NicholasTran/G8_SwishSwooshSwordSimulator/src/mid_demo/mid_demo.runs/impl_1/.init_design.begin.rst

<?xml version="1.0"?>
<ProcessHandle Version="1" Minor="0">
    <Process Command=".planAhead." Owner="Sam" Host="THEDESKTOP" Pid="17220">
    </Process>
</ProcessHandle>
