NicholasTran/G8_SwishSwooshSwordSimulator/src/mid_demo/mid_demo.runs/impl_1/.vivado.begin.rst

<?xml version="1.0"?>
<ProcessHandle Version="1" Minor="0">
    <Process Command="vivado.bat" Owner="Sam" Host="THEDESKTOP" Pid="20408">
    </Process>
</ProcessHandle>
