NicholasTran/G8_SwishSwooshSwordSimulator/src/mid_demo/mid_demo.runs/mid_project_axi_uartlite_0_0_synth_1/.vivado.begin.rst

<?xml version="1.0"?>
<ProcessHandle Version="1" Minor="0">
    <Process Command="vivado.bat" Owner="hopmanha" Host="BA3135WS29" Pid="11088">
    </Process>
</ProcessHandle>
