NicholasTran/G8_SwishSwooshSwordSimulator/docs/Presentation.pdf

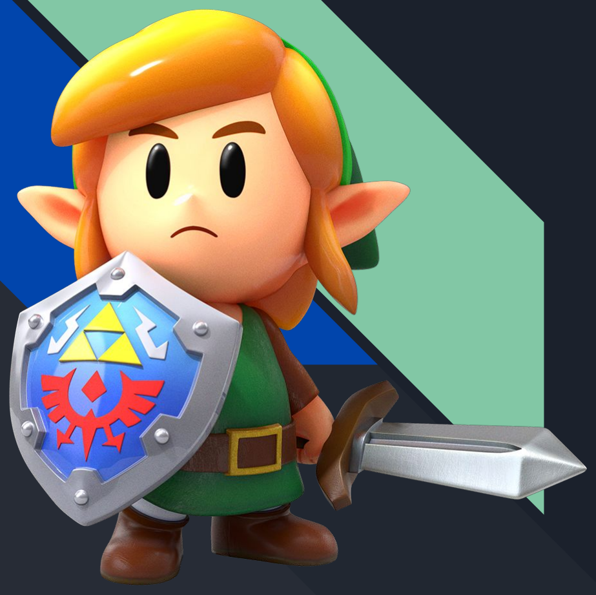
[picture p13: figure]

ECE532 - Final Demo

Gavin Gu
Nick Tran
Harry Hopman
Samuel Zheng

# Swish Slash Swoosh Super Savage Sword-Swinging Simulator 2023

## ver 2.23α (https://en.wiktionary.org/wiki/%CE%B1) (Final Release)

# Overview

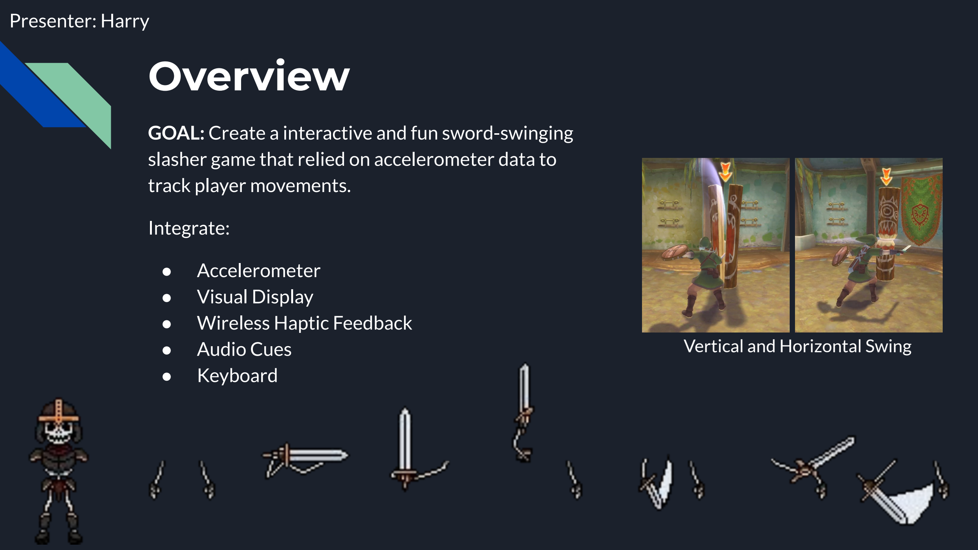
[picture p14: page 2]

Vertical and Horizontal Swing

GOAL: Create a interactive and fun sword-swinging slasher game that relied on accelerometer data to track player movements.

Integrate:

- Accelerometer
- Visual Display
- Wireless Haptic Feedback
- Audio Cues
- Keyboard

Presenter: Harry

# Initial Block Diagram

Presenter: Sam

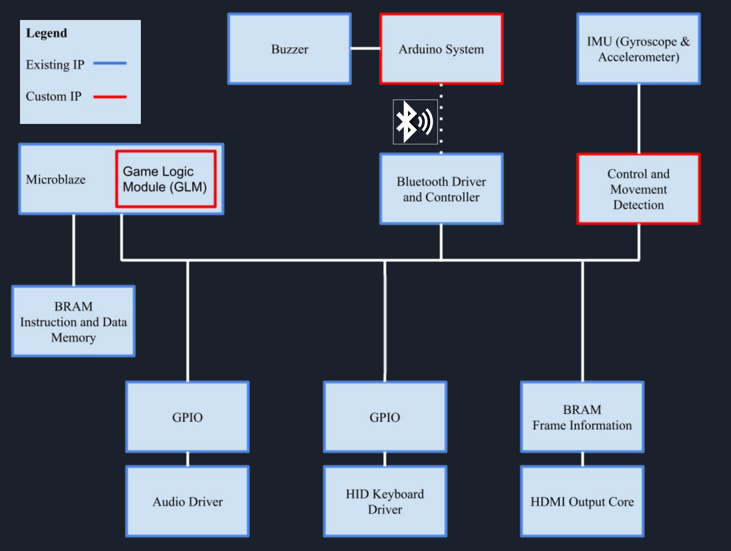
[picture p15: figure]

Microblaze

Audio Core

Game Logic &
Movement
Detection

AXI TFT
Controller

AXI Bus

BT2 Bluetooth
Controller

Instruction &
Data BRAM

VGA Monitor

DDR2 Double
Frame Buffer

Arduino
System

Vibration
Motor

NAV
Accelerometer

USB
Keyboard

New/Modified Blocks
(From Initial Proposal)

Presenter: Sam

# Final Block Diagram

7 Seg
Display

# Switch from Nexys Video to Nexys 4 DDR

Presenter: Nick

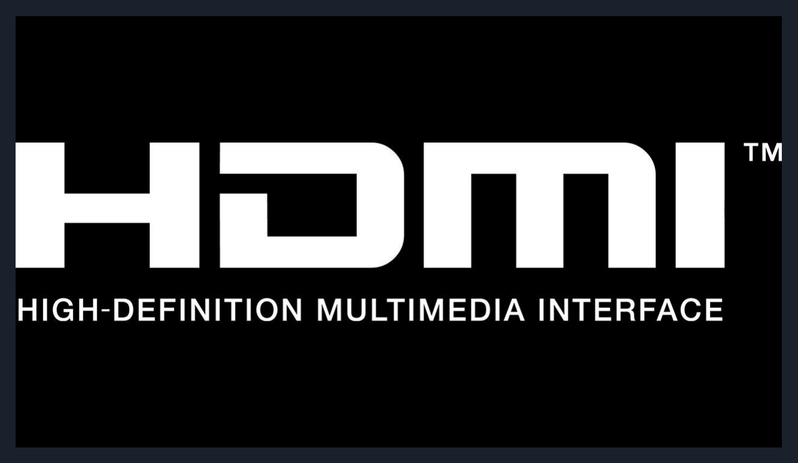
[picture p16: figure]
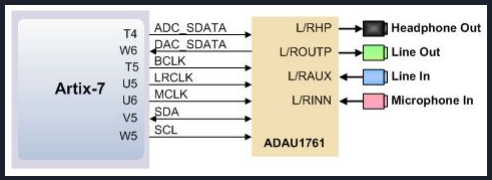
[picture p17: figure]

- Broken, outdated demos
- Lack of documentation
- Huge Complexity Jump

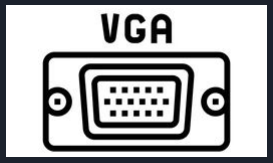
[picture p18: figure]
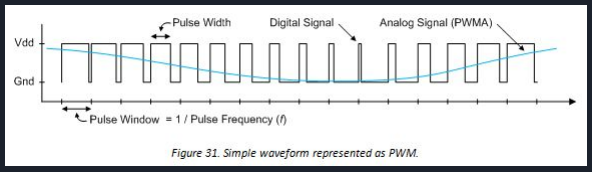
[picture p19: figure]

- Simpler Interfaces
- More Documentation
- Previous Experience

# Code/Block Originality

Original | Borrowed / Modified

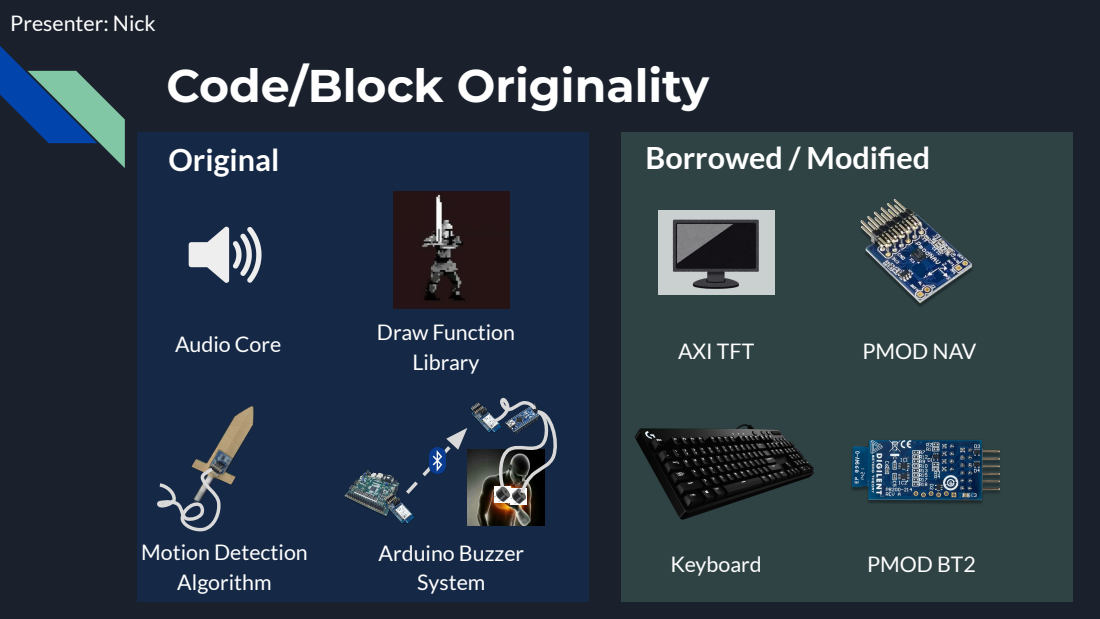
[picture p20: page 6]
Presenter: Nick; Audio Core; AXI TFT; Motion Detection Algorithm; Draw Function; Library; PMOD NAV; PMOD BT2

Keyboard Arduino Buzzer
System

# Custom Audio Core

- Each note encoded as 16-bit value, stored in ROM block
- Decode this value to get variables needed to play note as PWM wave
- Frequency, duty cycle, etc.
- Songs and SFX are sequences of these notes w/ duration

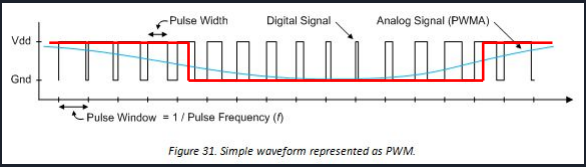
[picture p21: figure]

# Draw Function Library

SwapDrawBuffers()

Buffer 1

Buffer 2

BRAM | DrawEnemy
AXI TFT | Convert16bpp24 | DrawPixel

# Motion Detection Algorithm

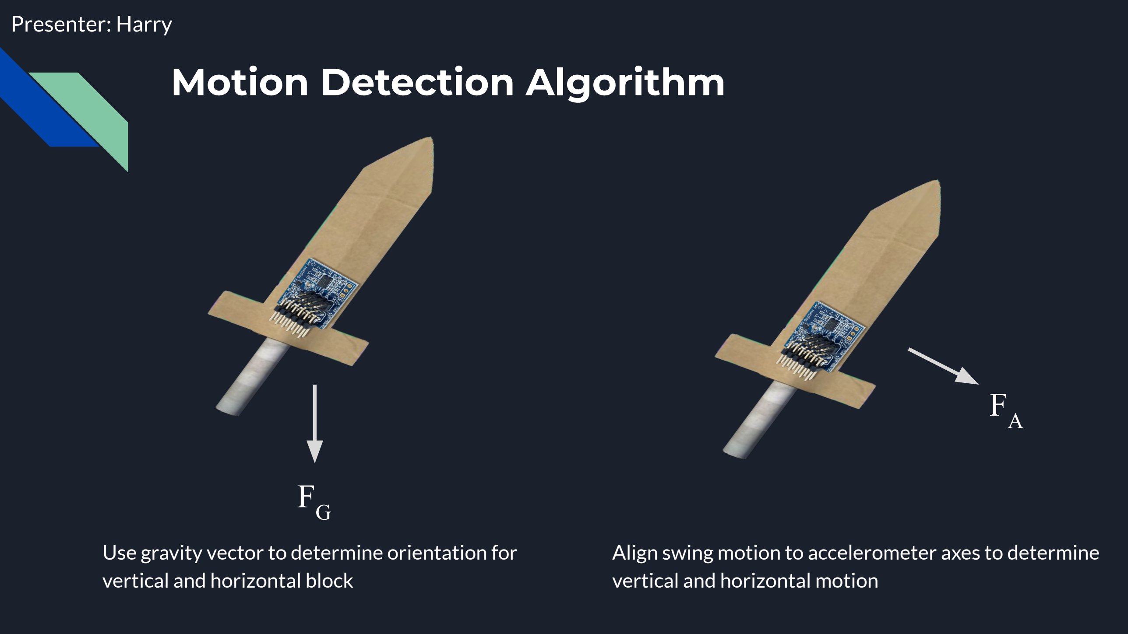
[picture p22: page 9]

Use gravity vector to determine orientation for vertical and horizontal block

Align swing motion to accelerometer axes to determine vertical and horizontal motion

FG

FA

Presenter: Harry

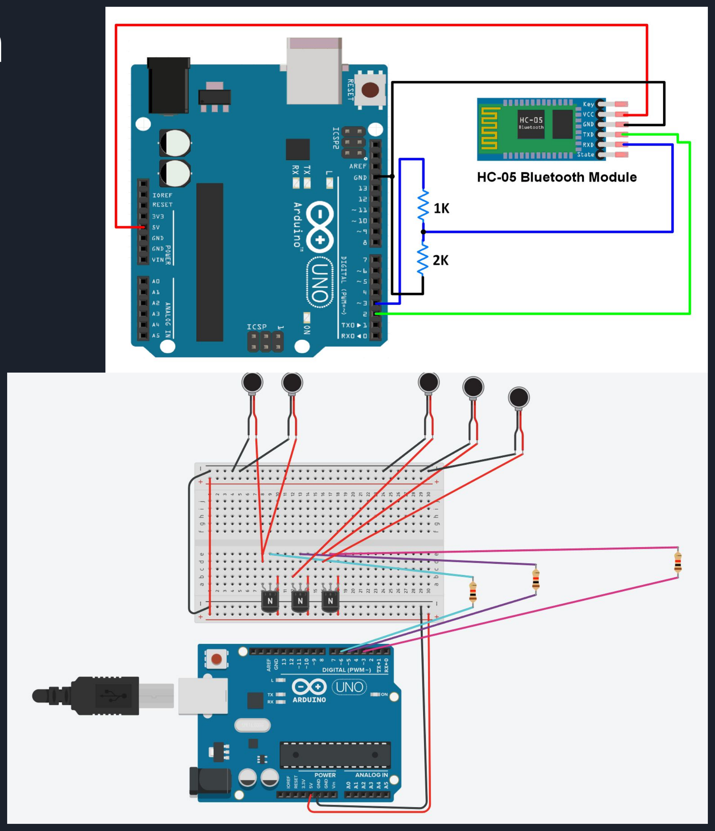
[picture p23: figure]

# Arduino Buzzer System

Sequence of events:

- PMOD BT-2 initializes as master
- When powered, auto connects to HC-05 slave address at specified 115200 baud rate
- Serial connection established, status LED on HC-05 slowly blinks
- HC-05 waits for BT-2 to send commands to activate vibration motors through Arduino based on vertical or horizontal slash

Presenter: Gavin

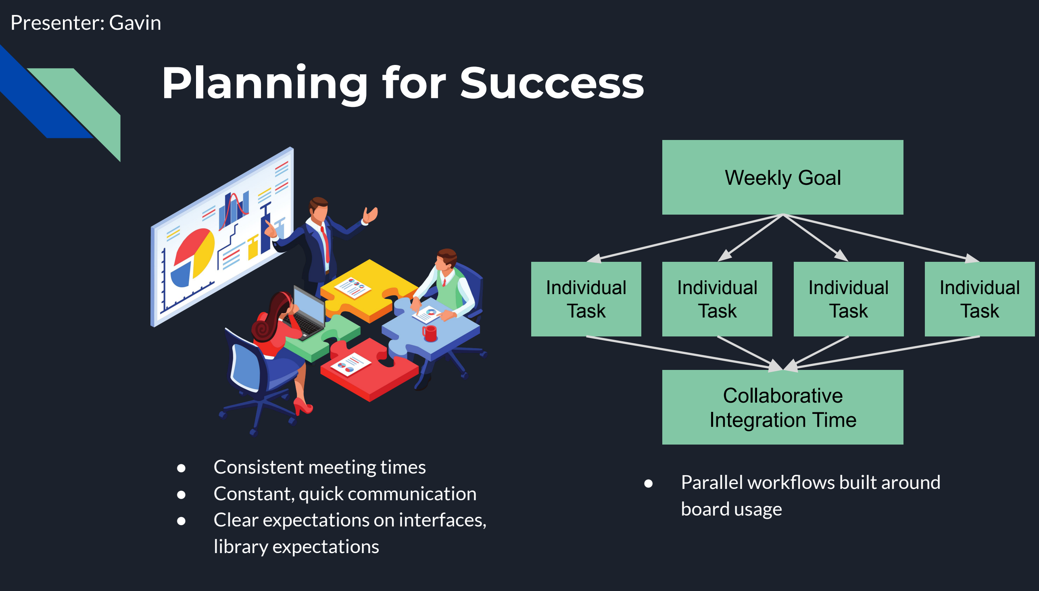
[picture p24: figure]
Planning for Success; Presenter: Gavin; ● Consistent meeting times ● Constant, quick communication ● Clear expectations on interfaces, library expectations; Weekly Goal; ● Parallel workflows built around board usage; Individual Task; Collaborative Integration Time

# Learnings

- Hands on experience designing around an AXI system
- Designing with large systems / multiple individual code blocks / multiple designers
- What Pulse Wave Modulation (PWM) is and how to implement in via square waves
- Learned how to pair a different bluetooth module to the PMOD BT2
- General hardware design debugging tips
- Good idea to start over when encountering odd bugs
- Debugging unpredictable issues
- Working as a team

Presenter: Harry

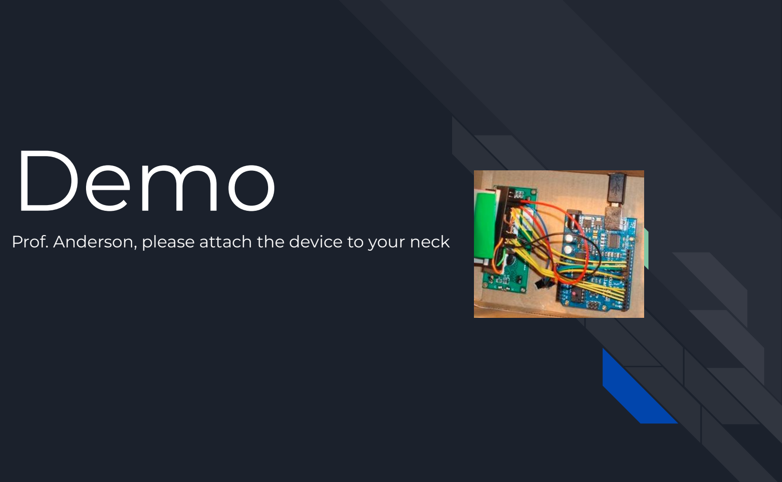
[picture p25: figure]
Demo

### Prof. Anderson, please attach the device to your neck

# Custom Audio Core

- Each note has individual frequency
- Duty cycle needs to slowly increase or decrease
- Unique to each frequency (note)
- Calculated beforehand and stored in ROM to avoid messy division

during runtime

- Each song is a sequence of notes with a duration

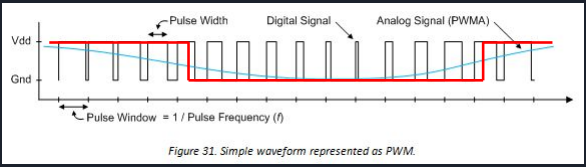
[picture p26: figure]
