NicholasTran/G8_SwishSwooshSwordSimulator/src/mid_demo/mid_demo.runs/mid_project_PmodNAV_0_0_synth_1/.Xil/mid_project_PmodNAV_0_0_propImpl.xdc

set_property SRC_FILE_INFO {cfile:d:/ece532/mid_demo/mid_demo/mid_demo.srcs/sources_1/bd/mid_project/ip/mid_project_PmodNAV_0_0/mid_project_PmodNAV_0_0_board.xdc rfile:../../../mid_demo.srcs/sources_1/bd/mid_project/ip/mid_project_PmodNAV_0_0/mid_project_PmodNAV_0_0_board.xdc id:1 order:EARLY used_in_board:yes scoped_inst:inst prop_thru_buffer:yes} [current_design]
set_property SRC_FILE_INFO {cfile:C:/DESL/Xilinx/Vivado/2018.3/data/ip/xpm/xpm_cdc/tcl/xpm_cdc_gray.tcl rfile:C:/DESL/Xilinx/Vivado/2018.3/data/ip/xpm/xpm_cdc/tcl/xpm_cdc_gray.tcl id:2 order:LATE scoped_inst:inst/axi_quad_spi_0/U0/NO_DUAL_QUAD_MODE.QSPI_NORMAL/QSPI_LEGACY_MD_GEN.QSPI_CORE_INTERFACE_I/FIFO_EXISTS.RX_FIFO_II/xpm_fifo_instance.xpm_fifo_async_inst/gnuram_async_fifo.xpm_fifo_base_inst/gen_cdc_pntr.rd_pntr_cdc_inst unmanaged:yes} [current_design]
set_property SRC_FILE_INFO {cfile:C:/DESL/Xilinx/Vivado/2018.3/data/ip/xpm/xpm_cdc/tcl/xpm_cdc_gray.tcl rfile:C:/DESL/Xilinx/Vivado/2018.3/data/ip/xpm/xpm_cdc/tcl/xpm_cdc_gray.tcl id:3 order:LATE scoped_inst:inst/axi_quad_spi_0/U0/NO_DUAL_QUAD_MODE.QSPI_NORMAL/QSPI_LEGACY_MD_GEN.QSPI_CORE_INTERFACE_I/FIFO_EXISTS.RX_FIFO_II/xpm_fifo_instance.xpm_fifo_async_inst/gnuram_async_fifo.xpm_fifo_base_inst/gen_cdc_pntr.wr_pntr_cdc_inst unmanaged:yes} [current_design]
set_property SRC_FILE_INFO {cfile:C:/DESL/Xilinx/Vivado/2018.3/data/ip/xpm/xpm_cdc/tcl/xpm_cdc_gray.tcl rfile:C:/DESL/Xilinx/Vivado/2018.3/data/ip/xpm/xpm_cdc/tcl/xpm_cdc_gray.tcl id:4 order:LATE scoped_inst:inst/axi_quad_spi_0/U0/NO_DUAL_QUAD_MODE.QSPI_NORMAL/QSPI_LEGACY_MD_GEN.QSPI_CORE_INTERFACE_I/FIFO_EXISTS.TX_FIFO_II/xpm_fifo_instance.xpm_fifo_async_inst/gnuram_async_fifo.xpm_fifo_base_inst/gen_cdc_pntr.rd_pntr_cdc_inst unmanaged:yes} [current_design]
set_property SRC_FILE_INFO {cfile:C:/DESL/Xilinx/Vivado/2018.3/data/ip/xpm/xpm_cdc/tcl/xpm_cdc_gray.tcl rfile:C:/DESL/Xilinx/Vivado/2018.3/data/ip/xpm/xpm_cdc/tcl/xpm_cdc_gray.tcl id:5 order:LATE scoped_inst:inst/axi_quad_spi_0/U0/NO_DUAL_QUAD_MODE.QSPI_NORMAL/QSPI_LEGACY_MD_GEN.QSPI_CORE_INTERFACE_I/FIFO_EXISTS.TX_FIFO_II/xpm_fifo_instance.xpm_fifo_async_inst/gnuram_async_fifo.xpm_fifo_base_inst/gen_cdc_pntr.wr_pntr_cdc_inst unmanaged:yes} [current_design]
set_property SRC_FILE_INFO {cfile:C:/DESL/Xilinx/Vivado/2018.3/data/ip/xpm/xpm_cdc/tcl/xpm_cdc_gray.tcl rfile:C:/DESL/Xilinx/Vivado/2018.3/data/ip/xpm/xpm_cdc/tcl/xpm_cdc_gray.tcl id:6 order:LATE scoped_inst:inst/axi_quad_spi_0/U0/NO_DUAL_QUAD_MODE.QSPI_NORMAL/QSPI_LEGACY_MD_GEN.QSPI_CORE_INTERFACE_I/FIFO_EXISTS.RX_FIFO_II/xpm_fifo_instance.xpm_fifo_async_inst/gnuram_async_fifo.xpm_fifo_base_inst/gen_cdc_pntr.wr_pntr_cdc_dc_inst unmanaged:yes} [current_design]
set_property SRC_FILE_INFO {cfile:C:/DESL/Xilinx/Vivado/2018.3/data/ip/xpm/xpm_cdc/tcl/xpm_cdc_gray.tcl rfile:C:/DESL/Xilinx/Vivado/2018.3/data/ip/xpm/xpm_cdc/tcl/xpm_cdc_gray.tcl id:7 order:LATE scoped_inst:inst/axi_quad_spi_0/U0/NO_DUAL_QUAD_MODE.QSPI_NORMAL/QSPI_LEGACY_MD_GEN.QSPI_CORE_INTERFACE_I/FIFO_EXISTS.TX_FIFO_II/xpm_fifo_instance.xpm_fifo_async_inst/gnuram_async_fifo.xpm_fifo_base_inst/gen_cdc_pntr.wr_pntr_cdc_dc_inst unmanaged:yes} [current_design]
set_property SRC_FILE_INFO {cfile:C:/DESL/Xilinx/Vivado/2018.3/data/ip/xpm/xpm_cdc/tcl/xpm_cdc_gray.tcl rfile:C:/DESL/Xilinx/Vivado/2018.3/data/ip/xpm/xpm_cdc/tcl/xpm_cdc_gray.tcl id:8 order:LATE scoped_inst:inst/axi_quad_spi_0/U0/NO_DUAL_QUAD_MODE.QSPI_NORMAL/QSPI_LEGACY_MD_GEN.QSPI_CORE_INTERFACE_I/FIFO_EXISTS.RX_FIFO_II/xpm_fifo_instance.xpm_fifo_async_inst/gnuram_async_fifo.xpm_fifo_base_inst/gen_cdc_pntr.rd_pntr_cdc_dc_inst unmanaged:yes} [current_design]
set_property SRC_FILE_INFO {cfile:C:/DESL/Xilinx/Vivado/2018.3/data/ip/xpm/xpm_cdc/tcl/xpm_cdc_gray.tcl rfile:C:/DESL/Xilinx/Vivado/2018.3/data/ip/xpm/xpm_cdc/tcl/xpm_cdc_gray.tcl id:9 order:LATE scoped_inst:inst/axi_quad_spi_0/U0/NO_DUAL_QUAD_MODE.QSPI_NORMAL/QSPI_LEGACY_MD_GEN.QSPI_CORE_INTERFACE_I/FIFO_EXISTS.TX_FIFO_II/xpm_fifo_instance.xpm_fifo_async_inst/gnuram_async_fifo.xpm_fifo_base_inst/gen_cdc_pntr.rd_pntr_cdc_dc_inst unmanaged:yes} [current_design]
current_instance inst
set_property src_info {type:SCOPED_XDC file:1 line:3 export:INPUT save:INPUT read:READ} [current_design]
set_property BOARD_PIN {JA1} [get_ports Pmod_out_pin1_t]
set_property src_info {type:SCOPED_XDC file:1 line:9 export:INPUT save:INPUT read:READ} [current_design]
set_property BOARD_PIN {JA9} [get_ports Pmod_out_pin9_t]
set_property src_info {type:SCOPED_XDC file:1 line:10 export:INPUT save:INPUT read:READ} [current_design]
set_property BOARD_PIN {JA10} [get_ports Pmod_out_pin10_t]
current_instance
current_instance inst/axi_quad_spi_0/U0/NO_DUAL_QUAD_MODE.QSPI_NORMAL/QSPI_LEGACY_MD_GEN.QSPI_CORE_INTERFACE_I/FIFO_EXISTS.RX_FIFO_II/xpm_fifo_instance.xpm_fifo_async_inst/gnuram_async_fifo.xpm_fifo_base_inst/gen_cdc_pntr.rd_pntr_cdc_inst
set_property src_info {type:SCOPED_XDC file:2 line:23 export:INPUT save:NONE read:READ} [current_design]
create_waiver -internal -type CDC -id {CDC-6} -user "xpm_cdc" -desc "The CDC-6 warning is waived as it is safe in the context of XPM_CDC_GRAY." -from [get_pins -quiet {src_gray_ff_reg*/C}] -to [get_pins -quiet {dest_graysync_ff_reg*/D}]
current_instance
current_instance inst/axi_quad_spi_0/U0/NO_DUAL_QUAD_MODE.QSPI_NORMAL/QSPI_LEGACY_MD_GEN.QSPI_CORE_INTERFACE_I/FIFO_EXISTS.RX_FIFO_II/xpm_fifo_instance.xpm_fifo_async_inst/gnuram_async_fifo.xpm_fifo_base_inst/gen_cdc_pntr.wr_pntr_cdc_inst
set_property src_info {type:SCOPED_XDC file:3 line:23 export:INPUT save:NONE read:READ} [current_design]
create_waiver -internal -type CDC -id {CDC-6} -user "xpm_cdc" -desc "The CDC-6 warning is waived as it is safe in the context of XPM_CDC_GRAY." -from [get_pins -quiet {src_gray_ff_reg*/C}] -to [get_pins -quiet {dest_graysync_ff_reg*/D}]
current_instance
current_instance inst/axi_quad_spi_0/U0/NO_DUAL_QUAD_MODE.QSPI_NORMAL/QSPI_LEGACY_MD_GEN.QSPI_CORE_INTERFACE_I/FIFO_EXISTS.TX_FIFO_II/xpm_fifo_instance.xpm_fifo_async_inst/gnuram_async_fifo.xpm_fifo_base_inst/gen_cdc_pntr.rd_pntr_cdc_inst
set_property src_info {type:SCOPED_XDC file:4 line:23 export:INPUT save:NONE read:READ} [current_design]
create_waiver -internal -type CDC -id {CDC-6} -user "xpm_cdc" -desc "The CDC-6 warning is waived as it is safe in the context of XPM_CDC_GRAY." -from [get_pins -quiet {src_gray_ff_reg*/C}] -to [get_pins -quiet {dest_graysync_ff_reg*/D}]
current_instance
current_instance inst/axi_quad_spi_0/U0/NO_DUAL_QUAD_MODE.QSPI_NORMAL/QSPI_LEGACY_MD_GEN.QSPI_CORE_INTERFACE_I/FIFO_EXISTS.TX_FIFO_II/xpm_fifo_instance.xpm_fifo_async_inst/gnuram_async_fifo.xpm_fifo_base_inst/gen_cdc_pntr.wr_pntr_cdc_inst
set_property src_info {type:SCOPED_XDC file:5 line:23 export:INPUT save:NONE read:READ} [current_design]
create_waiver -internal -type CDC -id {CDC-6} -user "xpm_cdc" -desc "The CDC-6 warning is waived as it is safe in the context of XPM_CDC_GRAY." -from [get_pins -quiet {src_gray_ff_reg*/C}] -to [get_pins -quiet {dest_graysync_ff_reg*/D}]
current_instance
current_instance inst/axi_quad_spi_0/U0/NO_DUAL_QUAD_MODE.QSPI_NORMAL/QSPI_LEGACY_MD_GEN.QSPI_CORE_INTERFACE_I/FIFO_EXISTS.RX_FIFO_II/xpm_fifo_instance.xpm_fifo_async_inst/gnuram_async_fifo.xpm_fifo_base_inst/gen_cdc_pntr.wr_pntr_cdc_dc_inst
set_property src_info {type:SCOPED_XDC file:6 line:23 export:INPUT save:NONE read:READ} [current_design]
create_waiver -internal -type CDC -id {CDC-6} -user "xpm_cdc" -desc "The CDC-6 warning is waived as it is safe in the context of XPM_CDC_GRAY." -from [get_pins -quiet {src_gray_ff_reg*/C}] -to [get_pins -quiet {dest_graysync_ff_reg*/D}]
current_instance
current_instance inst/axi_quad_spi_0/U0/NO_DUAL_QUAD_MODE.QSPI_NORMAL/QSPI_LEGACY_MD_GEN.QSPI_CORE_INTERFACE_I/FIFO_EXISTS.TX_FIFO_II/xpm_fifo_instance.xpm_fifo_async_inst/gnuram_async_fifo.xpm_fifo_base_inst/gen_cdc_pntr.wr_pntr_cdc_dc_inst
set_property src_info {type:SCOPED_XDC file:7 line:23 export:INPUT save:NONE read:READ} [current_design]
create_waiver -internal -type CDC -id {CDC-6} -user "xpm_cdc" -desc "The CDC-6 warning is waived as it is safe in the context of XPM_CDC_GRAY." -from [get_pins -quiet {src_gray_ff_reg*/C}] -to [get_pins -quiet {dest_graysync_ff_reg*/D}]
current_instance
current_instance inst/axi_quad_spi_0/U0/NO_DUAL_QUAD_MODE.QSPI_NORMAL/QSPI_LEGACY_MD_GEN.QSPI_CORE_INTERFACE_I/FIFO_EXISTS.RX_FIFO_II/xpm_fifo_instance.xpm_fifo_async_inst/gnuram_async_fifo.xpm_fifo_base_inst/gen_cdc_pntr.rd_pntr_cdc_dc_inst
set_property src_info {type:SCOPED_XDC file:8 line:23 export:INPUT save:NONE read:READ} [current_design]
create_waiver -internal -type CDC -id {CDC-6} -user "xpm_cdc" -desc "The CDC-6 warning is waived as it is safe in the context of XPM_CDC_GRAY." -from [get_pins -quiet {src_gray_ff_reg*/C}] -to [get_pins -quiet {dest_graysync_ff_reg*/D}]
current_instance
current_instance inst/axi_quad_spi_0/U0/NO_DUAL_QUAD_MODE.QSPI_NORMAL/QSPI_LEGACY_MD_GEN.QSPI_CORE_INTERFACE_I/FIFO_EXISTS.TX_FIFO_II/xpm_fifo_instance.xpm_fifo_async_inst/gnuram_async_fifo.xpm_fifo_base_inst/gen_cdc_pntr.rd_pntr_cdc_dc_inst
set_property src_info {type:SCOPED_XDC file:9 line:23 export:INPUT save:NONE read:READ} [current_design]
create_waiver -internal -type CDC -id {CDC-6} -user "xpm_cdc" -desc "The CDC-6 warning is waived as it is safe in the context of XPM_CDC_GRAY." -from [get_pins -quiet {src_gray_ff_reg*/C}] -to [get_pins -quiet {dest_graysync_ff_reg*/D}]
