NicholasTran/G8_SwishSwooshSwordSimulator/src/mid_demo/mid_demo.runs/synth_1/.Xil/mid_project_wrapper_propImpl.xdc

set_property SRC_FILE_INFO {cfile:C:/Users/Sam/Desktop/ECE532/mid_demo_v6_timer_gtracker/mid_demo/mid_demo.srcs/constrs_1/imports/mid_demo/microblaze.xdc rfile:../../../mid_demo.srcs/constrs_1/imports/mid_demo/microblaze.xdc id:1} [current_design]
set_property src_info {type:XDC file:1 line:7 export:INPUT save:INPUT read:READ} [current_design]
set_property -dict {PACKAGE_PIN E3 IOSTANDARD LVCMOS33} [get_ports clk_100MHz]
set_property src_info {type:XDC file:1 line:56 export:INPUT save:INPUT read:READ} [current_design]
set_property -dict {PACKAGE_PIN T10 IOSTANDARD LVCMOS33} [get_ports {SEG[0]}]
set_property src_info {type:XDC file:1 line:57 export:INPUT save:INPUT read:READ} [current_design]
set_property -dict {PACKAGE_PIN R10 IOSTANDARD LVCMOS33} [get_ports {SEG[1]}]
set_property src_info {type:XDC file:1 line:58 export:INPUT save:INPUT read:READ} [current_design]
set_property -dict {PACKAGE_PIN K16 IOSTANDARD LVCMOS33} [get_ports {SEG[2]}]
set_property src_info {type:XDC file:1 line:59 export:INPUT save:INPUT read:READ} [current_design]
set_property -dict {PACKAGE_PIN K13 IOSTANDARD LVCMOS33} [get_ports {SEG[3]}]
set_property src_info {type:XDC file:1 line:60 export:INPUT save:INPUT read:READ} [current_design]
set_property -dict {PACKAGE_PIN P15 IOSTANDARD LVCMOS33} [get_ports {SEG[4]}]
set_property src_info {type:XDC file:1 line:61 export:INPUT save:INPUT read:READ} [current_design]
set_property -dict {PACKAGE_PIN T11 IOSTANDARD LVCMOS33} [get_ports {SEG[5]}]
set_property src_info {type:XDC file:1 line:62 export:INPUT save:INPUT read:READ} [current_design]
set_property -dict {PACKAGE_PIN L18 IOSTANDARD LVCMOS33} [get_ports {SEG[6]}]
set_property src_info {type:XDC file:1 line:64 export:INPUT save:INPUT read:READ} [current_design]
set_property -dict {PACKAGE_PIN H15 IOSTANDARD LVCMOS33} [get_ports DP]
set_property src_info {type:XDC file:1 line:66 export:INPUT save:INPUT read:READ} [current_design]
set_property -dict {PACKAGE_PIN J17 IOSTANDARD LVCMOS33} [get_ports {AN[0]}]
set_property src_info {type:XDC file:1 line:67 export:INPUT save:INPUT read:READ} [current_design]
set_property -dict {PACKAGE_PIN J18 IOSTANDARD LVCMOS33} [get_ports {AN[1]}]
set_property src_info {type:XDC file:1 line:68 export:INPUT save:INPUT read:READ} [current_design]
set_property -dict {PACKAGE_PIN T9 IOSTANDARD LVCMOS33} [get_ports {AN[2]}]
set_property src_info {type:XDC file:1 line:69 export:INPUT save:INPUT read:READ} [current_design]
set_property -dict {PACKAGE_PIN J14 IOSTANDARD LVCMOS33} [get_ports {AN[3]}]
set_property src_info {type:XDC file:1 line:70 export:INPUT save:INPUT read:READ} [current_design]
set_property -dict {PACKAGE_PIN P14 IOSTANDARD LVCMOS33} [get_ports {AN[4]}]
set_property src_info {type:XDC file:1 line:71 export:INPUT save:INPUT read:READ} [current_design]
set_property -dict {PACKAGE_PIN T14 IOSTANDARD LVCMOS33} [get_ports {AN[5]}]
set_property src_info {type:XDC file:1 line:72 export:INPUT save:INPUT read:READ} [current_design]
set_property -dict {PACKAGE_PIN K2 IOSTANDARD LVCMOS33} [get_ports {AN[6]}]
set_property src_info {type:XDC file:1 line:73 export:INPUT save:INPUT read:READ} [current_design]
set_property -dict {PACKAGE_PIN U13 IOSTANDARD LVCMOS33} [get_ports {AN[7]}]
set_property src_info {type:XDC file:1 line:78 export:INPUT save:INPUT read:READ} [current_design]
set_property -dict {PACKAGE_PIN C12 IOSTANDARD LVCMOS33} [get_ports reset_rtl_0]
set_property src_info {type:XDC file:1 line:92 export:INPUT save:INPUT read:READ} [current_design]
set_property -dict {PACKAGE_PIN F16 IOSTANDARD LVCMOS33} [get_ports uart_bt2_txd]
set_property src_info {type:XDC file:1 line:93 export:INPUT save:INPUT read:READ} [current_design]
set_property -dict {PACKAGE_PIN G16 IOSTANDARD LVCMOS33} [get_ports uart_bt2_rxd]
set_property src_info {type:XDC file:1 line:139 export:INPUT save:INPUT read:READ} [current_design]
set_property -dict {PACKAGE_PIN A3 IOSTANDARD LVCMOS33} [get_ports {tft_vga_r[0]}]
set_property src_info {type:XDC file:1 line:140 export:INPUT save:INPUT read:READ} [current_design]
set_property -dict {PACKAGE_PIN B4 IOSTANDARD LVCMOS33} [get_ports {tft_vga_r[1]}]
set_property src_info {type:XDC file:1 line:141 export:INPUT save:INPUT read:READ} [current_design]
set_property -dict {PACKAGE_PIN C5 IOSTANDARD LVCMOS33} [get_ports {tft_vga_r[2]}]
set_property src_info {type:XDC file:1 line:142 export:INPUT save:INPUT read:READ} [current_design]
set_property -dict {PACKAGE_PIN A4 IOSTANDARD LVCMOS33} [get_ports {tft_vga_r[3]}]
set_property src_info {type:XDC file:1 line:144 export:INPUT save:INPUT read:READ} [current_design]
set_property -dict {PACKAGE_PIN C6 IOSTANDARD LVCMOS33} [get_ports {tft_vga_g[0]}]
set_property src_info {type:XDC file:1 line:145 export:INPUT save:INPUT read:READ} [current_design]
set_property -dict {PACKAGE_PIN A5 IOSTANDARD LVCMOS33} [get_ports {tft_vga_g[1]}]
set_property src_info {type:XDC file:1 line:146 export:INPUT save:INPUT read:READ} [current_design]
set_property -dict {PACKAGE_PIN B6 IOSTANDARD LVCMOS33} [get_ports {tft_vga_g[2]}]
set_property src_info {type:XDC file:1 line:147 export:INPUT save:INPUT read:READ} [current_design]
set_property -dict {PACKAGE_PIN A6 IOSTANDARD LVCMOS33} [get_ports {tft_vga_g[3]}]
set_property src_info {type:XDC file:1 line:149 export:INPUT save:INPUT read:READ} [current_design]
set_property -dict {PACKAGE_PIN B7 IOSTANDARD LVCMOS33} [get_ports {tft_vga_b[0]}]
set_property src_info {type:XDC file:1 line:150 export:INPUT save:INPUT read:READ} [current_design]
set_property -dict {PACKAGE_PIN C7 IOSTANDARD LVCMOS33} [get_ports {tft_vga_b[1]}]
set_property src_info {type:XDC file:1 line:151 export:INPUT save:INPUT read:READ} [current_design]
set_property -dict {PACKAGE_PIN D7 IOSTANDARD LVCMOS33} [get_ports {tft_vga_b[2]}]
set_property src_info {type:XDC file:1 line:152 export:INPUT save:INPUT read:READ} [current_design]
set_property -dict {PACKAGE_PIN D8 IOSTANDARD LVCMOS33} [get_ports {tft_vga_b[3]}]
set_property src_info {type:XDC file:1 line:154 export:INPUT save:INPUT read:READ} [current_design]
set_property -dict {PACKAGE_PIN B11 IOSTANDARD LVCMOS33} [get_ports tft_hsync]
set_property src_info {type:XDC file:1 line:155 export:INPUT save:INPUT read:READ} [current_design]
set_property -dict {PACKAGE_PIN B12 IOSTANDARD LVCMOS33} [get_ports tft_vsync]
set_property src_info {type:XDC file:1 line:196 export:INPUT save:INPUT read:READ} [current_design]
set_property -dict {PACKAGE_PIN A11 IOSTANDARD LVCMOS33} [get_ports aud_out]
set_property src_info {type:XDC file:1 line:197 export:INPUT save:INPUT read:READ} [current_design]
set_property -dict {PACKAGE_PIN D12 IOSTANDARD LVCMOS33} [get_ports aud_en]
set_property src_info {type:XDC file:1 line:208 export:INPUT save:INPUT read:READ} [current_design]
set_property -dict { PACKAGE_PIN F4    IOSTANDARD LVCMOS33 } [get_ports { PS_THING }]; #IO_L13P_T2_MRCC_35 Sch=ps2_clk
set_property src_info {type:XDC file:1 line:209 export:INPUT save:INPUT read:READ} [current_design]
set_property -dict { PACKAGE_PIN B2    IOSTANDARD LVCMOS33 } [get_ports { PS_DATA }]; #IO_L10N_T1_AD15N_35 Sch=ps2_data
