NicholasTran/G8_SwishSwooshSwordSimulator/src/mid_demo/mid_demo.ip_user_files/bd/mid_project/ip/mid_project_PmodNAV_0_0/sim/mid_project_PmodNAV_0_0.v

// (c) Copyright 1995-2023 Xilinx, Inc. All rights reserved.
// 
// This file contains confidential and proprietary information
// of Xilinx, Inc. and is protected under U.S. and
// international copyright and other intellectual property
// laws.
// 
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
// CRITICAL APPLICATIONS
// Xilinx products are not designed or intended to be fail-
// safe, or for use in any application requiring fail-safe
// performance, such as life-support or safety devices or
// systems, Class III medical devices, nuclear facilities,
// applications related to the deployment of airbags, or any
// other applications that could lead to death, personal
// injury, or severe property or environmental damage
// (individually and collectively, "Critical
// Applications"). Customer assumes the sole risk and
// liability of any use of Xilinx products in Critical
// Applications, subject only to applicable laws and
// regulations governing limitations on product liability.
// 
// THIS COPYRIGHT NOTICE AND DISCLAIMER MUST BE RETAINED AS
// PART OF THIS FILE AT ALL TIMES.
// 
// DO NOT MODIFY THIS FILE.


// IP VLNV: digilentinc.com:IP:PmodNAV:1.0
// IP Revision: 10

`timescale 1ns/1ps

(* DowngradeIPIdentifiedWarnings = "yes" *)
module mid_project_PmodNAV_0_0 (
  AXI_LITE_GPIO_araddr,
  AXI_LITE_GPIO_arready,
  AXI_LITE_GPIO_arvalid,
  AXI_LITE_GPIO_awaddr,
  AXI_LITE_GPIO_awready,
  AXI_LITE_GPIO_awvalid,
  AXI_LITE_GPIO_bready,
  AXI_LITE_GPIO_bresp,
  AXI_LITE_GPIO_bvalid,
  AXI_LITE_GPIO_rdata,
  AXI_LITE_GPIO_rready,
  AXI_LITE_GPIO_rresp,
  AXI_LITE_GPIO_rvalid,
  AXI_LITE_GPIO_wdata,
  AXI_LITE_GPIO_wready,
  AXI_LITE_GPIO_wstrb,
  AXI_LITE_GPIO_wvalid,
  AXI_LITE_SPI_araddr,
  AXI_LITE_SPI_arready,
  AXI_LITE_SPI_arvalid,
  AXI_LITE_SPI_awaddr,
  AXI_LITE_SPI_awready,
  AXI_LITE_SPI_awvalid,
  AXI_LITE_SPI_bready,
  AXI_LITE_SPI_bresp,
  AXI_LITE_SPI_bvalid,
  AXI_LITE_SPI_rdata,
  AXI_LITE_SPI_rready,
  AXI_LITE_SPI_rresp,
  AXI_LITE_SPI_rvalid,
  AXI_LITE_SPI_wdata,
  AXI_LITE_SPI_wready,
  AXI_LITE_SPI_wstrb,
  AXI_LITE_SPI_wvalid,
  GPIO_Interrupt,
  Pmod_out_pin10_i,
  Pmod_out_pin10_o,
  Pmod_out_pin10_t,
  Pmod_out_pin1_i,
  Pmod_out_pin1_o,
  Pmod_out_pin1_t,
  Pmod_out_pin2_i,
  Pmod_out_pin2_o,
  Pmod_out_pin2_t,
  Pmod_out_pin3_i,
  Pmod_out_pin3_o,
  Pmod_out_pin3_t,
  Pmod_out_pin4_i,
  Pmod_out_pin4_o,
  Pmod_out_pin4_t,
  Pmod_out_pin7_i,
  Pmod_out_pin7_o,
  Pmod_out_pin7_t,
  Pmod_out_pin8_i,
  Pmod_out_pin8_o,
  Pmod_out_pin8_t,
  Pmod_out_pin9_i,
  Pmod_out_pin9_o,
  Pmod_out_pin9_t,
  SPI_Interrupt,
  ext_spi_clk,
  s_axi_aclk,
  s_axi_aresetn
);

(* X_INTERFACE_INFO = "xilinx.com:interface:aximm:1.0 AXI_LITE_GPIO ARADDR" *)
input wire [8 : 0] AXI_LITE_GPIO_araddr;
(* X_INTERFACE_INFO = "xilinx.com:interface:aximm:1.0 AXI_LITE_GPIO ARREADY" *)
output wire AXI_LITE_GPIO_arready;
(* X_INTERFACE_INFO = "xilinx.com:interface:aximm:1.0 AXI_LITE_GPIO ARVALID" *)
input wire AXI_LITE_GPIO_arvalid;
(* X_INTERFACE_INFO = "xilinx.com:interface:aximm:1.0 AXI_LITE_GPIO AWADDR" *)
input wire [8 : 0] AXI_LITE_GPIO_awaddr;
(* X_INTERFACE_INFO = "xilinx.com:interface:aximm:1.0 AXI_LITE_GPIO AWREADY" *)
output wire AXI_LITE_GPIO_awready;
(* X_INTERFACE_INFO = "xilinx.com:interface:aximm:1.0 AXI_LITE_GPIO AWVALID" *)
input wire AXI_LITE_GPIO_awvalid;
(* X_INTERFACE_INFO = "xilinx.com:interface:aximm:1.0 AXI_LITE_GPIO BREADY" *)
input wire AXI_LITE_GPIO_bready;
(* X_INTERFACE_INFO = "xilinx.com:interface:aximm:1.0 AXI_LITE_GPIO BRESP" *)
output wire [1 : 0] AXI_LITE_GPIO_bresp;
(* X_INTERFACE_INFO = "xilinx.com:interface:aximm:1.0 AXI_LITE_GPIO BVALID" *)
output wire AXI_LITE_GPIO_bvalid;
(* X_INTERFACE_INFO = "xilinx.com:interface:aximm:1.0 AXI_LITE_GPIO RDATA" *)
output wire [31 : 0] AXI_LITE_GPIO_rdata;
(* X_INTERFACE_INFO = "xilinx.com:interface:aximm:1.0 AXI_LITE_GPIO RREADY" *)
input wire AXI_LITE_GPIO_rready;
(* X_INTERFACE_INFO = "xilinx.com:interface:aximm:1.0 AXI_LITE_GPIO RRESP" *)
output wire [1 : 0] AXI_LITE_GPIO_rresp;
(* X_INTERFACE_INFO = "xilinx.com:interface:aximm:1.0 AXI_LITE_GPIO RVALID" *)
output wire AXI_LITE_GPIO_rvalid;
(* X_INTERFACE_INFO = "xilinx.com:interface:aximm:1.0 AXI_LITE_GPIO WDATA" *)
input wire [31 : 0] AXI_LITE_GPIO_wdata;
(* X_INTERFACE_INFO = "xilinx.com:interface:aximm:1.0 AXI_LITE_GPIO WREADY" *)
output wire AXI_LITE_GPIO_wready;
(* X_INTERFACE_INFO = "xilinx.com:interface:aximm:1.0 AXI_LITE_GPIO WSTRB" *)
input wire [3 : 0] AXI_LITE_GPIO_wstrb;
(* X_INTERFACE_PARAMETER = "XIL_INTERFACENAME AXI_LITE_GPIO, DATA_WIDTH 32, PROTOCOL AXI4LITE, ID_WIDTH 0, ADDR_WIDTH 16, AWUSER_WIDTH 0, ARUSER_WIDTH 0, WUSER_WIDTH 0, RUSER_WIDTH 0, BUSER_WIDTH 0, READ_WRITE_MODE READ_WRITE, HAS_BURST 0, HAS_LOCK 0, HAS_PROT 0, HAS_CACHE 0, HAS_QOS 0, HAS_REGION 0, HAS_WSTRB 1, HAS_BRESP 1, HAS_RRESP 1, SUPPORTS_NARROW_BURST 0, NUM_READ_OUTSTANDING 1, NUM_WRITE_OUTSTANDING 1, MAX_BURST_LENGTH 1, FREQ_HZ 100000000, PHASE 0.0, CLK_DOMAIN /clk_wiz_1_clk_out1, NUM_READ_THREADS 1, NUM_WRITE_T\
HREADS 1, RUSER_BITS_PER_BYTE 0, WUSER_BITS_PER_BYTE 0, INSERT_VIP 0" *)
(* X_INTERFACE_INFO = "xilinx.com:interface:aximm:1.0 AXI_LITE_GPIO WVALID" *)
input wire AXI_LITE_GPIO_wvalid;
(* X_INTERFACE_INFO = "xilinx.com:interface:aximm:1.0 AXI_LITE_SPI ARADDR" *)
input wire [6 : 0] AXI_LITE_SPI_araddr;
(* X_INTERFACE_INFO = "xilinx.com:interface:aximm:1.0 AXI_LITE_SPI ARREADY" *)
output wire AXI_LITE_SPI_arready;
(* X_INTERFACE_INFO = "xilinx.com:interface:aximm:1.0 AXI_LITE_SPI ARVALID" *)
input wire AXI_LITE_SPI_arvalid;
(* X_INTERFACE_INFO = "xilinx.com:interface:aximm:1.0 AXI_LITE_SPI AWADDR" *)
input wire [6 : 0] AXI_LITE_SPI_awaddr;
(* X_INTERFACE_INFO = "xilinx.com:interface:aximm:1.0 AXI_LITE_SPI AWREADY" *)
output wire AXI_LITE_SPI_awready;
(* X_INTERFACE_INFO = "xilinx.com:interface:aximm:1.0 AXI_LITE_SPI AWVALID" *)
input wire AXI_LITE_SPI_awvalid;
(* X_INTERFACE_INFO = "xilinx.com:interface:aximm:1.0 AXI_LITE_SPI BREADY" *)
input wire AXI_LITE_SPI_bready;
(* X_INTERFACE_INFO = "xilinx.com:interface:aximm:1.0 AXI_LITE_SPI BRESP" *)
output wire [1 : 0] AXI_LITE_SPI_bresp;
(* X_INTERFACE_INFO = "xilinx.com:interface:aximm:1.0 AXI_LITE_SPI BVALID" *)
output wire AXI_LITE_SPI_bvalid;
(* X_INTERFACE_INFO = "xilinx.com:interface:aximm:1.0 AXI_LITE_SPI RDATA" *)
output wire [31 : 0] AXI_LITE_SPI_rdata;
(* X_INTERFACE_INFO = "xilinx.com:interface:aximm:1.0 AXI_LITE_SPI RREADY" *)
input wire AXI_LITE_SPI_rready;
(* X_INTERFACE_INFO = "xilinx.com:interface:aximm:1.0 AXI_LITE_SPI RRESP" *)
output wire [1 : 0] AXI_LITE_SPI_rresp;
(* X_INTERFACE_INFO = "xilinx.com:interface:aximm:1.0 AXI_LITE_SPI RVALID" *)
output wire AXI_LITE_SPI_rvalid;
(* X_INTERFACE_INFO = "xilinx.com:interface:aximm:1.0 AXI_LITE_SPI WDATA" *)
input wire [31 : 0] AXI_LITE_SPI_wdata;
(* X_INTERFACE_INFO = "xilinx.com:interface:aximm:1.0 AXI_LITE_SPI WREADY" *)
output wire AXI_LITE_SPI_wready;
(* X_INTERFACE_INFO = "xilinx.com:interface:aximm:1.0 AXI_LITE_SPI WSTRB" *)
input wire [3 : 0] AXI_LITE_SPI_wstrb;
(* X_INTERFACE_PARAMETER = "XIL_INTERFACENAME AXI_LITE_SPI, DATA_WIDTH 32, PROTOCOL AXI4LITE, ID_WIDTH 0, ADDR_WIDTH 16, AWUSER_WIDTH 0, ARUSER_WIDTH 0, WUSER_WIDTH 0, RUSER_WIDTH 0, BUSER_WIDTH 0, READ_WRITE_MODE READ_WRITE, HAS_BURST 0, HAS_LOCK 0, HAS_PROT 0, HAS_CACHE 0, HAS_QOS 0, HAS_REGION 0, HAS_WSTRB 1, HAS_BRESP 1, HAS_RRESP 1, SUPPORTS_NARROW_BURST 0, NUM_READ_OUTSTANDING 1, NUM_WRITE_OUTSTANDING 1, MAX_BURST_LENGTH 1, FREQ_HZ 100000000, PHASE 0.0, CLK_DOMAIN /clk_wiz_1_clk_out1, NUM_READ_THREADS 1, NUM_WRITE_TH\
READS 1, RUSER_BITS_PER_BYTE 0, WUSER_BITS_PER_BYTE 0, INSERT_VIP 0" *)
(* X_INTERFACE_INFO = "xilinx.com:interface:aximm:1.0 AXI_LITE_SPI WVALID" *)
input wire AXI_LITE_SPI_wvalid;
(* X_INTERFACE_PARAMETER = "XIL_INTERFACENAME INTR.GPIO_INTERRUPT, SENSITIVITY LEVEL_HIGH, PortWidth 1, XIL_INTERFACENAME GPIO_Interrupt, SENSITIVITY LEVEL_HIGH, PortWidth 1" *)
(* X_INTERFACE_INFO = "xilinx.com:signal:interrupt:1.0 INTR.GPIO_INTERRUPT INTERRUPT, xilinx.com:signal:interrupt:1.0 GPIO_Interrupt INTERRUPT" *)
output wire GPIO_Interrupt;
(* X_INTERFACE_INFO = "digilentinc.com:interface:pmod:1.0 Pmod_out PIN10_I" *)
input wire Pmod_out_pin10_i;
(* X_INTERFACE_INFO = "digilentinc.com:interface:pmod:1.0 Pmod_out PIN10_O" *)
output wire Pmod_out_pin10_o;
(* X_INTERFACE_INFO = "digilentinc.com:interface:pmod:1.0 Pmod_out PIN10_T" *)
output wire Pmod_out_pin10_t;
(* X_INTERFACE_INFO = "digilentinc.com:interface:pmod:1.0 Pmod_out PIN1_I" *)
input wire Pmod_out_pin1_i;
(* X_INTERFACE_INFO = "digilentinc.com:interface:pmod:1.0 Pmod_out PIN1_O" *)
output wire Pmod_out_pin1_o;
(* X_INTERFACE_INFO = "digilentinc.com:interface:pmod:1.0 Pmod_out PIN1_T" *)
output wire Pmod_out_pin1_t;
(* X_INTERFACE_INFO = "digilentinc.com:interface:pmod:1.0 Pmod_out PIN2_I" *)
input wire Pmod_out_pin2_i;
(* X_INTERFACE_INFO = "digilentinc.com:interface:pmod:1.0 Pmod_out PIN2_O" *)
output wire Pmod_out_pin2_o;
(* X_INTERFACE_INFO = "digilentinc.com:interface:pmod:1.0 Pmod_out PIN2_T" *)
output wire Pmod_out_pin2_t;
(* X_INTERFACE_INFO = "digilentinc.com:interface:pmod:1.0 Pmod_out PIN3_I" *)
input wire Pmod_out_pin3_i;
(* X_INTERFACE_INFO = "digilentinc.com:interface:pmod:1.0 Pmod_out PIN3_O" *)
output wire Pmod_out_pin3_o;
(* X_INTERFACE_INFO = "digilentinc.com:interface:pmod:1.0 Pmod_out PIN3_T" *)
output wire Pmod_out_pin3_t;
(* X_INTERFACE_INFO = "digilentinc.com:interface:pmod:1.0 Pmod_out PIN4_I" *)
input wire Pmod_out_pin4_i;
(* X_INTERFACE_INFO = "digilentinc.com:interface:pmod:1.0 Pmod_out PIN4_O" *)
output wire Pmod_out_pin4_o;
(* X_INTERFACE_INFO = "digilentinc.com:interface:pmod:1.0 Pmod_out PIN4_T" *)
output wire Pmod_out_pin4_t;
(* X_INTERFACE_INFO = "digilentinc.com:interface:pmod:1.0 Pmod_out PIN7_I" *)
input wire Pmod_out_pin7_i;
(* X_INTERFACE_INFO = "digilentinc.com:interface:pmod:1.0 Pmod_out PIN7_O" *)
output wire Pmod_out_pin7_o;
(* X_INTERFACE_INFO = "digilentinc.com:interface:pmod:1.0 Pmod_out PIN7_T" *)
output wire Pmod_out_pin7_t;
(* X_INTERFACE_INFO = "digilentinc.com:interface:pmod:1.0 Pmod_out PIN8_I" *)
input wire Pmod_out_pin8_i;
(* X_INTERFACE_INFO = "digilentinc.com:interface:pmod:1.0 Pmod_out PIN8_O" *)
output wire Pmod_out_pin8_o;
(* X_INTERFACE_INFO = "digilentinc.com:interface:pmod:1.0 Pmod_out PIN8_T" *)
output wire Pmod_out_pin8_t;
(* X_INTERFACE_INFO = "digilentinc.com:interface:pmod:1.0 Pmod_out PIN9_I" *)
input wire Pmod_out_pin9_i;
(* X_INTERFACE_INFO = "digilentinc.com:interface:pmod:1.0 Pmod_out PIN9_O" *)
output wire Pmod_out_pin9_o;
(* X_INTERFACE_PARAMETER = "XIL_INTERFACENAME Pmod_out, BUSIF.BOARD_INTERFACE Custom, BOARD.ASSOCIATED_PARAM PMOD" *)
(* X_INTERFACE_INFO = "digilentinc.com:interface:pmod:1.0 Pmod_out PIN9_T" *)
output wire Pmod_out_pin9_t;
(* X_INTERFACE_PARAMETER = "XIL_INTERFACENAME INTR.SPI_INTERRUPT, SENSITIVITY EDGE_RISING, PortWidth 1, XIL_INTERFACENAME SPI_Interrupt, SENSITIVITY LEVEL_HIGH, PortWidth 1" *)
(* X_INTERFACE_INFO = "xilinx.com:signal:interrupt:1.0 INTR.SPI_INTERRUPT INTERRUPT, xilinx.com:signal:interrupt:1.0 SPI_Interrupt INTERRUPT" *)
output wire SPI_Interrupt;
(* X_INTERFACE_PARAMETER = "XIL_INTERFACENAME CLK.EXT_SPI_CLK, ASSOCIATED_BUSIF Pmod_out, FREQ_HZ 50000000, PHASE 0.0, CLK_DOMAIN /clk_wiz_1_clk_out1, INSERT_VIP 0" *)
(* X_INTERFACE_INFO = "xilinx.com:signal:clock:1.0 CLK.EXT_SPI_CLK CLK" *)
input wire ext_spi_clk;
(* X_INTERFACE_PARAMETER = "XIL_INTERFACENAME CLK.S_AXI_ACLK, ASSOCIATED_BUSIF AXI_LITE_SPI:AXI_LITE_GPIO, ASSOCIATED_RESET s_axi_aresetn, FREQ_HZ 100000000, PHASE 0.0, CLK_DOMAIN /clk_wiz_1_clk_out1, INSERT_VIP 0" *)
(* X_INTERFACE_INFO = "xilinx.com:signal:clock:1.0 CLK.S_AXI_ACLK CLK" *)
input wire s_axi_aclk;
(* X_INTERFACE_PARAMETER = "XIL_INTERFACENAME RST.S_AXI_ARESETN, POLARITY ACTIVE_LOW, INSERT_VIP 0" *)
(* X_INTERFACE_INFO = "xilinx.com:signal:reset:1.0 RST.S_AXI_ARESETN RST" *)
input wire s_axi_aresetn;

  PmodNAV inst (
    .AXI_LITE_GPIO_araddr(AXI_LITE_GPIO_araddr),
    .AXI_LITE_GPIO_arready(AXI_LITE_GPIO_arready),
    .AXI_LITE_GPIO_arvalid(AXI_LITE_GPIO_arvalid),
    .AXI_LITE_GPIO_awaddr(AXI_LITE_GPIO_awaddr),
    .AXI_LITE_GPIO_awready(AXI_LITE_GPIO_awready),
    .AXI_LITE_GPIO_awvalid(AXI_LITE_GPIO_awvalid),
    .AXI_LITE_GPIO_bready(AXI_LITE_GPIO_bready),
    .AXI_LITE_GPIO_bresp(AXI_LITE_GPIO_bresp),
    .AXI_LITE_GPIO_bvalid(AXI_LITE_GPIO_bvalid),
    .AXI_LITE_GPIO_rdata(AXI_LITE_GPIO_rdata),
    .AXI_LITE_GPIO_rready(AXI_LITE_GPIO_rready),
    .AXI_LITE_GPIO_rresp(AXI_LITE_GPIO_rresp),
    .AXI_LITE_GPIO_rvalid(AXI_LITE_GPIO_rvalid),
    .AXI_LITE_GPIO_wdata(AXI_LITE_GPIO_wdata),
    .AXI_LITE_GPIO_wready(AXI_LITE_GPIO_wready),
    .AXI_LITE_GPIO_wstrb(AXI_LITE_GPIO_wstrb),
    .AXI_LITE_GPIO_wvalid(AXI_LITE_GPIO_wvalid),
    .AXI_LITE_SPI_araddr(AXI_LITE_SPI_araddr),
    .AXI_LITE_SPI_arready(AXI_LITE_SPI_arready),
    .AXI_LITE_SPI_arvalid(AXI_LITE_SPI_arvalid),
    .AXI_LITE_SPI_awaddr(AXI_LITE_SPI_awaddr),
    .AXI_LITE_SPI_awready(AXI_LITE_SPI_awready),
    .AXI_LITE_SPI_awvalid(AXI_LITE_SPI_awvalid),
    .AXI_LITE_SPI_bready(AXI_LITE_SPI_bready),
    .AXI_LITE_SPI_bresp(AXI_LITE_SPI_bresp),
    .AXI_LITE_SPI_bvalid(AXI_LITE_SPI_bvalid),
    .AXI_LITE_SPI_rdata(AXI_LITE_SPI_rdata),
    .AXI_LITE_SPI_rready(AXI_LITE_SPI_rready),
    .AXI_LITE_SPI_rresp(AXI_LITE_SPI_rresp),
    .AXI_LITE_SPI_rvalid(AXI_LITE_SPI_rvalid),
    .AXI_LITE_SPI_wdata(AXI_LITE_SPI_wdata),
    .AXI_LITE_SPI_wready(AXI_LITE_SPI_wready),
    .AXI_LITE_SPI_wstrb(AXI_LITE_SPI_wstrb),
    .AXI_LITE_SPI_wvalid(AXI_LITE_SPI_wvalid),
    .GPIO_Interrupt(GPIO_Interrupt),
    .Pmod_out_pin10_i(Pmod_out_pin10_i),
    .Pmod_out_pin10_o(Pmod_out_pin10_o),
    .Pmod_out_pin10_t(Pmod_out_pin10_t),
    .Pmod_out_pin1_i(Pmod_out_pin1_i),
    .Pmod_out_pin1_o(Pmod_out_pin1_o),
    .Pmod_out_pin1_t(Pmod_out_pin1_t),
    .Pmod_out_pin2_i(Pmod_out_pin2_i),
    .Pmod_out_pin2_o(Pmod_out_pin2_o),
    .Pmod_out_pin2_t(Pmod_out_pin2_t),
    .Pmod_out_pin3_i(Pmod_out_pin3_i),
    .Pmod_out_pin3_o(Pmod_out_pin3_o),
    .Pmod_out_pin3_t(Pmod_out_pin3_t),
    .Pmod_out_pin4_i(Pmod_out_pin4_i),
    .Pmod_out_pin4_o(Pmod_out_pin4_o),
    .Pmod_out_pin4_t(Pmod_out_pin4_t),
    .Pmod_out_pin7_i(Pmod_out_pin7_i),
    .Pmod_out_pin7_o(Pmod_out_pin7_o),
    .Pmod_out_pin7_t(Pmod_out_pin7_t),
    .Pmod_out_pin8_i(Pmod_out_pin8_i),
    .Pmod_out_pin8_o(Pmod_out_pin8_o),
    .Pmod_out_pin8_t(Pmod_out_pin8_t),
    .Pmod_out_pin9_i(Pmod_out_pin9_i),
    .Pmod_out_pin9_o(Pmod_out_pin9_o),
    .Pmod_out_pin9_t(Pmod_out_pin9_t),
    .SPI_Interrupt(SPI_Interrupt),
    .ext_spi_clk(ext_spi_clk),
    .s_axi_aclk(s_axi_aclk),
    .s_axi_aresetn(s_axi_aresetn)
  );
endmodule
