NicholasTran/G8_SwishSwooshSwordSimulator/src/mid_demo/mid_demo.ip_user_files/bd/mid_project/ip/mid_project_auto_pc_0/mid_project_auto_pc_0_sim_netlist.v

// Copyright 1986-2018 Xilinx, Inc. All Rights Reserved.
// --------------------------------------------------------------------------------
// Tool Version: Vivado v.2018.3 (win64) Build 2405991 Thu Dec  6 23:38:27 MST 2018
// Date        : Sun Mar 12 06:34:21 2023
// Host        : TheDesktop running 64-bit major release  (build 9200)
// Command     : write_verilog -force -mode funcsim -rename_top mid_project_auto_pc_0 -prefix
//               mid_project_auto_pc_0_ mid_project_auto_pc_0_sim_netlist.v
// Design      : mid_project_auto_pc_0
// Purpose     : This verilog netlist is a functional simulation representation of the design and should not be modified
//               or synthesized. This netlist cannot be used for SDF annotated simulation.
// Device      : xc7a100tcsg324-1
// --------------------------------------------------------------------------------
`timescale 1 ps / 1 ps

(* C_AXI_ADDR_WIDTH = "32" *) (* C_AXI_ARUSER_WIDTH = "1" *) (* C_AXI_AWUSER_WIDTH = "1" *) 
(* C_AXI_BUSER_WIDTH = "1" *) (* C_AXI_DATA_WIDTH = "32" *) (* C_AXI_ID_WIDTH = "1" *) 
(* C_AXI_RUSER_WIDTH = "1" *) (* C_AXI_SUPPORTS_READ = "1" *) (* C_AXI_SUPPORTS_USER_SIGNALS = "0" *) 
(* C_AXI_SUPPORTS_WRITE = "1" *) (* C_AXI_WUSER_WIDTH = "1" *) (* C_FAMILY = "artix7" *) 
(* C_IGNORE_ID = "1" *) (* C_M_AXI_PROTOCOL = "2" *) (* C_S_AXI_PROTOCOL = "0" *) 
(* C_TRANSLATION_MODE = "2" *) (* DowngradeIPIdentifiedWarnings = "yes" *) (* P_AXI3 = "1" *) 
(* P_AXI4 = "0" *) (* P_AXILITE = "2" *) (* P_AXILITE_SIZE = "3'b010" *) 
(* P_CONVERSION = "2" *) (* P_DECERR = "2'b11" *) (* P_INCR = "2'b01" *) 
(* P_PROTECTION = "1" *) (* P_SLVERR = "2'b10" *) 
module mid_project_auto_pc_0_axi_protocol_converter_v2_1_18_axi_protocol_converter
   (aclk,
    aresetn,
    s_axi_awid,
    s_axi_awaddr,
    s_axi_awlen,
    s_axi_awsize,
    s_axi_awburst,
    s_axi_awlock,
    s_axi_awcache,
    s_axi_awprot,
    s_axi_awregion,
    s_axi_awqos,
    s_axi_awuser,
    s_axi_awvalid,
    s_axi_awready,
    s_axi_wid,
    s_axi_wdata,
    s_axi_wstrb,
    s_axi_wlast,
    s_axi_wuser,
    s_axi_wvalid,
    s_axi_wready,
    s_axi_bid,
    s_axi_bresp,
    s_axi_buser,
    s_axi_bvalid,
    s_axi_bready,
    s_axi_arid,
    s_axi_araddr,
    s_axi_arlen,
    s_axi_arsize,
    s_axi_arburst,
    s_axi_arlock,
    s_axi_arcache,
    s_axi_arprot,
    s_axi_arregion,
    s_axi_arqos,
    s_axi_aruser,
    s_axi_arvalid,
    s_axi_arready,
    s_axi_rid,
    s_axi_rdata,
    s_axi_rresp,
    s_axi_rlast,
    s_axi_ruser,
    s_axi_rvalid,
    s_axi_rready,
    m_axi_awid,
    m_axi_awaddr,
    m_axi_awlen,
    m_axi_awsize,
    m_axi_awburst,
    m_axi_awlock,
    m_axi_awcache,
    m_axi_awprot,
    m_axi_awregion,
    m_axi_awqos,
    m_axi_awuser,
    m_axi_awvalid,
    m_axi_awready,
    m_axi_wid,
    m_axi_wdata,
    m_axi_wstrb,
    m_axi_wlast,
    m_axi_wuser,
    m_axi_wvalid,
    m_axi_wready,
    m_axi_bid,
    m_axi_bresp,
    m_axi_buser,
    m_axi_bvalid,
    m_axi_bready,
    m_axi_arid,
    m_axi_araddr,
    m_axi_arlen,
    m_axi_arsize,
    m_axi_arburst,
    m_axi_arlock,
    m_axi_arcache,
    m_axi_arprot,
    m_axi_arregion,
    m_axi_arqos,
    m_axi_aruser,
    m_axi_arvalid,
    m_axi_arready,
    m_axi_rid,
    m_axi_rdata,
    m_axi_rresp,
    m_axi_rlast,
    m_axi_ruser,
    m_axi_rvalid,
    m_axi_rready);
  input aclk;
  input aresetn;
  input [0:0]s_axi_awid;
  input [31:0]s_axi_awaddr;
  input [7:0]s_axi_awlen;
  input [2:0]s_axi_awsize;
  input [1:0]s_axi_awburst;
  input [0:0]s_axi_awlock;
  input [3:0]s_axi_awcache;
  input [2:0]s_axi_awprot;
  input [3:0]s_axi_awregion;
  input [3:0]s_axi_awqos;
  input [0:0]s_axi_awuser;
  input s_axi_awvalid;
  output s_axi_awready;
  input [0:0]s_axi_wid;
  input [31:0]s_axi_wdata;
  input [3:0]s_axi_wstrb;
  input s_axi_wlast;
  input [0:0]s_axi_wuser;
  input s_axi_wvalid;
  output s_axi_wready;
  output [0:0]s_axi_bid;
  output [1:0]s_axi_bresp;
  output [0:0]s_axi_buser;
  output s_axi_bvalid;
  input s_axi_bready;
  input [0:0]s_axi_arid;
  input [31:0]s_axi_araddr;
  input [7:0]s_axi_arlen;
  input [2:0]s_axi_arsize;
  input [1:0]s_axi_arburst;
  input [0:0]s_axi_arlock;
  input [3:0]s_axi_arcache;
  input [2:0]s_axi_arprot;
  input [3:0]s_axi_arregion;
  input [3:0]s_axi_arqos;
  input [0:0]s_axi_aruser;
  input s_axi_arvalid;
  output s_axi_arready;
  output [0:0]s_axi_rid;
  output [31:0]s_axi_rdata;
  output [1:0]s_axi_rresp;
  output s_axi_rlast;
  output [0:0]s_axi_ruser;
  output s_axi_rvalid;
  input s_axi_rready;
  output [0:0]m_axi_awid;
  output [31:0]m_axi_awaddr;
  output [7:0]m_axi_awlen;
  output [2:0]m_axi_awsize;
  output [1:0]m_axi_awburst;
  output [0:0]m_axi_awlock;
  output [3:0]m_axi_awcache;
  output [2:0]m_axi_awprot;
  output [3:0]m_axi_awregion;
  output [3:0]m_axi_awqos;
  output [0:0]m_axi_awuser;
  output m_axi_awvalid;
  input m_axi_awready;
  output [0:0]m_axi_wid;
  output [31:0]m_axi_wdata;
  output [3:0]m_axi_wstrb;
  output m_axi_wlast;
  output [0:0]m_axi_wuser;
  output m_axi_wvalid;
  input m_axi_wready;
  input [0:0]m_axi_bid;
  input [1:0]m_axi_bresp;
  input [0:0]m_axi_buser;
  input m_axi_bvalid;
  output m_axi_bready;
  output [0:0]m_axi_arid;
  output [31:0]m_axi_araddr;
  output [7:0]m_axi_arlen;
  output [2:0]m_axi_arsize;
  output [1:0]m_axi_arburst;
  output [0:0]m_axi_arlock;
  output [3:0]m_axi_arcache;
  output [2:0]m_axi_arprot;
  output [3:0]m_axi_arregion;
  output [3:0]m_axi_arqos;
  output [0:0]m_axi_aruser;
  output m_axi_arvalid;
  input m_axi_arready;
  input [0:0]m_axi_rid;
  input [31:0]m_axi_rdata;
  input [1:0]m_axi_rresp;
  input m_axi_rlast;
  input [0:0]m_axi_ruser;
  input m_axi_rvalid;
  output m_axi_rready;

  wire \<const0> ;
  wire \<const1> ;
  wire aclk;
  wire aresetn;
  wire [31:0]m_axi_araddr;
  wire [2:0]m_axi_arprot;
  wire m_axi_arready;
  wire m_axi_arvalid;
  wire [31:0]m_axi_awaddr;
  wire [2:0]m_axi_awprot;
  wire m_axi_awready;
  wire m_axi_awvalid;
  wire m_axi_bready;
  wire [1:0]m_axi_bresp;
  wire m_axi_bvalid;
  wire [31:0]m_axi_rdata;
  wire m_axi_rready;
  wire [1:0]m_axi_rresp;
  wire m_axi_rvalid;
  wire m_axi_wready;
  wire [31:0]s_axi_araddr;
  wire [1:0]s_axi_arburst;
  wire [0:0]s_axi_arid;
  wire [7:0]s_axi_arlen;
  wire [2:0]s_axi_arprot;
  wire s_axi_arready;
  wire [2:0]s_axi_arsize;
  wire s_axi_arvalid;
  wire [31:0]s_axi_awaddr;
  wire [1:0]s_axi_awburst;
  wire [0:0]s_axi_awid;
  wire [7:0]s_axi_awlen;
  wire [2:0]s_axi_awprot;
  wire s_axi_awready;
  wire [2:0]s_axi_awsize;
  wire s_axi_awvalid;
  wire [0:0]s_axi_bid;
  wire s_axi_bready;
  wire [1:0]s_axi_bresp;
  wire s_axi_bvalid;
  wire [31:0]s_axi_rdata;
  wire [0:0]s_axi_rid;
  wire s_axi_rlast;
  wire s_axi_rready;
  wire [1:0]s_axi_rresp;
  wire s_axi_rvalid;
  wire [31:0]s_axi_wdata;
  wire [3:0]s_axi_wstrb;
  wire s_axi_wvalid;

  assign m_axi_arburst[1] = \<const0> ;
  assign m_axi_arburst[0] = \<const1> ;
  assign m_axi_arcache[3] = \<const0> ;
  assign m_axi_arcache[2] = \<const0> ;
  assign m_axi_arcache[1] = \<const0> ;
  assign m_axi_arcache[0] = \<const0> ;
  assign m_axi_arid[0] = \<const0> ;
  assign m_axi_arlen[7] = \<const0> ;
  assign m_axi_arlen[6] = \<const0> ;
  assign m_axi_arlen[5] = \<const0> ;
  assign m_axi_arlen[4] = \<const0> ;
  assign m_axi_arlen[3] = \<const0> ;
  assign m_axi_arlen[2] = \<const0> ;
  assign m_axi_arlen[1] = \<const0> ;
  assign m_axi_arlen[0] = \<const0> ;
  assign m_axi_arlock[0] = \<const0> ;
  assign m_axi_arqos[3] = \<const0> ;
  assign m_axi_arqos[2] = \<const0> ;
  assign m_axi_arqos[1] = \<const0> ;
  assign m_axi_arqos[0] = \<const0> ;
  assign m_axi_arregion[3] = \<const0> ;
  assign m_axi_arregion[2] = \<const0> ;
  assign m_axi_arregion[1] = \<const0> ;
  assign m_axi_arregion[0] = \<const0> ;
  assign m_axi_arsize[2] = \<const0> ;
  assign m_axi_arsize[1] = \<const1> ;
  assign m_axi_arsize[0] = \<const0> ;
  assign m_axi_aruser[0] = \<const0> ;
  assign m_axi_awburst[1] = \<const0> ;
  assign m_axi_awburst[0] = \<const1> ;
  assign m_axi_awcache[3] = \<const0> ;
  assign m_axi_awcache[2] = \<const0> ;
  assign m_axi_awcache[1] = \<const0> ;
  assign m_axi_awcache[0] = \<const0> ;
  assign m_axi_awid[0] = \<const0> ;
  assign m_axi_awlen[7] = \<const0> ;
  assign m_axi_awlen[6] = \<const0> ;
  assign m_axi_awlen[5] = \<const0> ;
  assign m_axi_awlen[4] = \<const0> ;
  assign m_axi_awlen[3] = \<const0> ;
  assign m_axi_awlen[2] = \<const0> ;
  assign m_axi_awlen[1] = \<const0> ;
  assign m_axi_awlen[0] = \<const0> ;
  assign m_axi_awlock[0] = \<const0> ;
  assign m_axi_awqos[3] = \<const0> ;
  assign m_axi_awqos[2] = \<const0> ;
  assign m_axi_awqos[1] = \<const0> ;
  assign m_axi_awqos[0] = \<const0> ;
  assign m_axi_awregion[3] = \<const0> ;
  assign m_axi_awregion[2] = \<const0> ;
  assign m_axi_awregion[1] = \<const0> ;
  assign m_axi_awregion[0] = \<const0> ;
  assign m_axi_awsize[2] = \<const0> ;
  assign m_axi_awsize[1] = \<const1> ;
  assign m_axi_awsize[0] = \<const0> ;
  assign m_axi_awuser[0] = \<const0> ;
  assign m_axi_wdata[31:0] = s_axi_wdata;
  assign m_axi_wid[0] = \<const0> ;
  assign m_axi_wlast = \<const1> ;
  assign m_axi_wstrb[3:0] = s_axi_wstrb;
  assign m_axi_wuser[0] = \<const0> ;
  assign m_axi_wvalid = s_axi_wvalid;
  assign s_axi_buser[0] = \<const0> ;
  assign s_axi_ruser[0] = \<const0> ;
  assign s_axi_wready = m_axi_wready;
  GND GND
       (.G(\<const0> ));
  VCC VCC
       (.P(\<const1> ));
  mid_project_auto_pc_0_axi_protocol_converter_v2_1_18_b2s \gen_axilite.gen_b2s_conv.axilite_b2s 
       (.Q({m_axi_awprot,m_axi_awaddr[31:12]}),
        .aclk(aclk),
        .aresetn(aresetn),
        .in({m_axi_rresp,m_axi_rdata}),
        .m_axi_araddr(m_axi_araddr[11:0]),
        .m_axi_arready(m_axi_arready),
        .m_axi_arvalid(m_axi_arvalid),
        .m_axi_awaddr(m_axi_awaddr[11:0]),
        .m_axi_awready(m_axi_awready),
        .m_axi_awvalid(m_axi_awvalid),
        .m_axi_bready(m_axi_bready),
        .m_axi_bresp(m_axi_bresp),
        .m_axi_bvalid(m_axi_bvalid),
        .m_axi_rready(m_axi_rready),
        .m_axi_rvalid(m_axi_rvalid),
        .\m_payload_i_reg[34] ({m_axi_arprot,m_axi_araddr[31:12]}),
        .\m_payload_i_reg[35] ({s_axi_rid,s_axi_rlast,s_axi_rresp,s_axi_rdata}),
        .s_axi_araddr(s_axi_araddr),
        .s_axi_arburst(s_axi_arburst),
        .s_axi_arid(s_axi_arid),
        .s_axi_arlen(s_axi_arlen),
        .s_axi_arprot(s_axi_arprot),
        .s_axi_arready(s_axi_arready),
        .s_axi_arsize(s_axi_arsize[1:0]),
        .s_axi_arvalid(s_axi_arvalid),
        .s_axi_awaddr(s_axi_awaddr),
        .s_axi_awburst(s_axi_awburst),
        .s_axi_awid(s_axi_awid),
        .s_axi_awlen(s_axi_awlen),
        .s_axi_awprot(s_axi_awprot),
        .s_axi_awready(s_axi_awready),
        .s_axi_awsize(s_axi_awsize[1:0]),
        .s_axi_awvalid(s_axi_awvalid),
        .s_axi_bid(s_axi_bid),
        .s_axi_bready(s_axi_bready),
        .s_axi_bresp(s_axi_bresp),
        .s_axi_bvalid(s_axi_bvalid),
        .s_axi_rready(s_axi_rready),
        .s_axi_rvalid(s_axi_rvalid));
endmodule

module mid_project_auto_pc_0_axi_protocol_converter_v2_1_18_b2s
   (s_axi_awready,
    s_axi_arready,
    Q,
    \m_payload_i_reg[34] ,
    s_axi_bvalid,
    s_axi_bid,
    s_axi_bresp,
    s_axi_rvalid,
    \m_payload_i_reg[35] ,
    m_axi_awvalid,
    m_axi_bready,
    m_axi_arvalid,
    m_axi_rready,
    m_axi_awaddr,
    m_axi_araddr,
    s_axi_awvalid,
    s_axi_arvalid,
    aclk,
    in,
    s_axi_awid,
    s_axi_awlen,
    s_axi_awburst,
    s_axi_awsize,
    s_axi_awprot,
    s_axi_awaddr,
    m_axi_bresp,
    s_axi_arid,
    s_axi_arlen,
    s_axi_arburst,
    s_axi_arsize,
    s_axi_arprot,
    s_axi_araddr,
    s_axi_bready,
    m_axi_arready,
    m_axi_awready,
    m_axi_bvalid,
    m_axi_rvalid,
    s_axi_rready,
    aresetn);
  output s_axi_awready;
  output s_axi_arready;
  output [22:0]Q;
  output [22:0]\m_payload_i_reg[34] ;
  output s_axi_bvalid;
  output [0:0]s_axi_bid;
  output [1:0]s_axi_bresp;
  output s_axi_rvalid;
  output [35:0]\m_payload_i_reg[35] ;
  output m_axi_awvalid;
  output m_axi_bready;
  output m_axi_arvalid;
  output m_axi_rready;
  output [11:0]m_axi_awaddr;
  output [11:0]m_axi_araddr;
  input s_axi_awvalid;
  input s_axi_arvalid;
  input aclk;
  input [33:0]in;
  input [0:0]s_axi_awid;
  input [7:0]s_axi_awlen;
  input [1:0]s_axi_awburst;
  input [1:0]s_axi_awsize;
  input [2:0]s_axi_awprot;
  input [31:0]s_axi_awaddr;
  input [1:0]m_axi_bresp;
  input [0:0]s_axi_arid;
  input [7:0]s_axi_arlen;
  input [1:0]s_axi_arburst;
  input [1:0]s_axi_arsize;
  input [2:0]s_axi_arprot;
  input [31:0]s_axi_araddr;
  input s_axi_bready;
  input m_axi_arready;
  input m_axi_awready;
  input m_axi_bvalid;
  input m_axi_rvalid;
  input s_axi_rready;
  input aresetn;

  wire [22:0]Q;
  wire \RD.ar_channel_0_n_2 ;
  wire \RD.ar_channel_0_n_24 ;
  wire \RD.ar_channel_0_n_34 ;
  wire \RD.ar_channel_0_n_35 ;
  wire \RD.ar_channel_0_n_36 ;
  wire \RD.ar_channel_0_n_37 ;
  wire \RD.ar_channel_0_n_7 ;
  wire \RD.ar_channel_0_n_8 ;
  wire \RD.ar_channel_0_n_9 ;
  wire SI_REG_n_100;
  wire SI_REG_n_101;
  wire SI_REG_n_102;
  wire SI_REG_n_117;
  wire SI_REG_n_118;
  wire SI_REG_n_119;
  wire SI_REG_n_155;
  wire SI_REG_n_156;
  wire SI_REG_n_157;
  wire SI_REG_n_158;
  wire SI_REG_n_159;
  wire SI_REG_n_16;
  wire SI_REG_n_160;
  wire SI_REG_n_161;
  wire SI_REG_n_162;
  wire SI_REG_n_163;
  wire SI_REG_n_164;
  wire SI_REG_n_165;
  wire SI_REG_n_166;
  wire SI_REG_n_167;
  wire SI_REG_n_168;
  wire SI_REG_n_169;
  wire SI_REG_n_17;
  wire SI_REG_n_170;
  wire SI_REG_n_171;
  wire SI_REG_n_173;
  wire SI_REG_n_174;
  wire SI_REG_n_176;
  wire SI_REG_n_177;
  wire SI_REG_n_18;
  wire SI_REG_n_19;
  wire SI_REG_n_36;
  wire SI_REG_n_37;
  wire SI_REG_n_38;
  wire SI_REG_n_39;
  wire SI_REG_n_40;
  wire SI_REG_n_41;
  wire SI_REG_n_42;
  wire SI_REG_n_43;
  wire SI_REG_n_44;
  wire SI_REG_n_45;
  wire SI_REG_n_46;
  wire SI_REG_n_47;
  wire SI_REG_n_62;
  wire \WR.aw_channel_0_n_12 ;
  wire \WR.aw_channel_0_n_13 ;
  wire \WR.aw_channel_0_n_30 ;
  wire \WR.aw_channel_0_n_39 ;
  wire \WR.aw_channel_0_n_40 ;
  wire \WR.aw_channel_0_n_41 ;
  wire \WR.aw_channel_0_n_42 ;
  wire aclk;
  wire \ar.ar_pipe/m_valid_i0 ;
  wire \ar.ar_pipe/p_1_in ;
  wire \ar.ar_pipe/s_ready_i0 ;
  wire [1:0]\ar_cmd_fsm_0/state ;
  wire areset_d1;
  wire areset_d1_i_1_n_0;
  wire aresetn;
  wire \aw.aw_pipe/p_1_in ;
  wire [1:0]\aw_cmd_fsm_0/state ;
  wire [11:0]axaddr_incr;
  wire [11:11]axaddr_wrap;
  wire [7:4]axlen;
  wire [1:0]axsize;
  wire b_awid;
  wire [7:0]b_awlen;
  wire b_full;
  wire b_push;
  wire [1:0]\bid_fifo_0/cnt_read ;
  wire \cmd_translator_0/incr_cmd_0/sel_first ;
  wire \cmd_translator_0/incr_cmd_0/sel_first_4 ;
  wire [3:0]\cmd_translator_0/wrap_cmd_0/axaddr_offset ;
  wire [3:0]\cmd_translator_0/wrap_cmd_0/axaddr_offset_1 ;
  wire [3:0]\cmd_translator_0/wrap_cmd_0/axaddr_offset_r ;
  wire [3:0]\cmd_translator_0/wrap_cmd_0/axaddr_offset_r_3 ;
  wire [3:0]\cmd_translator_0/wrap_cmd_0/wrap_second_len ;
  wire [3:0]\cmd_translator_0/wrap_cmd_0/wrap_second_len_0 ;
  wire [3:0]\cmd_translator_0/wrap_cmd_0/wrap_second_len_r ;
  wire [3:0]\cmd_translator_0/wrap_cmd_0/wrap_second_len_r_2 ;
  wire [33:0]in;
  wire [11:0]m_axi_araddr;
  wire m_axi_arready;
  wire m_axi_arvalid;
  wire [11:0]m_axi_awaddr;
  wire m_axi_awready;
  wire m_axi_awvalid;
  wire m_axi_bready;
  wire [1:0]m_axi_bresp;
  wire m_axi_bvalid;
  wire m_axi_rready;
  wire m_axi_rvalid;
  wire [22:0]\m_payload_i_reg[34] ;
  wire [35:0]\m_payload_i_reg[35] ;
  wire r_full;
  wire r_push;
  wire r_rlast;
  wire s_arid;
  wire s_arid_r;
  wire s_awid;
  wire [7:4]s_awlen;
  wire [31:0]s_axi_araddr;
  wire [1:0]s_axi_arburst;
  wire [0:0]s_axi_arid;
  wire [7:0]s_axi_arlen;
  wire [2:0]s_axi_arprot;
  wire s_axi_arready;
  wire [1:0]s_axi_arsize;
  wire s_axi_arvalid;
  wire [31:0]s_axi_awaddr;
  wire [1:0]s_axi_awburst;
  wire [0:0]s_axi_awid;
  wire [7:0]s_axi_awlen;
  wire [2:0]s_axi_awprot;
  wire s_axi_awready;
  wire [1:0]s_axi_awsize;
  wire s_axi_awvalid;
  wire [0:0]s_axi_bid;
  wire s_axi_bready;
  wire [1:0]s_axi_bresp;
  wire s_axi_bvalid;
  wire s_axi_rready;
  wire s_axi_rvalid;
  wire sel_first;
  wire [11:0]si_rs_araddr;
  wire [1:1]si_rs_arburst;
  wire [3:0]si_rs_arlen;
  wire si_rs_arvalid;
  wire [11:0]si_rs_awaddr;
  wire [1:1]si_rs_awburst;
  wire [3:0]si_rs_awlen;
  wire si_rs_awvalid;
  wire si_rs_bid;
  wire si_rs_bready;
  wire [1:0]si_rs_bresp;
  wire si_rs_bvalid;
  wire [31:0]si_rs_rdata;
  wire si_rs_rid;
  wire si_rs_rlast;
  wire si_rs_rready;
  wire [1:0]si_rs_rresp;
  wire si_rs_rvalid;
  wire [3:0]wrap_cnt;

  mid_project_auto_pc_0_axi_protocol_converter_v2_1_18_b2s_ar_channel \RD.ar_channel_0 
       (.D(\cmd_translator_0/wrap_cmd_0/wrap_second_len ),
        .E(\ar.ar_pipe/p_1_in ),
        .\FSM_sequential_state_reg[1] (\ar_cmd_fsm_0/state ),
        .\FSM_sequential_state_reg[1]_0 (\RD.ar_channel_0_n_9 ),
        .O({SI_REG_n_44,SI_REG_n_45,SI_REG_n_46,SI_REG_n_47}),
        .Q({s_arid,axlen,si_rs_arlen,si_rs_arburst,SI_REG_n_117,SI_REG_n_118,SI_REG_n_119,si_rs_araddr}),
        .S({\RD.ar_channel_0_n_34 ,\RD.ar_channel_0_n_35 ,\RD.ar_channel_0_n_36 ,\RD.ar_channel_0_n_37 }),
        .aclk(aclk),
        .areset_d1(areset_d1),
        .\axaddr_incr_reg[11] (\RD.ar_channel_0_n_8 ),
        .\axaddr_incr_reg[3] ({SI_REG_n_36,SI_REG_n_37,SI_REG_n_38,SI_REG_n_39}),
        .\axaddr_incr_reg[7] ({SI_REG_n_40,SI_REG_n_41,SI_REG_n_42,SI_REG_n_43}),
        .axaddr_offset(\cmd_translator_0/wrap_cmd_0/axaddr_offset ),
        .\axaddr_offset_r_reg[3] (\cmd_translator_0/wrap_cmd_0/axaddr_offset_r ),
        .\axaddr_wrap_reg[11] (\RD.ar_channel_0_n_7 ),
        .\axlen_cnt_reg[3] (SI_REG_n_155),
        .m_axi_araddr(m_axi_araddr[10:0]),
        .\m_axi_araddr[0]_0 (SI_REG_n_177),
        .m_axi_araddr_0_sp_1(SI_REG_n_176),
        .m_axi_arready(m_axi_arready),
        .m_axi_arvalid(m_axi_arvalid),
        .m_valid_i0(\ar.ar_pipe/m_valid_i0 ),
        .next_pending_r_reg(SI_REG_n_156),
        .next_pending_r_reg_0(SI_REG_n_157),
        .r_full(r_full),
        .r_push(r_push),
        .r_rlast(r_rlast),
        .s_arid_r(s_arid_r),
        .s_axi_arvalid(s_axi_arvalid),
        .s_ready_i0(\ar.ar_pipe/s_ready_i0 ),
        .s_ready_i_reg(s_axi_arready),
        .sel_first(\cmd_translator_0/incr_cmd_0/sel_first ),
        .sel_first_reg(\RD.ar_channel_0_n_2 ),
        .sel_first_reg_0(\RD.ar_channel_0_n_24 ),
        .si_rs_arvalid(si_rs_arvalid),
        .\wrap_boundary_axaddr_r_reg[6] ({SI_REG_n_165,SI_REG_n_166,SI_REG_n_167,SI_REG_n_168,SI_REG_n_169,SI_REG_n_170,SI_REG_n_171}),
        .\wrap_cnt_r_reg[3] ({SI_REG_n_16,SI_REG_n_17,SI_REG_n_18,SI_REG_n_19}),
        .\wrap_second_len_r_reg[3] (\cmd_translator_0/wrap_cmd_0/wrap_second_len_r ));
  mid_project_auto_pc_0_axi_protocol_converter_v2_1_18_b2s_r_channel \RD.r_channel_0 
       (.aclk(aclk),
        .areset_d1(areset_d1),
        .in(in),
        .m_axi_rready(m_axi_rready),
        .m_axi_rvalid(m_axi_rvalid),
        .out({si_rs_rresp,si_rs_rdata}),
        .r_full(r_full),
        .r_push(r_push),
        .r_push_r_reg_0({si_rs_rid,si_rs_rlast}),
        .r_rlast(r_rlast),
        .s_arid_r(s_arid_r),
        .si_rs_rready(si_rs_rready),
        .si_rs_rvalid(si_rs_rvalid));
  mid_project_auto_pc_0_axi_register_slice_v2_1_18_axi_register_slice SI_REG
       (.D(wrap_cnt),
        .E(\aw.aw_pipe/p_1_in ),
        .O({SI_REG_n_44,SI_REG_n_45,SI_REG_n_46,SI_REG_n_47}),
        .Q(\cmd_translator_0/wrap_cmd_0/wrap_second_len_r_2 ),
        .S({\WR.aw_channel_0_n_39 ,\WR.aw_channel_0_n_40 ,\WR.aw_channel_0_n_41 ,\WR.aw_channel_0_n_42 }),
        .aclk(aclk),
        .aresetn(aresetn),
        .axaddr_incr(axaddr_incr),
        .\axaddr_incr_reg[3] ({\RD.ar_channel_0_n_34 ,\RD.ar_channel_0_n_35 ,\RD.ar_channel_0_n_36 ,\RD.ar_channel_0_n_37 }),
        .axaddr_offset(\cmd_translator_0/wrap_cmd_0/axaddr_offset_1 ),
        .axaddr_offset_0(\cmd_translator_0/wrap_cmd_0/axaddr_offset ),
        .\axaddr_offset_r_reg[0] (\aw_cmd_fsm_0/state ),
        .\axaddr_offset_r_reg[0]_0 (\ar_cmd_fsm_0/state ),
        .\axaddr_offset_r_reg[3] (\cmd_translator_0/wrap_cmd_0/axaddr_offset_r_3 ),
        .\axaddr_offset_r_reg[3]_0 (\cmd_translator_0/wrap_cmd_0/axaddr_offset_r ),
        .b_push(b_push),
        .m_axi_araddr(m_axi_araddr[11]),
        .\m_axi_araddr[11] (\RD.ar_channel_0_n_7 ),
        .\m_axi_araddr[11]_0 (\RD.ar_channel_0_n_8 ),
        .\m_axi_araddr[11]_1 (\RD.ar_channel_0_n_24 ),
        .\m_axi_araddr[11]_2 (\RD.ar_channel_0_n_2 ),
        .m_axi_awaddr(m_axi_awaddr[11]),
        .\m_axi_awaddr[11] (axaddr_wrap),
        .\m_axi_awaddr[11]_0 (\WR.aw_channel_0_n_12 ),
        .\m_axi_awaddr[11]_1 (\WR.aw_channel_0_n_30 ),
        .\m_payload_i_reg[0] (\ar.ar_pipe/p_1_in ),
        .\m_payload_i_reg[35] ({SI_REG_n_158,SI_REG_n_159,SI_REG_n_160,SI_REG_n_161,SI_REG_n_162,SI_REG_n_163,SI_REG_n_164}),
        .\m_payload_i_reg[35]_0 ({SI_REG_n_165,SI_REG_n_166,SI_REG_n_167,SI_REG_n_168,SI_REG_n_169,SI_REG_n_170,SI_REG_n_171}),
        .\m_payload_i_reg[35]_1 (\m_payload_i_reg[35] ),
        .\m_payload_i_reg[38] (SI_REG_n_174),
        .\m_payload_i_reg[38]_0 (SI_REG_n_177),
        .\m_payload_i_reg[39] (SI_REG_n_173),
        .\m_payload_i_reg[39]_0 (SI_REG_n_176),
        .\m_payload_i_reg[3] ({SI_REG_n_36,SI_REG_n_37,SI_REG_n_38,SI_REG_n_39}),
        .\m_payload_i_reg[46] (SI_REG_n_101),
        .\m_payload_i_reg[46]_0 (SI_REG_n_156),
        .\m_payload_i_reg[47] (SI_REG_n_100),
        .\m_payload_i_reg[47]_0 (SI_REG_n_102),
        .\m_payload_i_reg[47]_1 (SI_REG_n_155),
        .\m_payload_i_reg[47]_2 (SI_REG_n_157),
        .\m_payload_i_reg[53] ({s_awid,s_awlen,si_rs_awlen,si_rs_awburst,SI_REG_n_62,axsize,Q,si_rs_awaddr}),
        .\m_payload_i_reg[53]_0 ({s_arid,axlen,si_rs_arlen,si_rs_arburst,SI_REG_n_117,SI_REG_n_118,SI_REG_n_119,\m_payload_i_reg[34] ,si_rs_araddr}),
        .\m_payload_i_reg[7] ({SI_REG_n_40,SI_REG_n_41,SI_REG_n_42,SI_REG_n_43}),
        .m_valid_i0(\ar.ar_pipe/m_valid_i0 ),
        .m_valid_i_reg(s_axi_bvalid),
        .m_valid_i_reg_0(s_axi_rvalid),
        .out(si_rs_bid),
        .s_axi_araddr(s_axi_araddr),
        .s_axi_arburst(s_axi_arburst),
        .s_axi_arid(s_axi_arid),
        .s_axi_arlen(s_axi_arlen),
        .s_axi_arprot(s_axi_arprot),
        .s_axi_arsize(s_axi_arsize),
        .s_axi_awaddr(s_axi_awaddr),
        .s_axi_awburst(s_axi_awburst),
        .s_axi_awid(s_axi_awid),
        .s_axi_awlen(s_axi_awlen),
        .s_axi_awprot(s_axi_awprot),
        .s_axi_awsize(s_axi_awsize),
        .s_axi_awvalid(s_axi_awvalid),
        .s_axi_bid(s_axi_bid),
        .s_axi_bready(s_axi_bready),
        .s_axi_bresp(s_axi_bresp),
        .s_axi_rready(s_axi_rready),
        .s_ready_i0(\ar.ar_pipe/s_ready_i0 ),
        .s_ready_i_reg(s_axi_awready),
        .s_ready_i_reg_0(s_axi_arready),
        .sel_first(sel_first),
        .sel_first_1(\cmd_translator_0/incr_cmd_0/sel_first_4 ),
        .sel_first_2(\cmd_translator_0/incr_cmd_0/sel_first ),
        .si_rs_arvalid(si_rs_arvalid),
        .si_rs_awvalid(si_rs_awvalid),
        .si_rs_bready(si_rs_bready),
        .si_rs_bvalid(si_rs_bvalid),
        .si_rs_rready(si_rs_rready),
        .si_rs_rvalid(si_rs_rvalid),
        .\skid_buffer_reg[1] (si_rs_bresp),
        .\skid_buffer_reg[33] ({si_rs_rresp,si_rs_rdata}),
        .\skid_buffer_reg[35] ({si_rs_rid,si_rs_rlast}),
        .\wrap_cnt_r_reg[0] (\WR.aw_channel_0_n_13 ),
        .\wrap_cnt_r_reg[0]_0 (\RD.ar_channel_0_n_9 ),
        .wrap_second_len(\cmd_translator_0/wrap_cmd_0/wrap_second_len_0 ),
        .\wrap_second_len_r_reg[1] ({SI_REG_n_16,SI_REG_n_17,SI_REG_n_18,SI_REG_n_19}),
        .\wrap_second_len_r_reg[3] (\cmd_translator_0/wrap_cmd_0/wrap_second_len ),
        .\wrap_second_len_r_reg[3]_0 (\cmd_translator_0/wrap_cmd_0/wrap_second_len_r ));
  mid_project_auto_pc_0_axi_protocol_converter_v2_1_18_b2s_aw_channel \WR.aw_channel_0 
       (.D(\cmd_translator_0/wrap_cmd_0/axaddr_offset_1 ),
        .E(\aw.aw_pipe/p_1_in ),
        .Q(axaddr_wrap),
        .S({\WR.aw_channel_0_n_39 ,\WR.aw_channel_0_n_40 ,\WR.aw_channel_0_n_41 ,\WR.aw_channel_0_n_42 }),
        .aclk(aclk),
        .areset_d1(areset_d1),
        .axaddr_incr(axaddr_incr),
        .\axaddr_incr_reg[11] (\WR.aw_channel_0_n_12 ),
        .\axaddr_offset_r_reg[3] (\cmd_translator_0/wrap_cmd_0/axaddr_offset_r_3 ),
        .\axlen_cnt_reg[3] (SI_REG_n_100),
        .b_full(b_full),
        .b_push(b_push),
        .cnt_read(\bid_fifo_0/cnt_read ),
        .in({b_awid,b_awlen}),
        .m_axi_awaddr(m_axi_awaddr[10:0]),
        .\m_axi_awaddr[0]_0 (SI_REG_n_174),
        .m_axi_awaddr_0_sp_1(SI_REG_n_173),
        .m_axi_awready(m_axi_awready),
        .m_axi_awvalid(m_axi_awvalid),
        .next_pending_r_reg(SI_REG_n_101),
        .next_pending_r_reg_0(SI_REG_n_102),
        .\s_awid_r_reg[0]_0 ({s_awid,s_awlen,si_rs_awlen,si_rs_awburst,SI_REG_n_62,axsize,si_rs_awaddr}),
        .sel_first(sel_first),
        .sel_first_0(\cmd_translator_0/incr_cmd_0/sel_first_4 ),
        .sel_first_reg(\WR.aw_channel_0_n_30 ),
        .si_rs_awvalid(si_rs_awvalid),
        .\state_reg[1] (\WR.aw_channel_0_n_13 ),
        .\state_reg[1]_0 (\aw_cmd_fsm_0/state ),
        .\wrap_boundary_axaddr_r_reg[6] ({SI_REG_n_158,SI_REG_n_159,SI_REG_n_160,SI_REG_n_161,SI_REG_n_162,SI_REG_n_163,SI_REG_n_164}),
        .\wrap_cnt_r_reg[3] (wrap_cnt),
        .\wrap_second_len_r_reg[3] (\cmd_translator_0/wrap_cmd_0/wrap_second_len_r_2 ),
        .\wrap_second_len_r_reg[3]_0 (\cmd_translator_0/wrap_cmd_0/wrap_second_len_0 ));
  mid_project_auto_pc_0_axi_protocol_converter_v2_1_18_b2s_b_channel \WR.b_channel_0 
       (.aclk(aclk),
        .areset_d1(areset_d1),
        .b_full(b_full),
        .b_push(b_push),
        .cnt_read(\bid_fifo_0/cnt_read ),
        .in({b_awid,b_awlen}),
        .m_axi_bready(m_axi_bready),
        .m_axi_bresp(m_axi_bresp),
        .m_axi_bvalid(m_axi_bvalid),
        .out(si_rs_bid),
        .\s_bresp_acc_reg[1]_0 (si_rs_bresp),
        .si_rs_bready(si_rs_bready),
        .si_rs_bvalid(si_rs_bvalid));
  LUT1 #(
    .INIT(2'h1)) 
    areset_d1_i_1
       (.I0(aresetn),
        .O(areset_d1_i_1_n_0));
  FDRE #(
    .INIT(1'b0)) 
    areset_d1_reg
       (.C(aclk),
        .CE(1'b1),
        .D(areset_d1_i_1_n_0),
        .Q(areset_d1),
        .R(1'b0));
endmodule

module mid_project_auto_pc_0_axi_protocol_converter_v2_1_18_b2s_ar_channel
   (s_arid_r,
    sel_first,
    sel_first_reg,
    s_ready_i0,
    \FSM_sequential_state_reg[1] ,
    m_valid_i0,
    \axaddr_wrap_reg[11] ,
    \axaddr_incr_reg[11] ,
    \FSM_sequential_state_reg[1]_0 ,
    r_push,
    m_axi_arvalid,
    r_rlast,
    m_axi_araddr,
    sel_first_reg_0,
    E,
    \axaddr_offset_r_reg[3] ,
    \wrap_second_len_r_reg[3] ,
    S,
    aclk,
    Q,
    si_rs_arvalid,
    s_axi_arvalid,
    s_ready_i_reg,
    next_pending_r_reg,
    next_pending_r_reg_0,
    m_axi_arready,
    areset_d1,
    \axlen_cnt_reg[3] ,
    r_full,
    O,
    \axaddr_incr_reg[7] ,
    \axaddr_incr_reg[3] ,
    m_axi_araddr_0_sp_1,
    \m_axi_araddr[0]_0 ,
    axaddr_offset,
    D,
    \wrap_cnt_r_reg[3] ,
    \wrap_boundary_axaddr_r_reg[6] );
  output s_arid_r;
  output sel_first;
  output sel_first_reg;
  output s_ready_i0;
  output [1:0]\FSM_sequential_state_reg[1] ;
  output m_valid_i0;
  output [0:0]\axaddr_wrap_reg[11] ;
  output [0:0]\axaddr_incr_reg[11] ;
  output \FSM_sequential_state_reg[1]_0 ;
  output r_push;
  output m_axi_arvalid;
  output r_rlast;
  output [10:0]m_axi_araddr;
  output sel_first_reg_0;
  output [0:0]E;
  output [3:0]\axaddr_offset_r_reg[3] ;
  output [3:0]\wrap_second_len_r_reg[3] ;
  output [3:0]S;
  input aclk;
  input [24:0]Q;
  input si_rs_arvalid;
  input s_axi_arvalid;
  input s_ready_i_reg;
  input next_pending_r_reg;
  input next_pending_r_reg_0;
  input m_axi_arready;
  input areset_d1;
  input \axlen_cnt_reg[3] ;
  input r_full;
  input [3:0]O;
  input [3:0]\axaddr_incr_reg[7] ;
  input [3:0]\axaddr_incr_reg[3] ;
  input m_axi_araddr_0_sp_1;
  input \m_axi_araddr[0]_0 ;
  input [3:0]axaddr_offset;
  input [3:0]D;
  input [3:0]\wrap_cnt_r_reg[3] ;
  input [6:0]\wrap_boundary_axaddr_r_reg[6] ;

  wire [3:0]D;
  wire [0:0]E;
  wire [1:0]\FSM_sequential_state_reg[1] ;
  wire \FSM_sequential_state_reg[1]_0 ;
  wire [3:0]O;
  wire [24:0]Q;
  wire [3:0]S;
  wire aclk;
  wire ar_cmd_fsm_0_n_10;
  wire ar_cmd_fsm_0_n_11;
  wire ar_cmd_fsm_0_n_12;
  wire ar_cmd_fsm_0_n_13;
  wire ar_cmd_fsm_0_n_14;
  wire ar_cmd_fsm_0_n_15;
  wire ar_cmd_fsm_0_n_16;
  wire ar_cmd_fsm_0_n_17;
  wire ar_cmd_fsm_0_n_18;
  wire ar_cmd_fsm_0_n_19;
  wire ar_cmd_fsm_0_n_20;
  wire ar_cmd_fsm_0_n_21;
  wire ar_cmd_fsm_0_n_4;
  wire ar_cmd_fsm_0_n_5;
  wire ar_cmd_fsm_0_n_6;
  wire ar_cmd_fsm_0_n_9;
  wire areset_d1;
  wire [0:0]\axaddr_incr_reg[11] ;
  wire [3:0]\axaddr_incr_reg[3] ;
  wire [3:0]\axaddr_incr_reg[7] ;
  wire [3:0]axaddr_offset;
  wire [3:0]\axaddr_offset_r_reg[3] ;
  wire [0:0]\axaddr_wrap_reg[11] ;
  wire \axlen_cnt_reg[3] ;
  wire cmd_translator_0_n_0;
  wire cmd_translator_0_n_10;
  wire cmd_translator_0_n_11;
  wire cmd_translator_0_n_12;
  wire cmd_translator_0_n_13;
  wire cmd_translator_0_n_14;
  wire cmd_translator_0_n_19;
  wire cmd_translator_0_n_3;
  wire cmd_translator_0_n_4;
  wire cmd_translator_0_n_40;
  wire cmd_translator_0_n_41;
  wire cmd_translator_0_n_42;
  wire cmd_translator_0_n_43;
  wire cmd_translator_0_n_44;
  wire cmd_translator_0_n_45;
  wire cmd_translator_0_n_46;
  wire cmd_translator_0_n_47;
  wire cmd_translator_0_n_48;
  wire cmd_translator_0_n_49;
  wire cmd_translator_0_n_5;
  wire cmd_translator_0_n_50;
  wire cmd_translator_0_n_51;
  wire cmd_translator_0_n_6;
  wire cmd_translator_0_n_7;
  wire cmd_translator_0_n_8;
  wire cmd_translator_0_n_9;
  wire [10:0]m_axi_araddr;
  wire \m_axi_araddr[0]_0 ;
  wire m_axi_araddr_0_sn_1;
  wire m_axi_arready;
  wire m_axi_arvalid;
  wire m_valid_i0;
  wire next_pending;
  wire next_pending_r_reg;
  wire next_pending_r_reg_0;
  wire r_full;
  wire r_push;
  wire r_rlast;
  wire s_arid_r;
  wire s_axi_arvalid;
  wire s_ready_i0;
  wire s_ready_i_reg;
  wire sel_first;
  wire sel_first_i;
  wire sel_first_reg;
  wire sel_first_reg_0;
  wire si_rs_arvalid;
  wire [6:0]\wrap_boundary_axaddr_r_reg[6] ;
  wire [3:0]\wrap_cnt_r_reg[3] ;
  wire [3:0]\wrap_second_len_r_reg[3] ;

  assign m_axi_araddr_0_sn_1 = m_axi_araddr_0_sp_1;
  mid_project_auto_pc_0_axi_protocol_converter_v2_1_18_b2s_rd_cmd_fsm ar_cmd_fsm_0
       (.D({ar_cmd_fsm_0_n_10,ar_cmd_fsm_0_n_11,ar_cmd_fsm_0_n_12,ar_cmd_fsm_0_n_13,ar_cmd_fsm_0_n_14,ar_cmd_fsm_0_n_15,ar_cmd_fsm_0_n_16,ar_cmd_fsm_0_n_17,ar_cmd_fsm_0_n_18,ar_cmd_fsm_0_n_19,ar_cmd_fsm_0_n_20,ar_cmd_fsm_0_n_21}),
        .E(ar_cmd_fsm_0_n_4),
        .\FSM_sequential_state_reg[1]_0 (\FSM_sequential_state_reg[1]_0 ),
        .\FSM_sequential_state_reg[1]_1 (E),
        .O({cmd_translator_0_n_3,cmd_translator_0_n_4,cmd_translator_0_n_5,cmd_translator_0_n_6}),
        .Q(\FSM_sequential_state_reg[1] ),
        .aclk(aclk),
        .areset_d1(areset_d1),
        .\axaddr_incr_reg[0] (sel_first),
        .\axaddr_wrap_reg[11] (Q[11:0]),
        .\axaddr_wrap_reg[11]_0 ({cmd_translator_0_n_40,cmd_translator_0_n_41,cmd_translator_0_n_42,cmd_translator_0_n_43,cmd_translator_0_n_44,cmd_translator_0_n_45,cmd_translator_0_n_46,cmd_translator_0_n_47,cmd_translator_0_n_48,cmd_translator_0_n_49,cmd_translator_0_n_50,cmd_translator_0_n_51}),
        .\axaddr_wrap_reg[11]_1 ({cmd_translator_0_n_11,cmd_translator_0_n_12,cmd_translator_0_n_13,cmd_translator_0_n_14}),
        .\axaddr_wrap_reg[11]_2 (cmd_translator_0_n_19),
        .\axaddr_wrap_reg[7] ({cmd_translator_0_n_7,cmd_translator_0_n_8,cmd_translator_0_n_9,cmd_translator_0_n_10}),
        .m_axi_arready(m_axi_arready),
        .m_axi_arready_0(ar_cmd_fsm_0_n_5),
        .m_axi_arready_1(ar_cmd_fsm_0_n_6),
        .m_axi_arready_2(r_push),
        .m_axi_arvalid(m_axi_arvalid),
        .m_valid_i0(m_valid_i0),
        .next_pending(next_pending),
        .r_full(r_full),
        .s_axi_arvalid(s_axi_arvalid),
        .s_ready_i0(s_ready_i0),
        .s_ready_i_reg(s_ready_i_reg),
        .sel_first_i(sel_first_i),
        .sel_first_reg(ar_cmd_fsm_0_n_9),
        .sel_first_reg_0(sel_first_reg),
        .sel_first_reg_1(cmd_translator_0_n_0),
        .si_rs_arvalid(si_rs_arvalid));
  mid_project_auto_pc_0_axi_protocol_converter_v2_1_18_b2s_cmd_translator_1 cmd_translator_0
       (.D(D),
        .E(\FSM_sequential_state_reg[1]_0 ),
        .O({cmd_translator_0_n_3,cmd_translator_0_n_4,cmd_translator_0_n_5,cmd_translator_0_n_6}),
        .Q(Q[23:0]),
        .S(S),
        .aclk(aclk),
        .\axaddr_incr_reg[0] (ar_cmd_fsm_0_n_9),
        .\axaddr_incr_reg[11] (\axaddr_incr_reg[11] ),
        .\axaddr_incr_reg[11]_0 (O),
        .\axaddr_incr_reg[3] (\axaddr_incr_reg[3] ),
        .\axaddr_incr_reg[7] (\axaddr_incr_reg[7] ),
        .axaddr_offset(axaddr_offset),
        .\axaddr_offset_r_reg[3] (\axaddr_offset_r_reg[3] ),
        .\axaddr_wrap_reg[0] (ar_cmd_fsm_0_n_4),
        .\axaddr_wrap_reg[11] ({cmd_translator_0_n_11,cmd_translator_0_n_12,cmd_translator_0_n_13,cmd_translator_0_n_14}),
        .\axaddr_wrap_reg[11]_0 (\axaddr_wrap_reg[11] ),
        .\axaddr_wrap_reg[11]_1 ({ar_cmd_fsm_0_n_10,ar_cmd_fsm_0_n_11,ar_cmd_fsm_0_n_12,ar_cmd_fsm_0_n_13,ar_cmd_fsm_0_n_14,ar_cmd_fsm_0_n_15,ar_cmd_fsm_0_n_16,ar_cmd_fsm_0_n_17,ar_cmd_fsm_0_n_18,ar_cmd_fsm_0_n_19,ar_cmd_fsm_0_n_20,ar_cmd_fsm_0_n_21}),
        .\axaddr_wrap_reg[7] ({cmd_translator_0_n_7,cmd_translator_0_n_8,cmd_translator_0_n_9,cmd_translator_0_n_10}),
        .\axlen_cnt_reg[3] (\axlen_cnt_reg[3] ),
        .\axlen_cnt_reg[3]_0 (\FSM_sequential_state_reg[1] ),
        .\axlen_cnt_reg[4] (cmd_translator_0_n_19),
        .m_axi_araddr(m_axi_araddr),
        .\m_axi_araddr[0]_0 (\m_axi_araddr[0]_0 ),
        .m_axi_araddr_0_sp_1(m_axi_araddr_0_sn_1),
        .m_axi_arready(m_axi_arready),
        .next_pending(next_pending),
        .next_pending_r_reg(next_pending_r_reg),
        .next_pending_r_reg_0(next_pending_r_reg_0),
        .r_push(r_push),
        .r_rlast(r_rlast),
        .sel_first_i(sel_first_i),
        .sel_first_reg_0(cmd_translator_0_n_0),
        .sel_first_reg_1(sel_first),
        .sel_first_reg_2(sel_first_reg),
        .sel_first_reg_3(sel_first_reg_0),
        .sel_first_reg_4(ar_cmd_fsm_0_n_6),
        .sel_first_reg_5(ar_cmd_fsm_0_n_5),
        .si_rs_arvalid(si_rs_arvalid),
        .\wrap_boundary_axaddr_r_reg[11] ({cmd_translator_0_n_40,cmd_translator_0_n_41,cmd_translator_0_n_42,cmd_translator_0_n_43,cmd_translator_0_n_44,cmd_translator_0_n_45,cmd_translator_0_n_46,cmd_translator_0_n_47,cmd_translator_0_n_48,cmd_translator_0_n_49,cmd_translator_0_n_50,cmd_translator_0_n_51}),
        .\wrap_boundary_axaddr_r_reg[6] (\wrap_boundary_axaddr_r_reg[6] ),
        .\wrap_cnt_r_reg[3] (\wrap_cnt_r_reg[3] ),
        .\wrap_second_len_r_reg[3] (\wrap_second_len_r_reg[3] ));
  FDRE \s_arid_r_reg[0] 
       (.C(aclk),
        .CE(1'b1),
        .D(Q[24]),
        .Q(s_arid_r),
        .R(1'b0));
endmodule

module mid_project_auto_pc_0_axi_protocol_converter_v2_1_18_b2s_aw_channel
   (in,
    sel_first_0,
    sel_first,
    Q,
    \axaddr_incr_reg[11] ,
    \state_reg[1] ,
    \state_reg[1]_0 ,
    E,
    b_push,
    m_axi_awvalid,
    m_axi_awaddr,
    sel_first_reg,
    \axaddr_offset_r_reg[3] ,
    \wrap_second_len_r_reg[3] ,
    S,
    aclk,
    \s_awid_r_reg[0]_0 ,
    next_pending_r_reg,
    next_pending_r_reg_0,
    si_rs_awvalid,
    areset_d1,
    \axlen_cnt_reg[3] ,
    m_axi_awready,
    b_full,
    cnt_read,
    axaddr_incr,
    m_axi_awaddr_0_sp_1,
    \m_axi_awaddr[0]_0 ,
    D,
    \wrap_second_len_r_reg[3]_0 ,
    \wrap_cnt_r_reg[3] ,
    \wrap_boundary_axaddr_r_reg[6] );
  output [8:0]in;
  output sel_first_0;
  output sel_first;
  output [0:0]Q;
  output [0:0]\axaddr_incr_reg[11] ;
  output \state_reg[1] ;
  output [1:0]\state_reg[1]_0 ;
  output [0:0]E;
  output b_push;
  output m_axi_awvalid;
  output [10:0]m_axi_awaddr;
  output sel_first_reg;
  output [3:0]\axaddr_offset_r_reg[3] ;
  output [3:0]\wrap_second_len_r_reg[3] ;
  output [3:0]S;
  input aclk;
  input [24:0]\s_awid_r_reg[0]_0 ;
  input next_pending_r_reg;
  input next_pending_r_reg_0;
  input si_rs_awvalid;
  input areset_d1;
  input \axlen_cnt_reg[3] ;
  input m_axi_awready;
  input b_full;
  input [1:0]cnt_read;
  input [11:0]axaddr_incr;
  input m_axi_awaddr_0_sp_1;
  input \m_axi_awaddr[0]_0 ;
  input [3:0]D;
  input [3:0]\wrap_second_len_r_reg[3]_0 ;
  input [3:0]\wrap_cnt_r_reg[3] ;
  input [6:0]\wrap_boundary_axaddr_r_reg[6] ;

  wire [3:0]D;
  wire [0:0]E;
  wire [0:0]Q;
  wire [3:0]S;
  wire aclk;
  wire areset_d1;
  wire aw_cmd_fsm_0_n_0;
  wire aw_cmd_fsm_0_n_10;
  wire aw_cmd_fsm_0_n_11;
  wire aw_cmd_fsm_0_n_12;
  wire aw_cmd_fsm_0_n_3;
  wire aw_cmd_fsm_0_n_6;
  wire aw_cmd_fsm_0_n_9;
  wire [11:0]axaddr_incr;
  wire [0:0]\axaddr_incr_reg[11] ;
  wire [3:0]\axaddr_offset_r_reg[3] ;
  wire \axlen_cnt_reg[3] ;
  wire b_full;
  wire b_push;
  wire cmd_translator_0_n_1;
  wire cmd_translator_0_n_10;
  wire cmd_translator_0_n_2;
  wire cmd_translator_0_n_23;
  wire cmd_translator_0_n_7;
  wire cmd_translator_0_n_8;
  wire [1:0]cnt_read;
  wire [8:0]in;
  wire incr_next_pending;
  wire [10:0]m_axi_awaddr;
  wire \m_axi_awaddr[0]_0 ;
  wire m_axi_awaddr_0_sn_1;
  wire m_axi_awready;
  wire m_axi_awvalid;
  wire next;
  wire next_pending;
  wire next_pending_r_reg;
  wire next_pending_r_reg_0;
  wire [24:0]\s_awid_r_reg[0]_0 ;
  wire sel_first;
  wire sel_first_0;
  wire sel_first_i;
  wire sel_first_reg;
  wire si_rs_awvalid;
  wire \state_reg[1] ;
  wire [1:0]\state_reg[1]_0 ;
  wire [6:0]\wrap_boundary_axaddr_r_reg[6] ;
  wire [3:0]\wrap_cnt_r_reg[3] ;
  wire wrap_next_pending;
  wire [3:0]\wrap_second_len_r_reg[3] ;
  wire [3:0]\wrap_second_len_r_reg[3]_0 ;

  assign m_axi_awaddr_0_sn_1 = m_axi_awaddr_0_sp_1;
  mid_project_auto_pc_0_axi_protocol_converter_v2_1_18_b2s_wr_cmd_fsm aw_cmd_fsm_0
       (.D({aw_cmd_fsm_0_n_11,aw_cmd_fsm_0_n_12}),
        .E(\state_reg[1] ),
        .Q(\state_reg[1]_0 ),
        .aclk(aclk),
        .areset_d1(areset_d1),
        .\axlen_cnt_reg[0] (cmd_translator_0_n_7),
        .\axlen_cnt_reg[0]_0 (cmd_translator_0_n_8),
        .\axlen_cnt_reg[3] ({\s_awid_r_reg[0]_0 [19],\s_awid_r_reg[0]_0 [16:15]}),
        .\axlen_cnt_reg[3]_0 (cmd_translator_0_n_10),
        .b_full(b_full),
        .b_push(b_push),
        .cnt_read(cnt_read),
        .incr_next_pending(incr_next_pending),
        .m_axi_awready(m_axi_awready),
        .m_axi_awvalid(m_axi_awvalid),
        .\m_payload_i_reg[39] (aw_cmd_fsm_0_n_0),
        .\m_payload_i_reg[39]_0 (aw_cmd_fsm_0_n_3),
        .m_valid_i_reg(aw_cmd_fsm_0_n_6),
        .m_valid_i_reg_0(E),
        .next(next),
        .next_pending(next_pending),
        .next_pending_r_reg(next_pending_r_reg),
        .next_pending_r_reg_0(cmd_translator_0_n_1),
        .next_pending_r_reg_1(cmd_translator_0_n_23),
        .sel_first(sel_first),
        .sel_first_i(sel_first_i),
        .sel_first_reg(aw_cmd_fsm_0_n_9),
        .sel_first_reg_0(aw_cmd_fsm_0_n_10),
        .sel_first_reg_1(sel_first_0),
        .sel_first_reg_2(cmd_translator_0_n_2),
        .si_rs_awvalid(si_rs_awvalid),
        .wrap_next_pending(wrap_next_pending));
  mid_project_auto_pc_0_axi_protocol_converter_v2_1_18_b2s_cmd_translator cmd_translator_0
       (.D(D),
        .E(\state_reg[1] ),
        .Q(Q),
        .S(S),
        .aclk(aclk),
        .axaddr_incr(axaddr_incr),
        .\axaddr_incr_reg[11] (\axaddr_incr_reg[11] ),
        .\axaddr_offset_r_reg[3] (\axaddr_offset_r_reg[3] ),
        .\axaddr_wrap_reg[0] (aw_cmd_fsm_0_n_6),
        .\axlen_cnt_reg[0] (cmd_translator_0_n_7),
        .\axlen_cnt_reg[0]_0 (\state_reg[1]_0 ),
        .\axlen_cnt_reg[2] (cmd_translator_0_n_10),
        .\axlen_cnt_reg[2]_0 (cmd_translator_0_n_23),
        .\axlen_cnt_reg[3] (cmd_translator_0_n_8),
        .\axlen_cnt_reg[3]_0 (\axlen_cnt_reg[3] ),
        .\axlen_cnt_reg[3]_1 ({aw_cmd_fsm_0_n_11,aw_cmd_fsm_0_n_12}),
        .\axlen_cnt_reg[7] ({\s_awid_r_reg[0]_0 [23:20],\s_awid_r_reg[0]_0 [18:0]}),
        .incr_next_pending(incr_next_pending),
        .m_axi_awaddr(m_axi_awaddr),
        .\m_axi_awaddr[0]_0 (\m_axi_awaddr[0]_0 ),
        .m_axi_awaddr_0_sp_1(m_axi_awaddr_0_sn_1),
        .next(next),
        .next_pending(next_pending),
        .next_pending_r_reg(cmd_translator_0_n_1),
        .next_pending_r_reg_0(next_pending_r_reg_0),
        .s_axburst_eq0_reg_0(aw_cmd_fsm_0_n_0),
        .s_axburst_eq1_reg_0(aw_cmd_fsm_0_n_3),
        .sel_first(sel_first),
        .sel_first_i(sel_first_i),
        .sel_first_reg_0(cmd_translator_0_n_2),
        .sel_first_reg_1(sel_first_0),
        .sel_first_reg_2(sel_first_reg),
        .sel_first_reg_3(aw_cmd_fsm_0_n_10),
        .sel_first_reg_4(aw_cmd_fsm_0_n_9),
        .si_rs_awvalid(si_rs_awvalid),
        .\wrap_boundary_axaddr_r_reg[6] (\wrap_boundary_axaddr_r_reg[6] ),
        .\wrap_cnt_r_reg[3] (\wrap_cnt_r_reg[3] ),
        .wrap_next_pending(wrap_next_pending),
        .\wrap_second_len_r_reg[3] (\wrap_second_len_r_reg[3] ),
        .\wrap_second_len_r_reg[3]_0 (\wrap_second_len_r_reg[3]_0 ));
  FDRE \s_awid_r_reg[0] 
       (.C(aclk),
        .CE(1'b1),
        .D(\s_awid_r_reg[0]_0 [24]),
        .Q(in[8]),
        .R(1'b0));
  FDRE \s_awlen_r_reg[0] 
       (.C(aclk),
        .CE(1'b1),
        .D(\s_awid_r_reg[0]_0 [16]),
        .Q(in[0]),
        .R(1'b0));
  FDRE \s_awlen_r_reg[1] 
       (.C(aclk),
        .CE(1'b1),
        .D(\s_awid_r_reg[0]_0 [17]),
        .Q(in[1]),
        .R(1'b0));
  FDRE \s_awlen_r_reg[2] 
       (.C(aclk),
        .CE(1'b1),
        .D(\s_awid_r_reg[0]_0 [18]),
        .Q(in[2]),
        .R(1'b0));
  FDRE \s_awlen_r_reg[3] 
       (.C(aclk),
        .CE(1'b1),
        .D(\s_awid_r_reg[0]_0 [19]),
        .Q(in[3]),
        .R(1'b0));
  FDRE \s_awlen_r_reg[4] 
       (.C(aclk),
        .CE(1'b1),
        .D(\s_awid_r_reg[0]_0 [20]),
        .Q(in[4]),
        .R(1'b0));
  FDRE \s_awlen_r_reg[5] 
       (.C(aclk),
        .CE(1'b1),
        .D(\s_awid_r_reg[0]_0 [21]),
        .Q(in[5]),
        .R(1'b0));
  FDRE \s_awlen_r_reg[6] 
       (.C(aclk),
        .CE(1'b1),
        .D(\s_awid_r_reg[0]_0 [22]),
        .Q(in[6]),
        .R(1'b0));
  FDRE \s_awlen_r_reg[7] 
       (.C(aclk),
        .CE(1'b1),
        .D(\s_awid_r_reg[0]_0 [23]),
        .Q(in[7]),
        .R(1'b0));
endmodule

module mid_project_auto_pc_0_axi_protocol_converter_v2_1_18_b2s_b_channel
   (si_rs_bvalid,
    b_full,
    cnt_read,
    m_axi_bready,
    out,
    \s_bresp_acc_reg[1]_0 ,
    areset_d1,
    aclk,
    si_rs_bready,
    m_axi_bvalid,
    b_push,
    in,
    m_axi_bresp);
  output si_rs_bvalid;
  output b_full;
  output [1:0]cnt_read;
  output m_axi_bready;
  output [0:0]out;
  output [1:0]\s_bresp_acc_reg[1]_0 ;
  input areset_d1;
  input aclk;
  input si_rs_bready;
  input m_axi_bvalid;
  input b_push;
  input [8:0]in;
  input [1:0]m_axi_bresp;

  wire aclk;
  wire areset_d1;
  wire b_full;
  wire b_push;
  wire bid_fifo_0_n_5;
  wire \bresp_cnt[7]_i_5_n_0 ;
  wire [7:0]bresp_cnt_reg__0;
  wire bresp_empty;
  wire bresp_push;
  wire [1:0]cnt_read;
  wire [8:0]in;
  wire m_axi_bready;
  wire [1:0]m_axi_bresp;
  wire m_axi_bvalid;
  wire mhandshake;
  wire mhandshake_r;
  wire [0:0]out;
  wire [7:0]p_0_in;
  wire s_bresp_acc0;
  wire \s_bresp_acc[0]_i_1_n_0 ;
  wire \s_bresp_acc[1]_i_1_n_0 ;
  wire [1:0]\s_bresp_acc_reg[1]_0 ;
  wire \s_bresp_acc_reg_n_0_[0] ;
  wire \s_bresp_acc_reg_n_0_[1] ;
  wire shandshake;
  wire shandshake_r;
  wire si_rs_bready;
  wire si_rs_bvalid;

  mid_project_auto_pc_0_axi_protocol_converter_v2_1_18_b2s_simple_fifo bid_fifo_0
       (.Q(bresp_cnt_reg__0),
        .SR(s_bresp_acc0),
        .aclk(aclk),
        .addr(cnt_read),
        .areset_d1(areset_d1),
        .b_full(b_full),
        .b_push(b_push),
        .bresp_empty(bresp_empty),
        .bresp_push(bresp_push),
        .in(in),
        .mhandshake_r(mhandshake_r),
        .out(out),
        .shandshake_r(shandshake_r),
        .shandshake_r_reg(bid_fifo_0_n_5),
        .si_rs_bready(si_rs_bready),
        .si_rs_bvalid(si_rs_bvalid));
  LUT1 #(
    .INIT(2'h1)) 
    \bresp_cnt[0]_i_1 
       (.I0(bresp_cnt_reg__0[0]),
        .O(p_0_in[0]));
  (* SOFT_HLUTNM = "soft_lutpair109" *) 
  LUT2 #(
    .INIT(4'h6)) 
    \bresp_cnt[1]_i_1 
       (.I0(bresp_cnt_reg__0[0]),
        .I1(bresp_cnt_reg__0[1]),
        .O(p_0_in[1]));
  (* SOFT_HLUTNM = "soft_lutpair109" *) 
  LUT3 #(
    .INIT(8'h78)) 
    \bresp_cnt[2]_i_1 
       (.I0(bresp_cnt_reg__0[0]),
        .I1(bresp_cnt_reg__0[1]),
        .I2(bresp_cnt_reg__0[2]),
        .O(p_0_in[2]));
  (* SOFT_HLUTNM = "soft_lutpair108" *) 
  LUT4 #(
    .INIT(16'h7F80)) 
    \bresp_cnt[3]_i_1 
       (.I0(bresp_cnt_reg__0[1]),
        .I1(bresp_cnt_reg__0[0]),
        .I2(bresp_cnt_reg__0[2]),
        .I3(bresp_cnt_reg__0[3]),
        .O(p_0_in[3]));
  (* SOFT_HLUTNM = "soft_lutpair108" *) 
  LUT5 #(
    .INIT(32'h7FFF8000)) 
    \bresp_cnt[4]_i_1 
       (.I0(bresp_cnt_reg__0[2]),
        .I1(bresp_cnt_reg__0[0]),
        .I2(bresp_cnt_reg__0[1]),
        .I3(bresp_cnt_reg__0[3]),
        .I4(bresp_cnt_reg__0[4]),
        .O(p_0_in[4]));
  LUT6 #(
    .INIT(64'h7FFFFFFF80000000)) 
    \bresp_cnt[5]_i_1 
       (.I0(bresp_cnt_reg__0[3]),
        .I1(bresp_cnt_reg__0[1]),
        .I2(bresp_cnt_reg__0[0]),
        .I3(bresp_cnt_reg__0[2]),
        .I4(bresp_cnt_reg__0[4]),
        .I5(bresp_cnt_reg__0[5]),
        .O(p_0_in[5]));
  (* SOFT_HLUTNM = "soft_lutpair110" *) 
  LUT2 #(
    .INIT(4'h6)) 
    \bresp_cnt[6]_i_1 
       (.I0(\bresp_cnt[7]_i_5_n_0 ),
        .I1(bresp_cnt_reg__0[6]),
        .O(p_0_in[6]));
  (* SOFT_HLUTNM = "soft_lutpair110" *) 
  LUT3 #(
    .INIT(8'h78)) 
    \bresp_cnt[7]_i_2 
       (.I0(\bresp_cnt[7]_i_5_n_0 ),
        .I1(bresp_cnt_reg__0[6]),
        .I2(bresp_cnt_reg__0[7]),
        .O(p_0_in[7]));
  LUT6 #(
    .INIT(64'h8000000000000000)) 
    \bresp_cnt[7]_i_5 
       (.I0(bresp_cnt_reg__0[5]),
        .I1(bresp_cnt_reg__0[3]),
        .I2(bresp_cnt_reg__0[1]),
        .I3(bresp_cnt_reg__0[0]),
        .I4(bresp_cnt_reg__0[2]),
        .I5(bresp_cnt_reg__0[4]),
        .O(\bresp_cnt[7]_i_5_n_0 ));
  FDRE \bresp_cnt_reg[0] 
       (.C(aclk),
        .CE(mhandshake_r),
        .D(p_0_in[0]),
        .Q(bresp_cnt_reg__0[0]),
        .R(s_bresp_acc0));
  FDRE \bresp_cnt_reg[1] 
       (.C(aclk),
        .CE(mhandshake_r),
        .D(p_0_in[1]),
        .Q(bresp_cnt_reg__0[1]),
        .R(s_bresp_acc0));
  FDRE \bresp_cnt_reg[2] 
       (.C(aclk),
        .CE(mhandshake_r),
        .D(p_0_in[2]),
        .Q(bresp_cnt_reg__0[2]),
        .R(s_bresp_acc0));
  FDRE \bresp_cnt_reg[3] 
       (.C(aclk),
        .CE(mhandshake_r),
        .D(p_0_in[3]),
        .Q(bresp_cnt_reg__0[3]),
        .R(s_bresp_acc0));
  FDRE \bresp_cnt_reg[4] 
       (.C(aclk),
        .CE(mhandshake_r),
        .D(p_0_in[4]),
        .Q(bresp_cnt_reg__0[4]),
        .R(s_bresp_acc0));
  FDRE \bresp_cnt_reg[5] 
       (.C(aclk),
        .CE(mhandshake_r),
        .D(p_0_in[5]),
        .Q(bresp_cnt_reg__0[5]),
        .R(s_bresp_acc0));
  FDRE \bresp_cnt_reg[6] 
       (.C(aclk),
        .CE(mhandshake_r),
        .D(p_0_in[6]),
        .Q(bresp_cnt_reg__0[6]),
        .R(s_bresp_acc0));
  FDRE \bresp_cnt_reg[7] 
       (.C(aclk),
        .CE(mhandshake_r),
        .D(p_0_in[7]),
        .Q(bresp_cnt_reg__0[7]),
        .R(s_bresp_acc0));
  mid_project_auto_pc_0_axi_protocol_converter_v2_1_18_b2s_simple_fifo__parameterized0 bresp_fifo_0
       (.aclk(aclk),
        .areset_d1(areset_d1),
        .bresp_empty(bresp_empty),
        .bresp_push(bresp_push),
        .in({\s_bresp_acc_reg_n_0_[1] ,\s_bresp_acc_reg_n_0_[0] }),
        .m_axi_bready(m_axi_bready),
        .m_axi_bvalid(m_axi_bvalid),
        .mhandshake(mhandshake),
        .mhandshake_r(mhandshake_r),
        .\s_bresp_acc_reg[1] (\s_bresp_acc_reg[1]_0 ),
        .shandshake_r(shandshake_r));
  FDRE #(
    .INIT(1'b0)) 
    bvalid_i_reg
       (.C(aclk),
        .CE(1'b1),
        .D(bid_fifo_0_n_5),
        .Q(si_rs_bvalid),
        .R(1'b0));
  FDRE #(
    .INIT(1'b0)) 
    mhandshake_r_reg
       (.C(aclk),
        .CE(1'b1),
        .D(mhandshake),
        .Q(mhandshake_r),
        .R(areset_d1));
  LUT6 #(
    .INIT(64'h00000000EACECCCC)) 
    \s_bresp_acc[0]_i_1 
       (.I0(m_axi_bresp[0]),
        .I1(\s_bresp_acc_reg_n_0_[0] ),
        .I2(\s_bresp_acc_reg_n_0_[1] ),
        .I3(m_axi_bresp[1]),
        .I4(mhandshake),
        .I5(s_bresp_acc0),
        .O(\s_bresp_acc[0]_i_1_n_0 ));
  LUT4 #(
    .INIT(16'h00EA)) 
    \s_bresp_acc[1]_i_1 
       (.I0(\s_bresp_acc_reg_n_0_[1] ),
        .I1(m_axi_bresp[1]),
        .I2(mhandshake),
        .I3(s_bresp_acc0),
        .O(\s_bresp_acc[1]_i_1_n_0 ));
  FDRE \s_bresp_acc_reg[0] 
       (.C(aclk),
        .CE(1'b1),
        .D(\s_bresp_acc[0]_i_1_n_0 ),
        .Q(\s_bresp_acc_reg_n_0_[0] ),
        .R(1'b0));
  FDRE \s_bresp_acc_reg[1] 
       (.C(aclk),
        .CE(1'b1),
        .D(\s_bresp_acc[1]_i_1_n_0 ),
        .Q(\s_bresp_acc_reg_n_0_[1] ),
        .R(1'b0));
  LUT2 #(
    .INIT(4'h8)) 
    shandshake_r_i_1
       (.I0(si_rs_bvalid),
        .I1(si_rs_bready),
        .O(shandshake));
  FDRE #(
    .INIT(1'b0)) 
    shandshake_r_reg
       (.C(aclk),
        .CE(1'b1),
        .D(shandshake),
        .Q(shandshake_r),
        .R(areset_d1));
endmodule

module mid_project_auto_pc_0_axi_protocol_converter_v2_1_18_b2s_cmd_translator
   (incr_next_pending,
    next_pending_r_reg,
    sel_first_reg_0,
    sel_first_reg_1,
    sel_first,
    Q,
    \axaddr_incr_reg[11] ,
    \axlen_cnt_reg[0] ,
    \axlen_cnt_reg[3] ,
    next_pending,
    \axlen_cnt_reg[2] ,
    m_axi_awaddr,
    sel_first_reg_2,
    \axlen_cnt_reg[2]_0 ,
    \axaddr_offset_r_reg[3] ,
    \wrap_second_len_r_reg[3] ,
    S,
    aclk,
    wrap_next_pending,
    sel_first_i,
    s_axburst_eq0_reg_0,
    s_axburst_eq1_reg_0,
    sel_first_reg_3,
    sel_first_reg_4,
    next,
    \axlen_cnt_reg[7] ,
    next_pending_r_reg_0,
    E,
    \axlen_cnt_reg[0]_0 ,
    si_rs_awvalid,
    \axlen_cnt_reg[3]_0 ,
    axaddr_incr,
    m_axi_awaddr_0_sp_1,
    \m_axi_awaddr[0]_0 ,
    \axaddr_wrap_reg[0] ,
    D,
    \wrap_second_len_r_reg[3]_0 ,
    \axlen_cnt_reg[3]_1 ,
    \wrap_cnt_r_reg[3] ,
    \wrap_boundary_axaddr_r_reg[6] );
  output incr_next_pending;
  output next_pending_r_reg;
  output sel_first_reg_0;
  output sel_first_reg_1;
  output sel_first;
  output [0:0]Q;
  output [0:0]\axaddr_incr_reg[11] ;
  output [0:0]\axlen_cnt_reg[0] ;
  output \axlen_cnt_reg[3] ;
  output next_pending;
  output \axlen_cnt_reg[2] ;
  output [10:0]m_axi_awaddr;
  output sel_first_reg_2;
  output \axlen_cnt_reg[2]_0 ;
  output [3:0]\axaddr_offset_r_reg[3] ;
  output [3:0]\wrap_second_len_r_reg[3] ;
  output [3:0]S;
  input aclk;
  input wrap_next_pending;
  input sel_first_i;
  input s_axburst_eq0_reg_0;
  input s_axburst_eq1_reg_0;
  input sel_first_reg_3;
  input sel_first_reg_4;
  input next;
  input [22:0]\axlen_cnt_reg[7] ;
  input next_pending_r_reg_0;
  input [0:0]E;
  input [1:0]\axlen_cnt_reg[0]_0 ;
  input si_rs_awvalid;
  input \axlen_cnt_reg[3]_0 ;
  input [11:0]axaddr_incr;
  input m_axi_awaddr_0_sp_1;
  input \m_axi_awaddr[0]_0 ;
  input [0:0]\axaddr_wrap_reg[0] ;
  input [3:0]D;
  input [3:0]\wrap_second_len_r_reg[3]_0 ;
  input [1:0]\axlen_cnt_reg[3]_1 ;
  input [3:0]\wrap_cnt_r_reg[3] ;
  input [6:0]\wrap_boundary_axaddr_r_reg[6] ;

  wire [3:0]D;
  wire [0:0]E;
  wire [0:0]Q;
  wire [3:0]S;
  wire aclk;
  wire [11:0]axaddr_incr;
  wire [0:0]\axaddr_incr_reg[11] ;
  wire [3:0]\axaddr_offset_r_reg[3] ;
  wire [10:0]axaddr_wrap;
  wire [0:0]\axaddr_wrap_reg[0] ;
  wire [0:0]\axlen_cnt_reg[0] ;
  wire [1:0]\axlen_cnt_reg[0]_0 ;
  wire \axlen_cnt_reg[2] ;
  wire \axlen_cnt_reg[2]_0 ;
  wire \axlen_cnt_reg[3] ;
  wire \axlen_cnt_reg[3]_0 ;
  wire [1:0]\axlen_cnt_reg[3]_1 ;
  wire [22:0]\axlen_cnt_reg[7] ;
  wire incr_next_pending;
  wire [10:0]m_axi_awaddr;
  wire \m_axi_awaddr[0]_0 ;
  wire m_axi_awaddr_0_sn_1;
  wire next;
  wire next_pending;
  wire next_pending_r_reg;
  wire next_pending_r_reg_0;
  wire s_axburst_eq0;
  wire s_axburst_eq0_reg_0;
  wire s_axburst_eq1;
  wire s_axburst_eq1_reg_0;
  wire sel_first;
  wire sel_first_i;
  wire sel_first_reg_0;
  wire sel_first_reg_1;
  wire sel_first_reg_2;
  wire sel_first_reg_3;
  wire sel_first_reg_4;
  wire si_rs_awvalid;
  wire [6:0]\wrap_boundary_axaddr_r_reg[6] ;
  wire [3:0]\wrap_cnt_r_reg[3] ;
  wire wrap_next_pending;
  wire [3:0]\wrap_second_len_r_reg[3] ;
  wire [3:0]\wrap_second_len_r_reg[3]_0 ;

  assign m_axi_awaddr_0_sn_1 = m_axi_awaddr_0_sp_1;
  mid_project_auto_pc_0_axi_protocol_converter_v2_1_18_b2s_incr_cmd incr_cmd_0
       (.E(E),
        .Q(axaddr_wrap),
        .S(S),
        .aclk(aclk),
        .axaddr_incr(axaddr_incr),
        .\axaddr_incr_reg[11]_0 (\axaddr_incr_reg[11] ),
        .\axlen_cnt_reg[0]_0 (\axlen_cnt_reg[0]_0 ),
        .\axlen_cnt_reg[0]_1 (\axaddr_wrap_reg[0] ),
        .\axlen_cnt_reg[3]_0 (\axlen_cnt_reg[3]_0 ),
        .\axlen_cnt_reg[7]_0 ({\axlen_cnt_reg[7] [22:12],\axlen_cnt_reg[7] [10:0]}),
        .incr_next_pending(incr_next_pending),
        .m_axi_awaddr(m_axi_awaddr),
        .\m_axi_awaddr[0]_0 (\m_axi_awaddr[0]_0 ),
        .m_axi_awaddr_0_sp_1(m_axi_awaddr_0_sn_1),
        .next(next),
        .next_pending_r_reg_0(next_pending_r_reg_0),
        .sel_first(sel_first),
        .sel_first_reg_0(sel_first_reg_1),
        .sel_first_reg_1(sel_first_reg_2),
        .sel_first_reg_2(sel_first_reg_3),
        .si_rs_awvalid(si_rs_awvalid));
  LUT3 #(
    .INIT(8'hB8)) 
    \memory_reg[3][0]_srl4_i_3 
       (.I0(s_axburst_eq1),
        .I1(\axlen_cnt_reg[7] [15]),
        .I2(s_axburst_eq0),
        .O(next_pending));
  FDRE s_axburst_eq0_reg
       (.C(aclk),
        .CE(1'b1),
        .D(s_axburst_eq0_reg_0),
        .Q(s_axburst_eq0),
        .R(1'b0));
  FDRE s_axburst_eq1_reg
       (.C(aclk),
        .CE(1'b1),
        .D(s_axburst_eq1_reg_0),
        .Q(s_axburst_eq1),
        .R(1'b0));
  FDRE sel_first_reg
       (.C(aclk),
        .CE(1'b1),
        .D(sel_first_i),
        .Q(sel_first_reg_0),
        .R(1'b0));
  mid_project_auto_pc_0_axi_protocol_converter_v2_1_18_b2s_wrap_cmd wrap_cmd_0
       (.D(D),
        .E(E),
        .Q({Q,axaddr_wrap}),
        .aclk(aclk),
        .\axaddr_offset_r_reg[3]_0 (\axaddr_offset_r_reg[3] ),
        .\axaddr_wrap_reg[0]_0 (\axaddr_wrap_reg[0] ),
        .\axlen_cnt_reg[0]_0 (\axlen_cnt_reg[0] ),
        .\axlen_cnt_reg[2]_0 (\axlen_cnt_reg[2] ),
        .\axlen_cnt_reg[2]_1 (\axlen_cnt_reg[2]_0 ),
        .\axlen_cnt_reg[2]_2 ({\axlen_cnt_reg[7] [18:17],\axlen_cnt_reg[7] [13:0]}),
        .\axlen_cnt_reg[3]_0 (\axlen_cnt_reg[3] ),
        .\axlen_cnt_reg[3]_1 (\axlen_cnt_reg[3]_1 ),
        .next(next),
        .next_pending_r_reg_0(next_pending_r_reg),
        .sel_first(sel_first),
        .sel_first_reg_0(sel_first_reg_4),
        .\wrap_boundary_axaddr_r_reg[6]_0 (\wrap_boundary_axaddr_r_reg[6] ),
        .\wrap_cnt_r_reg[3]_0 (\wrap_cnt_r_reg[3] ),
        .wrap_next_pending(wrap_next_pending),
        .\wrap_second_len_r_reg[3]_0 (\wrap_second_len_r_reg[3] ),
        .\wrap_second_len_r_reg[3]_1 (\wrap_second_len_r_reg[3]_0 ));
endmodule

(* ORIG_REF_NAME = "axi_protocol_converter_v2_1_18_b2s_cmd_translator" *) 
module mid_project_auto_pc_0_axi_protocol_converter_v2_1_18_b2s_cmd_translator_1
   (sel_first_reg_0,
    sel_first_reg_1,
    sel_first_reg_2,
    O,
    \axaddr_wrap_reg[7] ,
    \axaddr_wrap_reg[11] ,
    \axaddr_wrap_reg[11]_0 ,
    \axaddr_incr_reg[11] ,
    r_rlast,
    next_pending,
    \axlen_cnt_reg[4] ,
    m_axi_araddr,
    sel_first_reg_3,
    \axaddr_offset_r_reg[3] ,
    \wrap_second_len_r_reg[3] ,
    \wrap_boundary_axaddr_r_reg[11] ,
    S,
    aclk,
    sel_first_i,
    sel_first_reg_4,
    sel_first_reg_5,
    Q,
    next_pending_r_reg,
    E,
    r_push,
    next_pending_r_reg_0,
    \axlen_cnt_reg[3] ,
    \axaddr_incr_reg[11]_0 ,
    \axaddr_incr_reg[7] ,
    \axaddr_incr_reg[3] ,
    m_axi_araddr_0_sp_1,
    \m_axi_araddr[0]_0 ,
    \axlen_cnt_reg[3]_0 ,
    si_rs_arvalid,
    \axaddr_wrap_reg[0] ,
    axaddr_offset,
    D,
    \wrap_cnt_r_reg[3] ,
    \wrap_boundary_axaddr_r_reg[6] ,
    \axaddr_wrap_reg[11]_1 ,
    \axaddr_incr_reg[0] ,
    m_axi_arready);
  output sel_first_reg_0;
  output sel_first_reg_1;
  output sel_first_reg_2;
  output [3:0]O;
  output [3:0]\axaddr_wrap_reg[7] ;
  output [3:0]\axaddr_wrap_reg[11] ;
  output [0:0]\axaddr_wrap_reg[11]_0 ;
  output [0:0]\axaddr_incr_reg[11] ;
  output r_rlast;
  output next_pending;
  output \axlen_cnt_reg[4] ;
  output [10:0]m_axi_araddr;
  output sel_first_reg_3;
  output [3:0]\axaddr_offset_r_reg[3] ;
  output [3:0]\wrap_second_len_r_reg[3] ;
  output [11:0]\wrap_boundary_axaddr_r_reg[11] ;
  output [3:0]S;
  input aclk;
  input sel_first_i;
  input sel_first_reg_4;
  input sel_first_reg_5;
  input [23:0]Q;
  input next_pending_r_reg;
  input [0:0]E;
  input r_push;
  input next_pending_r_reg_0;
  input \axlen_cnt_reg[3] ;
  input [3:0]\axaddr_incr_reg[11]_0 ;
  input [3:0]\axaddr_incr_reg[7] ;
  input [3:0]\axaddr_incr_reg[3] ;
  input m_axi_araddr_0_sp_1;
  input \m_axi_araddr[0]_0 ;
  input [1:0]\axlen_cnt_reg[3]_0 ;
  input si_rs_arvalid;
  input [0:0]\axaddr_wrap_reg[0] ;
  input [3:0]axaddr_offset;
  input [3:0]D;
  input [3:0]\wrap_cnt_r_reg[3] ;
  input [6:0]\wrap_boundary_axaddr_r_reg[6] ;
  input [11:0]\axaddr_wrap_reg[11]_1 ;
  input [0:0]\axaddr_incr_reg[0] ;
  input m_axi_arready;

  wire [3:0]D;
  wire [0:0]E;
  wire [3:0]O;
  wire [23:0]Q;
  wire [3:0]S;
  wire aclk;
  wire [0:0]\axaddr_incr_reg[0] ;
  wire [0:0]\axaddr_incr_reg[11] ;
  wire [3:0]\axaddr_incr_reg[11]_0 ;
  wire [3:0]\axaddr_incr_reg[3] ;
  wire [3:0]\axaddr_incr_reg[7] ;
  wire [3:0]axaddr_offset;
  wire [3:0]\axaddr_offset_r_reg[3] ;
  wire [0:0]\axaddr_wrap_reg[0] ;
  wire [3:0]\axaddr_wrap_reg[11] ;
  wire [0:0]\axaddr_wrap_reg[11]_0 ;
  wire [11:0]\axaddr_wrap_reg[11]_1 ;
  wire [3:0]\axaddr_wrap_reg[7] ;
  wire \axlen_cnt_reg[3] ;
  wire [1:0]\axlen_cnt_reg[3]_0 ;
  wire \axlen_cnt_reg[4] ;
  wire incr_cmd_0_n_3;
  wire incr_next_pending;
  wire [10:0]m_axi_araddr;
  wire \m_axi_araddr[0]_0 ;
  wire m_axi_araddr_0_sn_1;
  wire m_axi_arready;
  wire next_pending;
  wire next_pending_r_reg;
  wire next_pending_r_reg_0;
  wire r_push;
  wire r_rlast;
  wire s_axburst_eq0;
  wire s_axburst_eq1;
  wire sel_first_i;
  wire sel_first_reg_0;
  wire sel_first_reg_1;
  wire sel_first_reg_2;
  wire sel_first_reg_3;
  wire sel_first_reg_4;
  wire sel_first_reg_5;
  wire si_rs_arvalid;
  wire [11:0]\wrap_boundary_axaddr_r_reg[11] ;
  wire [6:0]\wrap_boundary_axaddr_r_reg[6] ;
  wire wrap_cmd_0_n_10;
  wire wrap_cmd_0_n_11;
  wire wrap_cmd_0_n_12;
  wire wrap_cmd_0_n_13;
  wire wrap_cmd_0_n_14;
  wire wrap_cmd_0_n_15;
  wire wrap_cmd_0_n_16;
  wire wrap_cmd_0_n_17;
  wire wrap_cmd_0_n_26;
  wire wrap_cmd_0_n_7;
  wire wrap_cmd_0_n_8;
  wire wrap_cmd_0_n_9;
  wire [3:0]\wrap_cnt_r_reg[3] ;
  wire wrap_next_pending;
  wire [3:0]\wrap_second_len_r_reg[3] ;

  assign m_axi_araddr_0_sn_1 = m_axi_araddr_0_sp_1;
  (* SOFT_HLUTNM = "soft_lutpair13" *) 
  LUT3 #(
    .INIT(8'hB8)) 
    \FSM_sequential_state[1]_i_2 
       (.I0(s_axburst_eq1),
        .I1(Q[15]),
        .I2(s_axburst_eq0),
        .O(next_pending));
  mid_project_auto_pc_0_axi_protocol_converter_v2_1_18_b2s_incr_cmd_2 incr_cmd_0
       (.E(E),
        .Q({Q[23:20],Q[18:12],Q[10:0]}),
        .S(S),
        .aclk(aclk),
        .\axaddr_incr_reg[0]_0 (\axaddr_incr_reg[0] ),
        .\axaddr_incr_reg[11]_0 (\axaddr_incr_reg[11] ),
        .\axaddr_incr_reg[11]_1 (\axaddr_incr_reg[11]_0 ),
        .\axaddr_incr_reg[3]_0 (\axaddr_incr_reg[3] ),
        .\axaddr_incr_reg[7]_0 (\axaddr_incr_reg[7] ),
        .\axlen_cnt_reg[0]_0 (\axaddr_wrap_reg[0] ),
        .\axlen_cnt_reg[3]_0 (\axlen_cnt_reg[3] ),
        .\axlen_cnt_reg[5]_0 (\axlen_cnt_reg[3]_0 ),
        .incr_next_pending(incr_next_pending),
        .m_axi_araddr(m_axi_araddr),
        .\m_axi_araddr[0]_0 (\m_axi_araddr[0]_0 ),
        .\m_axi_araddr[0]_1 (sel_first_reg_2),
        .\m_axi_araddr[10] ({wrap_cmd_0_n_7,wrap_cmd_0_n_8,wrap_cmd_0_n_9,wrap_cmd_0_n_10,wrap_cmd_0_n_11,wrap_cmd_0_n_12,wrap_cmd_0_n_13,wrap_cmd_0_n_14,wrap_cmd_0_n_15,wrap_cmd_0_n_16,wrap_cmd_0_n_17}),
        .m_axi_araddr_0_sp_1(m_axi_araddr_0_sn_1),
        .m_axi_arready(m_axi_arready),
        .\m_payload_i_reg[39] (incr_cmd_0_n_3),
        .next_pending_r_reg_0(next_pending_r_reg_0),
        .r_push(r_push),
        .sel_first_i(sel_first_i),
        .sel_first_reg_0(sel_first_reg_1),
        .sel_first_reg_1(sel_first_reg_3),
        .sel_first_reg_2(sel_first_reg_4),
        .si_rs_arvalid(si_rs_arvalid),
        .wrap_next_pending(wrap_next_pending));
  (* SOFT_HLUTNM = "soft_lutpair13" *) 
  LUT3 #(
    .INIT(8'h1D)) 
    r_rlast_r_i_1
       (.I0(s_axburst_eq0),
        .I1(Q[15]),
        .I2(s_axburst_eq1),
        .O(r_rlast));
  FDRE s_axburst_eq0_reg
       (.C(aclk),
        .CE(1'b1),
        .D(incr_cmd_0_n_3),
        .Q(s_axburst_eq0),
        .R(1'b0));
  FDRE s_axburst_eq1_reg
       (.C(aclk),
        .CE(1'b1),
        .D(wrap_cmd_0_n_26),
        .Q(s_axburst_eq1),
        .R(1'b0));
  FDRE sel_first_reg
       (.C(aclk),
        .CE(1'b1),
        .D(sel_first_i),
        .Q(sel_first_reg_0),
        .R(1'b0));
  mid_project_auto_pc_0_axi_protocol_converter_v2_1_18_b2s_wrap_cmd_3 wrap_cmd_0
       (.D(D),
        .E(E),
        .O(O),
        .Q({\axaddr_wrap_reg[11]_0 ,wrap_cmd_0_n_7,wrap_cmd_0_n_8,wrap_cmd_0_n_9,wrap_cmd_0_n_10,wrap_cmd_0_n_11,wrap_cmd_0_n_12,wrap_cmd_0_n_13,wrap_cmd_0_n_14,wrap_cmd_0_n_15,wrap_cmd_0_n_16,wrap_cmd_0_n_17}),
        .aclk(aclk),
        .axaddr_offset(axaddr_offset),
        .\axaddr_offset_r_reg[3]_0 (\axaddr_offset_r_reg[3] ),
        .\axaddr_wrap_reg[0]_0 (\axaddr_wrap_reg[0] ),
        .\axaddr_wrap_reg[11]_0 (\axaddr_wrap_reg[11] ),
        .\axaddr_wrap_reg[11]_1 (\axaddr_wrap_reg[11]_1 ),
        .\axaddr_wrap_reg[7]_0 (\axaddr_wrap_reg[7] ),
        .\axlen_cnt_reg[3]_0 ({Q[19:15],Q[13:7]}),
        .\axlen_cnt_reg[3]_1 (\axlen_cnt_reg[3]_0 [1]),
        .\axlen_cnt_reg[4]_0 (\axlen_cnt_reg[4] ),
        .incr_next_pending(incr_next_pending),
        .\m_payload_i_reg[39] (wrap_cmd_0_n_26),
        .next_pending_r_reg_0(next_pending_r_reg),
        .r_push(r_push),
        .sel_first_i(sel_first_i),
        .sel_first_reg_0(sel_first_reg_2),
        .sel_first_reg_1(sel_first_reg_5),
        .si_rs_arvalid(si_rs_arvalid),
        .\wrap_boundary_axaddr_r_reg[11]_0 (\wrap_boundary_axaddr_r_reg[11] ),
        .\wrap_boundary_axaddr_r_reg[6]_0 (\wrap_boundary_axaddr_r_reg[6] ),
        .\wrap_cnt_r_reg[3]_0 (\wrap_cnt_r_reg[3] ),
        .wrap_next_pending(wrap_next_pending),
        .\wrap_second_len_r_reg[3]_0 (\wrap_second_len_r_reg[3] ));
endmodule

module mid_project_auto_pc_0_axi_protocol_converter_v2_1_18_b2s_incr_cmd
   (incr_next_pending,
    sel_first_reg_0,
    \axaddr_incr_reg[11]_0 ,
    m_axi_awaddr,
    sel_first_reg_1,
    S,
    aclk,
    sel_first_reg_2,
    next_pending_r_reg_0,
    E,
    next,
    \axlen_cnt_reg[0]_0 ,
    si_rs_awvalid,
    \axlen_cnt_reg[7]_0 ,
    \axlen_cnt_reg[3]_0 ,
    axaddr_incr,
    Q,
    m_axi_awaddr_0_sp_1,
    \m_axi_awaddr[0]_0 ,
    sel_first,
    \axlen_cnt_reg[0]_1 );
  output incr_next_pending;
  output sel_first_reg_0;
  output [0:0]\axaddr_incr_reg[11]_0 ;
  output [10:0]m_axi_awaddr;
  output sel_first_reg_1;
  output [3:0]S;
  input aclk;
  input sel_first_reg_2;
  input next_pending_r_reg_0;
  input [0:0]E;
  input next;
  input [1:0]\axlen_cnt_reg[0]_0 ;
  input si_rs_awvalid;
  input [21:0]\axlen_cnt_reg[7]_0 ;
  input \axlen_cnt_reg[3]_0 ;
  input [11:0]axaddr_incr;
  input [10:0]Q;
  input m_axi_awaddr_0_sp_1;
  input \m_axi_awaddr[0]_0 ;
  input sel_first;
  input [0:0]\axlen_cnt_reg[0]_1 ;

  wire [0:0]E;
  wire [10:0]Q;
  wire [3:0]S;
  wire aclk;
  wire [11:0]axaddr_incr;
  wire \axaddr_incr[11]_i_1_n_0 ;
  wire \axaddr_incr[3]_i_12_n_0 ;
  wire \axaddr_incr[3]_i_13_n_0 ;
  wire \axaddr_incr[3]_i_14_n_0 ;
  wire \axaddr_incr[3]_i_15_n_0 ;
  wire [0:0]\axaddr_incr_reg[11]_0 ;
  wire \axaddr_incr_reg[11]_i_4_n_1 ;
  wire \axaddr_incr_reg[11]_i_4_n_2 ;
  wire \axaddr_incr_reg[11]_i_4_n_3 ;
  wire \axaddr_incr_reg[11]_i_4_n_4 ;
  wire \axaddr_incr_reg[11]_i_4_n_5 ;
  wire \axaddr_incr_reg[11]_i_4_n_6 ;
  wire \axaddr_incr_reg[11]_i_4_n_7 ;
  wire \axaddr_incr_reg[3]_i_3_n_0 ;
  wire \axaddr_incr_reg[3]_i_3_n_1 ;
  wire \axaddr_incr_reg[3]_i_3_n_2 ;
  wire \axaddr_incr_reg[3]_i_3_n_3 ;
  wire \axaddr_incr_reg[3]_i_3_n_4 ;
  wire \axaddr_incr_reg[3]_i_3_n_5 ;
  wire \axaddr_incr_reg[3]_i_3_n_6 ;
  wire \axaddr_incr_reg[3]_i_3_n_7 ;
  wire \axaddr_incr_reg[7]_i_3_n_0 ;
  wire \axaddr_incr_reg[7]_i_3_n_1 ;
  wire \axaddr_incr_reg[7]_i_3_n_2 ;
  wire \axaddr_incr_reg[7]_i_3_n_3 ;
  wire \axaddr_incr_reg[7]_i_3_n_4 ;
  wire \axaddr_incr_reg[7]_i_3_n_5 ;
  wire \axaddr_incr_reg[7]_i_3_n_6 ;
  wire \axaddr_incr_reg[7]_i_3_n_7 ;
  wire \axaddr_incr_reg_n_0_[0] ;
  wire \axaddr_incr_reg_n_0_[10] ;
  wire \axaddr_incr_reg_n_0_[1] ;
  wire \axaddr_incr_reg_n_0_[2] ;
  wire \axaddr_incr_reg_n_0_[3] ;
  wire \axaddr_incr_reg_n_0_[4] ;
  wire \axaddr_incr_reg_n_0_[5] ;
  wire \axaddr_incr_reg_n_0_[6] ;
  wire \axaddr_incr_reg_n_0_[7] ;
  wire \axaddr_incr_reg_n_0_[8] ;
  wire \axaddr_incr_reg_n_0_[9] ;
  wire [8:0]axlen_cnt;
  wire \axlen_cnt[0]_i_1__0_n_0 ;
  wire \axlen_cnt[1]_i_1__0_n_0 ;
  wire \axlen_cnt[2]_i_1__0_n_0 ;
  wire \axlen_cnt[3]_i_1__0_n_0 ;
  wire \axlen_cnt[4]_i_1__0_n_0 ;
  wire \axlen_cnt[4]_i_2_n_0 ;
  wire \axlen_cnt[5]_i_1_n_0 ;
  wire \axlen_cnt[5]_i_2_n_0 ;
  wire \axlen_cnt[6]_i_1_n_0 ;
  wire \axlen_cnt[7]_i_1_n_0 ;
  wire \axlen_cnt[8]_i_2_n_0 ;
  wire \axlen_cnt[8]_i_3_n_0 ;
  wire [1:0]\axlen_cnt_reg[0]_0 ;
  wire [0:0]\axlen_cnt_reg[0]_1 ;
  wire \axlen_cnt_reg[3]_0 ;
  wire [21:0]\axlen_cnt_reg[7]_0 ;
  wire incr_next_pending;
  wire [10:0]m_axi_awaddr;
  wire \m_axi_awaddr[0]_0 ;
  wire m_axi_awaddr_0_sn_1;
  wire next;
  wire next_pending_r_i_3_n_0;
  wire next_pending_r_i_5_n_0;
  wire next_pending_r_i_7_n_0;
  wire next_pending_r_i_8_n_0;
  wire next_pending_r_i_9_n_0;
  wire next_pending_r_reg_0;
  wire next_pending_r_reg_n_0;
  wire [11:0]p_1_in;
  wire sel_first;
  wire sel_first_reg_0;
  wire sel_first_reg_1;
  wire sel_first_reg_2;
  wire si_rs_awvalid;
  wire [3:3]\NLW_axaddr_incr_reg[11]_i_4_CO_UNCONNECTED ;

  assign m_axi_awaddr_0_sn_1 = m_axi_awaddr_0_sp_1;
  (* SOFT_HLUTNM = "soft_lutpair98" *) 
  LUT3 #(
    .INIT(8'hB8)) 
    \axaddr_incr[0]_i_1 
       (.I0(axaddr_incr[0]),
        .I1(sel_first_reg_0),
        .I2(\axaddr_incr_reg[3]_i_3_n_7 ),
        .O(p_1_in[0]));
  (* SOFT_HLUTNM = "soft_lutpair99" *) 
  LUT3 #(
    .INIT(8'hB8)) 
    \axaddr_incr[10]_i_1 
       (.I0(axaddr_incr[10]),
        .I1(sel_first_reg_0),
        .I2(\axaddr_incr_reg[11]_i_4_n_5 ),
        .O(p_1_in[10]));
  LUT2 #(
    .INIT(4'hE)) 
    \axaddr_incr[11]_i_1 
       (.I0(sel_first_reg_0),
        .I1(next),
        .O(\axaddr_incr[11]_i_1_n_0 ));
  (* SOFT_HLUTNM = "soft_lutpair98" *) 
  LUT3 #(
    .INIT(8'hB8)) 
    \axaddr_incr[11]_i_2 
       (.I0(axaddr_incr[11]),
        .I1(sel_first_reg_0),
        .I2(\axaddr_incr_reg[11]_i_4_n_4 ),
        .O(p_1_in[11]));
  (* SOFT_HLUTNM = "soft_lutpair99" *) 
  LUT3 #(
    .INIT(8'hB8)) 
    \axaddr_incr[1]_i_1 
       (.I0(axaddr_incr[1]),
        .I1(sel_first_reg_0),
        .I2(\axaddr_incr_reg[3]_i_3_n_6 ),
        .O(p_1_in[1]));
  (* SOFT_HLUTNM = "soft_lutpair100" *) 
  LUT3 #(
    .INIT(8'hB8)) 
    \axaddr_incr[2]_i_1 
       (.I0(axaddr_incr[2]),
        .I1(sel_first_reg_0),
        .I2(\axaddr_incr_reg[3]_i_3_n_5 ),
        .O(p_1_in[2]));
  (* SOFT_HLUTNM = "soft_lutpair101" *) 
  LUT3 #(
    .INIT(8'hB8)) 
    \axaddr_incr[3]_i_1 
       (.I0(axaddr_incr[3]),
        .I1(sel_first_reg_0),
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
        .D(p_1_in[1]),
        .Q(\axaddr_incr_reg_n_0_[1] ),
        .R(1'b0));
  FDRE \axaddr_incr_reg[2] 
       (.C(aclk),
        .CE(\axaddr_incr[11]_i_1_n_0 ),
        .D(p_1_in[2]),
        .Q(\axaddr_incr_reg_n_0_[2] ),
        .R(1'b0));
  FDRE \axaddr_incr_reg[3] 
       (.C(aclk),
        .CE(\axaddr_incr[11]_i_1_n_0 ),
        .D(p_1_in[3]),
        .Q(\axaddr_incr_reg_n_0_[3] ),
        .R(1'b0));
  CARRY4 \axaddr_incr_reg[3]_i_3 
       (.CI(1'b0),
        .CO({\axaddr_incr_reg[3]_i_3_n_0 ,\axaddr_incr_reg[3]_i_3_n_1 ,\axaddr_incr_reg[3]_i_3_n_2 ,\axaddr_incr_reg[3]_i_3_n_3 }),
        .CYINIT(1'b0),
        .DI({\axaddr_incr_reg_n_0_[3] ,\axaddr_incr_reg_n_0_[2] ,\axaddr_incr_reg_n_0_[1] ,\axaddr_incr_reg_n_0_[0] }),
        .O({\axaddr_incr_reg[3]_i_3_n_4 ,\axaddr_incr_reg[3]_i_3_n_5 ,\axaddr_incr_reg[3]_i_3_n_6 ,\axaddr_incr_reg[3]_i_3_n_7 }),
        .S({\axaddr_incr[3]_i_12_n_0 ,\axaddr_incr[3]_i_13_n_0 ,\axaddr_incr[3]_i_14_n_0 ,\axaddr_incr[3]_i_15_n_0 }));
  FDRE \axaddr_incr_reg[4] 
       (.C(aclk),
        .CE(\axaddr_incr[11]_i_1_n_0 ),
        .D(p_1_in[4]),
        .Q(\axaddr_incr_reg_n_0_[4] ),
        .R(1'b0));
  FDRE \axaddr_incr_reg[5] 
       (.C(aclk),
        .CE(\axaddr_incr[11]_i_1_n_0 ),
        .D(p_1_in[5]),
        .Q(\axaddr_incr_reg_n_0_[5] ),
        .R(1'b0));
  FDRE \axaddr_incr_reg[6] 
       (.C(aclk),
        .CE(\axaddr_incr[11]_i_1_n_0 ),
        .D(p_1_in[6]),
        .Q(\axaddr_incr_reg_n_0_[6] ),
        .R(1'b0));
  FDRE \axaddr_incr_reg[7] 
       (.C(aclk),
        .CE(\axaddr_incr[11]_i_1_n_0 ),
        .D(p_1_in[7]),
        .Q(\axaddr_incr_reg_n_0_[7] ),
        .R(1'b0));
  CARRY4 \axaddr_incr_reg[7]_i_3 
       (.CI(\axaddr_incr_reg[3]_i_3_n_0 ),
        .CO({\axaddr_incr_reg[7]_i_3_n_0 ,\axaddr_incr_reg[7]_i_3_n_1 ,\axaddr_incr_reg[7]_i_3_n_2 ,\axaddr_incr_reg[7]_i_3_n_3 }),
        .CYINIT(1'b0),
        .DI({1'b0,1'b0,1'b0,1'b0}),
        .O({\axaddr_incr_reg[7]_i_3_n_4 ,\axaddr_incr_reg[7]_i_3_n_5 ,\axaddr_incr_reg[7]_i_3_n_6 ,\axaddr_incr_reg[7]_i_3_n_7 }),
        .S({\axaddr_incr_reg_n_0_[7] ,\axaddr_incr_reg_n_0_[6] ,\axaddr_incr_reg_n_0_[5] ,\axaddr_incr_reg_n_0_[4] }));
  FDRE \axaddr_incr_reg[8] 
       (.C(aclk),
        .CE(\axaddr_incr[11]_i_1_n_0 ),
        .D(p_1_in[8]),
        .Q(\axaddr_incr_reg_n_0_[8] ),
        .R(1'b0));
  FDRE \axaddr_incr_reg[9] 
       (.C(aclk),
        .CE(\axaddr_incr[11]_i_1_n_0 ),
        .D(p_1_in[9]),
        .Q(\axaddr_incr_reg_n_0_[9] ),
        .R(1'b0));
  LUT6 #(
    .INIT(64'h444F444444444444)) 
    \axlen_cnt[0]_i_1__0 
       (.I0(axlen_cnt[0]),
        .I1(next_pending_r_i_5_n_0),
        .I2(\axlen_cnt_reg[0]_0 [1]),
        .I3(\axlen_cnt_reg[0]_0 [0]),
        .I4(si_rs_awvalid),
        .I5(\axlen_cnt_reg[7]_0 [15]),
        .O(\axlen_cnt[0]_i_1__0_n_0 ));
  (* SOFT_HLUTNM = "soft_lutpair96" *) 
  LUT5 #(
    .INIT(32'hFF909090)) 
    \axlen_cnt[1]_i_1__0 
       (.I0(axlen_cnt[0]),
        .I1(axlen_cnt[1]),
        .I2(next_pending_r_i_5_n_0),
        .I3(E),
        .I4(\axlen_cnt_reg[7]_0 [16]),
        .O(\axlen_cnt[1]_i_1__0_n_0 ));
  LUT6 #(
    .INIT(64'hFFFFE100E100E100)) 
    \axlen_cnt[2]_i_1__0 
       (.I0(axlen_cnt[1]),
        .I1(axlen_cnt[0]),
        .I2(axlen_cnt[2]),
        .I3(next_pending_r_i_5_n_0),
        .I4(E),
        .I5(\axlen_cnt_reg[7]_0 [17]),
        .O(\axlen_cnt[2]_i_1__0_n_0 ));
  LUT6 #(
    .INIT(64'hFFFFFFFFFE010000)) 
    \axlen_cnt[3]_i_1__0 
       (.I0(axlen_cnt[2]),
        .I1(axlen_cnt[0]),
        .I2(axlen_cnt[1]),
        .I3(axlen_cnt[3]),
        .I4(next_pending_r_i_5_n_0),
        .I5(\axlen_cnt_reg[3]_0 ),
        .O(\axlen_cnt[3]_i_1__0_n_0 ));
  LUT6 #(
    .INIT(64'h888F888888888888)) 
    \axlen_cnt[4]_i_1__0 
       (.I0(\axlen_cnt[4]_i_2_n_0 ),
        .I1(next_pending_r_i_5_n_0),
        .I2(\axlen_cnt_reg[0]_0 [1]),
        .I3(\axlen_cnt_reg[0]_0 [0]),
        .I4(si_rs_awvalid),
        .I5(\axlen_cnt_reg[7]_0 [18]),
        .O(\axlen_cnt[4]_i_1__0_n_0 ));
  LUT5 #(
    .INIT(32'hFFFE0001)) 
    \axlen_cnt[4]_i_2 
       (.I0(axlen_cnt[3]),
        .I1(axlen_cnt[1]),
        .I2(axlen_cnt[0]),
        .I3(axlen_cnt[2]),
        .I4(axlen_cnt[4]),
        .O(\axlen_cnt[4]_i_2_n_0 ));
  LUT6 #(
    .INIT(64'h888F888888888888)) 
    \axlen_cnt[5]_i_1 
       (.I0(\axlen_cnt[5]_i_2_n_0 ),
        .I1(next_pending_r_i_5_n_0),
        .I2(\axlen_cnt_reg[0]_0 [1]),
        .I3(\axlen_cnt_reg[0]_0 [0]),
        .I4(si_rs_awvalid),
        .I5(\axlen_cnt_reg[7]_0 [19]),
        .O(\axlen_cnt[5]_i_1_n_0 ));
  LUT6 #(
    .INIT(64'hFFFFFFFE00000001)) 
    \axlen_cnt[5]_i_2 
       (.I0(axlen_cnt[4]),
        .I1(axlen_cnt[2]),
        .I2(axlen_cnt[0]),
        .I3(axlen_cnt[1]),
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
        .I3(\axaddr_incr_reg_n_0_[3] ),
        .I4(\axlen_cnt_reg[7]_0 [3]),
        .I5(sel_first_reg_1),
        .O(m_axi_awaddr[3]));
  LUT6 #(
    .INIT(64'hFFFFF888F888F888)) 
    \m_axi_awaddr[4]_INST_0 
       (.I0(Q[4]),
        .I1(m_axi_awaddr_0_sn_1),
        .I2(\m_axi_awaddr[0]_0 ),
        .I3(\axaddr_incr_reg_n_0_[4] ),
        .I4(\axlen_cnt_reg[7]_0 [4]),
        .I5(sel_first_reg_1),
        .O(m_axi_awaddr[4]));
  LUT6 #(
    .INIT(64'hFFFFF888F888F888)) 
    \m_axi_awaddr[5]_INST_0 
       (.I0(Q[5]),
        .I1(m_axi_awaddr_0_sn_1),
        .I2(\m_axi_awaddr[0]_0 ),
        .I3(\axaddr_incr_reg_n_0_[5] ),
        .I4(\axlen_cnt_reg[7]_0 [5]),
        .I5(sel_first_reg_1),
        .O(m_axi_awaddr[5]));
  LUT6 #(
    .INIT(64'hFFFFF888F888F888)) 
    \m_axi_awaddr[6]_INST_0 
       (.I0(Q[6]),
        .I1(m_axi_awaddr_0_sn_1),
        .I2(\m_axi_awaddr[0]_0 ),
        .I3(\axaddr_incr_reg_n_0_[6] ),
        .I4(\axlen_cnt_reg[7]_0 [6]),
        .I5(sel_first_reg_1),
        .O(m_axi_awaddr[6]));
  LUT6 #(
    .INIT(64'hFFFFF888F888F888)) 
    \m_axi_awaddr[7]_INST_0 
       (.I0(Q[7]),
        .I1(m_axi_awaddr_0_sn_1),
        .I2(\m_axi_awaddr[0]_0 ),
        .I3(\axaddr_incr_reg_n_0_[7] ),
        .I4(\axlen_cnt_reg[7]_0 [7]),
        .I5(sel_first_reg_1),
        .O(m_axi_awaddr[7]));
  LUT6 #(
    .INIT(64'hFFFFF888F888F888)) 
    \m_axi_awaddr[8]_INST_0 
       (.I0(Q[8]),
        .I1(m_axi_awaddr_0_sn_1),
        .I2(\m_axi_awaddr[0]_0 ),
        .I3(\axaddr_incr_reg_n_0_[8] ),
        .I4(\axlen_cnt_reg[7]_0 [8]),
        .I5(sel_first_reg_1),
        .O(m_axi_awaddr[8]));
  LUT6 #(
    .INIT(64'hFFFFF888F888F888)) 
    \m_axi_awaddr[9]_INST_0 
       (.I0(Q[9]),
        .I1(m_axi_awaddr_0_sn_1),
        .I2(\m_axi_awaddr[0]_0 ),
        .I3(\axaddr_incr_reg_n_0_[9] ),
        .I4(\axlen_cnt_reg[7]_0 [9]),
        .I5(sel_first_reg_1),
        .O(m_axi_awaddr[9]));
  LUT6 #(
    .INIT(64'hFF88B8B88888B8B8)) 
    next_pending_r_i_1__0
       (.I0(next_pending_r_reg_0),
        .I1(E),
        .I2(next_pending_r_reg_n_0),
        .I3(next_pending_r_i_3_n_0),
        .I4(next),
        .I5(next_pending_r_i_5_n_0),
        .O(incr_next_pending));
  LUT6 #(
    .INIT(64'hFFFFFFFFFFFFFEEF)) 
    next_pending_r_i_3
       (.I0(next_pending_r_i_7_n_0),
        .I1(axlen_cnt[7]),
        .I2(\axlen_cnt[8]_i_3_n_0 ),
        .I3(axlen_cnt[6]),
        .I4(axlen_cnt[8]),
        .I5(next_pending_r_i_8_n_0),
        .O(next_pending_r_i_3_n_0));
  LUT6 #(
    .INIT(64'h00000000FFFFFFFE)) 
    next_pending_r_i_5
       (.I0(next_pending_r_i_9_n_0),
        .I1(axlen_cnt[2]),
        .I2(axlen_cnt[1]),
        .I3(axlen_cnt[4]),
        .I4(axlen_cnt[3]),
        .I5(E),
        .O(next_pending_r_i_5_n_0));
  LUT6 #(
    .INIT(64'hFFFFFFFFFFFFEEEB)) 
    next_pending_r_i_7
       (.I0(axlen_cnt[4]),
        .I1(axlen_cnt[2]),
        .I2(axlen_cnt[0]),
        .I3(axlen_cnt[1]),
        .I4(axlen_cnt[3]),
        .I5(axlen_cnt[5]),
        .O(next_pending_r_i_7_n_0));
  (* SOFT_HLUTNM = "soft_lutpair96" *) 
  LUT2 #(
    .INIT(4'hB)) 
    next_pending_r_i_8
       (.I0(axlen_cnt[1]),
        .I1(axlen_cnt[0]),
        .O(next_pending_r_i_8_n_0));
  LUT4 #(
    .INIT(16'hFFFE)) 
    next_pending_r_i_9
       (.I0(axlen_cnt[6]),
        .I1(axlen_cnt[5]),
        .I2(axlen_cnt[8]),
        .I3(axlen_cnt[7]),
        .O(next_pending_r_i_9_n_0));
  FDRE next_pending_r_reg
       (.C(aclk),
        .CE(1'b1),
        .D(incr_next_pending),
        .Q(next_pending_r_reg_n_0),
        .R(1'b0));
  FDRE sel_first_reg
       (.C(aclk),
        .CE(1'b1),
        .D(sel_first_reg_2),
        .Q(sel_first_reg_0),
        .R(1'b0));
endmodule

(* ORIG_REF_NAME = "axi_protocol_converter_v2_1_18_b2s_incr_cmd" *) 
module mid_project_auto_pc_0_axi_protocol_converter_v2_1_18_b2s_incr_cmd_2
   (incr_next_pending,
    sel_first_reg_0,
    \axaddr_incr_reg[11]_0 ,
    \m_payload_i_reg[39] ,
    m_axi_araddr,
    sel_first_reg_1,
    S,
    aclk,
    sel_first_reg_2,
    sel_first_i,
    Q,
    wrap_next_pending,
    next_pending_r_reg_0,
    E,
    r_push,
    \axlen_cnt_reg[3]_0 ,
    \axaddr_incr_reg[11]_1 ,
    \axaddr_incr_reg[7]_0 ,
    \axaddr_incr_reg[3]_0 ,
    \m_axi_araddr[10] ,
    m_axi_araddr_0_sp_1,
    \m_axi_araddr[0]_0 ,
    \m_axi_araddr[0]_1 ,
    \axlen_cnt_reg[5]_0 ,
    si_rs_arvalid,
    \axlen_cnt_reg[0]_0 ,
    \axaddr_incr_reg[0]_0 ,
    m_axi_arready);
  output incr_next_pending;
  output sel_first_reg_0;
  output [0:0]\axaddr_incr_reg[11]_0 ;
  output \m_payload_i_reg[39] ;
  output [10:0]m_axi_araddr;
  output sel_first_reg_1;
  output [3:0]S;
  input aclk;
  input sel_first_reg_2;
  input sel_first_i;
  input [21:0]Q;
  input wrap_next_pending;
  input next_pending_r_reg_0;
  input [0:0]E;
  input r_push;
  input \axlen_cnt_reg[3]_0 ;
  input [3:0]\axaddr_incr_reg[11]_1 ;
  input [3:0]\axaddr_incr_reg[7]_0 ;
  input [3:0]\axaddr_incr_reg[3]_0 ;
  input [10:0]\m_axi_araddr[10] ;
  input m_axi_araddr_0_sp_1;
  input \m_axi_araddr[0]_0 ;
  input \m_axi_araddr[0]_1 ;
  input [1:0]\axlen_cnt_reg[5]_0 ;
  input si_rs_arvalid;
  input [0:0]\axlen_cnt_reg[0]_0 ;
  input [0:0]\axaddr_incr_reg[0]_0 ;
  input m_axi_arready;

  wire [0:0]E;
  wire [21:0]Q;
  wire [3:0]S;
  wire aclk;
  wire \axaddr_incr[0]_i_1__0_n_0 ;
  wire \axaddr_incr[10]_i_1__0_n_0 ;
  wire \axaddr_incr[11]_i_2__0_n_0 ;
  wire \axaddr_incr[1]_i_1__0_n_0 ;
  wire \axaddr_incr[2]_i_1__0_n_0 ;
  wire \axaddr_incr[3]_i_12_n_0 ;
  wire \axaddr_incr[3]_i_13_n_0 ;
  wire \axaddr_incr[3]_i_14_n_0 ;
  wire \axaddr_incr[3]_i_15_n_0 ;
  wire \axaddr_incr[3]_i_1__0_n_0 ;
  wire \axaddr_incr[4]_i_1__0_n_0 ;
  wire \axaddr_incr[5]_i_1__0_n_0 ;
  wire \axaddr_incr[6]_i_1__0_n_0 ;
  wire \axaddr_incr[7]_i_1__0_n_0 ;
  wire \axaddr_incr[8]_i_1__0_n_0 ;
  wire \axaddr_incr[9]_i_1__0_n_0 ;
  wire [0:0]\axaddr_incr_reg[0]_0 ;
  wire [0:0]\axaddr_incr_reg[11]_0 ;
  wire [3:0]\axaddr_incr_reg[11]_1 ;
  wire \axaddr_incr_reg[11]_i_4__0_n_1 ;
  wire \axaddr_incr_reg[11]_i_4__0_n_2 ;
  wire \axaddr_incr_reg[11]_i_4__0_n_3 ;
  wire \axaddr_incr_reg[11]_i_4__0_n_4 ;
  wire \axaddr_incr_reg[11]_i_4__0_n_5 ;
  wire \axaddr_incr_reg[11]_i_4__0_n_6 ;
  wire \axaddr_incr_reg[11]_i_4__0_n_7 ;
  wire [3:0]\axaddr_incr_reg[3]_0 ;
  wire \axaddr_incr_reg[3]_i_3__0_n_0 ;
  wire \axaddr_incr_reg[3]_i_3__0_n_1 ;
  wire \axaddr_incr_reg[3]_i_3__0_n_2 ;
  wire \axaddr_incr_reg[3]_i_3__0_n_3 ;
  wire \axaddr_incr_reg[3]_i_3__0_n_4 ;
  wire \axaddr_incr_reg[3]_i_3__0_n_5 ;
  wire \axaddr_incr_reg[3]_i_3__0_n_6 ;
  wire \axaddr_incr_reg[3]_i_3__0_n_7 ;
  wire [3:0]\axaddr_incr_reg[7]_0 ;
  wire \axaddr_incr_reg[7]_i_3__0_n_0 ;
  wire \axaddr_incr_reg[7]_i_3__0_n_1 ;
  wire \axaddr_incr_reg[7]_i_3__0_n_2 ;
  wire \axaddr_incr_reg[7]_i_3__0_n_3 ;
  wire \axaddr_incr_reg[7]_i_3__0_n_4 ;
  wire \axaddr_incr_reg[7]_i_3__0_n_5 ;
  wire \axaddr_incr_reg[7]_i_3__0_n_6 ;
  wire \axaddr_incr_reg[7]_i_3__0_n_7 ;
  wire \axaddr_incr_reg_n_0_[0] ;
  wire \axaddr_incr_reg_n_0_[10] ;
  wire \axaddr_incr_reg_n_0_[1] ;
  wire \axaddr_incr_reg_n_0_[2] ;
  wire \axaddr_incr_reg_n_0_[3] ;
  wire \axaddr_incr_reg_n_0_[4] ;
  wire \axaddr_incr_reg_n_0_[5] ;
  wire \axaddr_incr_reg_n_0_[6] ;
  wire \axaddr_incr_reg_n_0_[7] ;
  wire \axaddr_incr_reg_n_0_[8] ;
  wire \axaddr_incr_reg_n_0_[9] ;
  wire \axlen_cnt[0]_i_1__1_n_0 ;
  wire \axlen_cnt[1]_i_1__2_n_0 ;
  wire \axlen_cnt[2]_i_1__2_n_0 ;
  wire \axlen_cnt[3]_i_1__1_n_0 ;
  wire \axlen_cnt[4]_i_1__2_n_0 ;
  wire \axlen_cnt[4]_i_2__0_n_0 ;
  wire \axlen_cnt[5]_i_1__0_n_0 ;
  wire \axlen_cnt[5]_i_2__0_n_0 ;
  wire \axlen_cnt[6]_i_1__0_n_0 ;
  wire \axlen_cnt[7]_i_1__0_n_0 ;
  wire \axlen_cnt[8]_i_2__0_n_0 ;
  wire \axlen_cnt[8]_i_3__0_n_0 ;
  wire [0:0]\axlen_cnt_reg[0]_0 ;
  wire \axlen_cnt_reg[3]_0 ;
  wire [1:0]\axlen_cnt_reg[5]_0 ;
  wire \axlen_cnt_reg_n_0_[0] ;
  wire \axlen_cnt_reg_n_0_[1] ;
  wire \axlen_cnt_reg_n_0_[2] ;
  wire \axlen_cnt_reg_n_0_[3] ;
  wire \axlen_cnt_reg_n_0_[4] ;
  wire \axlen_cnt_reg_n_0_[5] ;
  wire \axlen_cnt_reg_n_0_[6] ;
  wire \axlen_cnt_reg_n_0_[7] ;
  wire \axlen_cnt_reg_n_0_[8] ;
  wire incr_next_pending;
  wire [10:0]m_axi_araddr;
  wire \m_axi_araddr[0]_0 ;
  wire \m_axi_araddr[0]_1 ;
  wire [10:0]\m_axi_araddr[10] ;
  wire m_axi_araddr_0_sn_1;
  wire m_axi_arready;
  wire \m_payload_i_reg[39] ;
  wire next_pending_r_i_3__1_n_0;
  wire next_pending_r_i_4_n_0;
  wire next_pending_r_i_6__0_n_0;
  wire next_pending_r_i_7__0_n_0;
  wire next_pending_r_i_8__0_n_0;
  wire next_pending_r_reg_0;
  wire next_pending_r_reg_n_0;
  wire r_push;
  wire sel_first_i;
  wire sel_first_reg_0;
  wire sel_first_reg_1;
  wire sel_first_reg_2;
  wire si_rs_arvalid;
  wire wrap_next_pending;
  wire [3:3]\NLW_axaddr_incr_reg[11]_i_4__0_CO_UNCONNECTED ;

  assign m_axi_araddr_0_sn_1 = m_axi_araddr_0_sp_1;
  (* SOFT_HLUTNM = "soft_lutpair6" *) 
  LUT3 #(
    .INIT(8'hB8)) 
    \axaddr_incr[0]_i_1__0 
       (.I0(\axaddr_incr_reg[3]_0 [0]),
        .I1(sel_first_reg_0),
        .I2(\axaddr_incr_reg[3]_i_3__0_n_7 ),
        .O(\axaddr_incr[0]_i_1__0_n_0 ));
  (* SOFT_HLUTNM = "soft_lutpair8" *) 
  LUT3 #(
    .INIT(8'hB8)) 
    \axaddr_incr[10]_i_1__0 
       (.I0(\axaddr_incr_reg[11]_1 [2]),
        .I1(sel_first_reg_0),
        .I2(\axaddr_incr_reg[11]_i_4__0_n_5 ),
        .O(\axaddr_incr[10]_i_1__0_n_0 ));
  (* SOFT_HLUTNM = "soft_lutpair7" *) 
  LUT3 #(
    .INIT(8'hB8)) 
    \axaddr_incr[11]_i_2__0 
       (.I0(\axaddr_incr_reg[11]_1 [3]),
        .I1(sel_first_reg_0),
        .I2(\axaddr_incr_reg[11]_i_4__0_n_4 ),
        .O(\axaddr_incr[11]_i_2__0_n_0 ));
  (* SOFT_HLUTNM = "soft_lutpair7" *) 
  LUT3 #(
    .INIT(8'hB8)) 
    \axaddr_incr[1]_i_1__0 
       (.I0(\axaddr_incr_reg[3]_0 [1]),
        .I1(sel_first_reg_0),
        .I2(\axaddr_incr_reg[3]_i_3__0_n_6 ),
        .O(\axaddr_incr[1]_i_1__0_n_0 ));
  (* SOFT_HLUTNM = "soft_lutpair11" *) 
  LUT3 #(
    .INIT(8'hB8)) 
    \axaddr_incr[2]_i_1__0 
       (.I0(\axaddr_incr_reg[3]_0 [2]),
        .I1(sel_first_reg_0),
        .I2(\axaddr_incr_reg[3]_i_3__0_n_5 ),
        .O(\axaddr_incr[2]_i_1__0_n_0 ));
  LUT6 #(
    .INIT(64'h060A0A0A0A0A0A0A)) 
    \axaddr_incr[3]_i_10 
       (.I0(Q[1]),
        .I1(Q[11]),
        .I2(Q[12]),
        .I3(m_axi_arready),
        .I4(\axlen_cnt_reg[5]_0 [1]),
        .I5(\axlen_cnt_reg[5]_0 [0]),
        .O(S[1]));
  LUT6 #(
    .INIT(64'h0102020202020202)) 
    \axaddr_incr[3]_i_11 
       (.I0(Q[0]),
        .I1(Q[11]),
        .I2(Q[12]),
        .I3(m_axi_arready),
        .I4(\axlen_cnt_reg[5]_0 [1]),
        .I5(\axlen_cnt_reg[5]_0 [0]),
        .O(S[0]));
  LUT3 #(
    .INIT(8'h6A)) 
    \axaddr_incr[3]_i_12 
       (.I0(\axaddr_incr_reg_n_0_[3] ),
        .I1(Q[12]),
        .I2(Q[11]),
        .O(\axaddr_incr[3]_i_12_n_0 ));
  LUT3 #(
    .INIT(8'h9A)) 
    \axaddr_incr[3]_i_13 
       (.I0(\axaddr_incr_reg_n_0_[2] ),
        .I1(Q[11]),
        .I2(Q[12]),
        .O(\axaddr_incr[3]_i_13_n_0 ));
  LUT3 #(
    .INIT(8'h9A)) 
    \axaddr_incr[3]_i_14 
       (.I0(\axaddr_incr_reg_n_0_[1] ),
        .I1(Q[12]),
        .I2(Q[11]),
        .O(\axaddr_incr[3]_i_14_n_0 ));
  LUT3 #(
    .INIT(8'hA9)) 
    \axaddr_incr[3]_i_15 
       (.I0(\axaddr_incr_reg_n_0_[0] ),
        .I1(Q[12]),
        .I2(Q[11]),
        .O(\axaddr_incr[3]_i_15_n_0 ));
  (* SOFT_HLUTNM = "soft_lutpair9" *) 
  LUT3 #(
    .INIT(8'hB8)) 
    \axaddr_incr[3]_i_1__0 
       (.I0(\axaddr_incr_reg[3]_0 [3]),
        .I1(sel_first_reg_0),
        .I2(\axaddr_incr_reg[3]_i_3__0_n_4 ),
        .O(\axaddr_incr[3]_i_1__0_n_0 ));
  LUT6 #(
    .INIT(64'h6AAAAAAAAAAAAAAA)) 
    \axaddr_incr[3]_i_8 
       (.I0(Q[3]),
        .I1(Q[11]),
        .I2(Q[12]),
        .I3(m_axi_arready),
        .I4(\axlen_cnt_reg[5]_0 [1]),
        .I5(\axlen_cnt_reg[5]_0 [0]),
        .O(S[3]));
  LUT6 #(
    .INIT(64'h262A2A2A2A2A2A2A)) 
    \axaddr_incr[3]_i_9 
       (.I0(Q[2]),
        .I1(Q[12]),
        .I2(Q[11]),
        .I3(m_axi_arready),
        .I4(\axlen_cnt_reg[5]_0 [1]),
        .I5(\axlen_cnt_reg[5]_0 [0]),
        .O(S[2]));
  (* SOFT_HLUTNM = "soft_lutpair8" *) 
  LUT3 #(
    .INIT(8'hB8)) 
    \axaddr_incr[4]_i_1__0 
       (.I0(\axaddr_incr_reg[7]_0 [0]),
        .I1(sel_first_reg_0),
        .I2(\axaddr_incr_reg[7]_i_3__0_n_7 ),
        .O(\axaddr_incr[4]_i_1__0_n_0 ));
  (* SOFT_HLUTNM = "soft_lutpair10" *) 
  LUT3 #(
    .INIT(8'hB8)) 
    \axaddr_incr[5]_i_1__0 
       (.I0(\axaddr_incr_reg[7]_0 [1]),
        .I1(sel_first_reg_0),
        .I2(\axaddr_incr_reg[7]_i_3__0_n_6 ),
        .O(\axaddr_incr[5]_i_1__0_n_0 ));
  (* SOFT_HLUTNM = "soft_lutpair10" *) 
  LUT3 #(
    .INIT(8'hB8)) 
    \axaddr_incr[6]_i_1__0 
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
       (.I0(\m_axi_araddr[10] [9]),
        .I1(m_axi_araddr_0_sn_1),
        .I2(\m_axi_araddr[0]_0 ),
        .I3(\axaddr_incr_reg_n_0_[9] ),
        .I4(Q[9]),
        .I5(sel_first_reg_1),
        .O(m_axi_araddr[9]));
  LUT6 #(
    .INIT(64'hFF888888B8B8B8B8)) 
    next_pending_r_i_1__2
       (.I0(next_pending_r_reg_0),
        .I1(E),
        .I2(next_pending_r_reg_n_0),
        .I3(next_pending_r_i_3__1_n_0),
        .I4(next_pending_r_i_4_n_0),
        .I5(r_push),
        .O(incr_next_pending));
  LUT6 #(
    .INIT(64'hFFFFFFFFFFFFFEEF)) 
    next_pending_r_i_3__1
       (.I0(next_pending_r_i_6__0_n_0),
        .I1(\axlen_cnt_reg_n_0_[7] ),
        .I2(\axlen_cnt[8]_i_3__0_n_0 ),
        .I3(\axlen_cnt_reg_n_0_[6] ),
        .I4(\axlen_cnt_reg_n_0_[8] ),
        .I5(next_pending_r_i_7__0_n_0),
        .O(next_pending_r_i_3__1_n_0));
  LUT6 #(
    .INIT(64'h00000000FFFFFFFE)) 
    next_pending_r_i_4
       (.I0(next_pending_r_i_8__0_n_0),
        .I1(\axlen_cnt_reg_n_0_[2] ),
        .I2(\axlen_cnt_reg_n_0_[1] ),
        .I3(\axlen_cnt_reg_n_0_[4] ),
        .I4(\axlen_cnt_reg_n_0_[3] ),
        .I5(E),
        .O(next_pending_r_i_4_n_0));
  LUT6 #(
    .INIT(64'hFFFFFFFFFFFFEEEB)) 
    next_pending_r_i_6__0
       (.I0(\axlen_cnt_reg_n_0_[4] ),
        .I1(\axlen_cnt_reg_n_0_[2] ),
        .I2(\axlen_cnt_reg_n_0_[0] ),
        .I3(\axlen_cnt_reg_n_0_[1] ),
        .I4(\axlen_cnt_reg_n_0_[3] ),
        .I5(\axlen_cnt_reg_n_0_[5] ),
        .O(next_pending_r_i_6__0_n_0));
  (* SOFT_HLUTNM = "soft_lutpair5" *) 
  LUT2 #(
    .INIT(4'hB)) 
    next_pending_r_i_7__0
       (.I0(\axlen_cnt_reg_n_0_[1] ),
        .I1(\axlen_cnt_reg_n_0_[0] ),
        .O(next_pending_r_i_7__0_n_0));
  LUT4 #(
    .INIT(16'hFFFE)) 
    next_pending_r_i_8__0
       (.I0(\axlen_cnt_reg_n_0_[6] ),
        .I1(\axlen_cnt_reg_n_0_[5] ),
        .I2(\axlen_cnt_reg_n_0_[8] ),
        .I3(\axlen_cnt_reg_n_0_[7] ),
        .O(next_pending_r_i_8__0_n_0));
  FDRE next_pending_r_reg
       (.C(aclk),
        .CE(1'b1),
        .D(incr_next_pending),
        .Q(next_pending_r_reg_n_0),
        .R(1'b0));
  LUT4 #(
    .INIT(16'hBA8A)) 
    s_axburst_eq0_i_1__0
       (.I0(incr_next_pending),
        .I1(sel_first_i),
        .I2(Q[14]),
        .I3(wrap_next_pending),
        .O(\m_payload_i_reg[39] ));
  FDRE sel_first_reg
       (.C(aclk),
        .CE(1'b1),
        .D(sel_first_reg_2),
        .Q(sel_first_reg_0),
        .R(1'b0));
endmodule

module mid_project_auto_pc_0_axi_protocol_converter_v2_1_18_b2s_r_channel
   (r_full,
    m_axi_rready,
    si_rs_rvalid,
    out,
    r_push_r_reg_0,
    r_push,
    aclk,
    r_rlast,
    s_arid_r,
    m_axi_rvalid,
    si_rs_rready,
    in,
    areset_d1);
  output r_full;
  output m_axi_rready;
  output si_rs_rvalid;
  output [33:0]out;
  output [1:0]r_push_r_reg_0;
  input r_push;
  input aclk;
  input r_rlast;
  input s_arid_r;
  input m_axi_rvalid;
  input si_rs_rready;
  input [33:0]in;
  input areset_d1;

  wire a_full0;
  wire aclk;
  wire areset_d1;
  wire [33:0]in;
  wire m_axi_rready;
  wire m_axi_rvalid;
  wire [33:0]out;
  wire r_full;
  wire r_push;
  wire r_push_r;
  wire [1:0]r_push_r_reg_0;
  wire r_rlast;
  wire rd_a_full;
  wire rd_en__1;
  wire s_arid_r;
  wire si_rs_rready;
  wire si_rs_rvalid;
  wire [1:0]trans_in;
  wire transaction_fifo_0_n_1;
  wire wr_en0;

  FDRE \r_arid_r_reg[0] 
       (.C(aclk),
        .CE(1'b1),
        .D(s_arid_r),
        .Q(trans_in[1]),
        .R(1'b0));
  FDRE r_push_r_reg
       (.C(aclk),
        .CE(1'b1),
        .D(r_push),
        .Q(r_push_r),
        .R(1'b0));
  FDRE r_rlast_r_reg
       (.C(aclk),
        .CE(1'b1),
        .D(r_rlast),
        .Q(trans_in[0]),
        .R(1'b0));
  mid_project_auto_pc_0_axi_protocol_converter_v2_1_18_b2s_simple_fifo__parameterized1 rd_data_fifo_0
       (.E(transaction_fifo_0_n_1),
        .a_full0(a_full0),
        .aclk(aclk),
        .areset_d1(areset_d1),
        .in(in),
        .m_axi_rready(m_axi_rready),
        .m_axi_rvalid(m_axi_rvalid),
        .out(out),
        .rd_a_full(rd_a_full),
        .rd_en__1(rd_en__1),
        .wr_en0(wr_en0));
  mid_project_auto_pc_0_axi_protocol_converter_v2_1_18_b2s_simple_fifo__parameterized2 transaction_fifo_0
       (.E(transaction_fifo_0_n_1),
        .a_full0(a_full0),
        .aclk(aclk),
        .areset_d1(areset_d1),
        .in(trans_in),
        .r_full(r_full),
        .r_push_r(r_push_r),
        .r_push_r_reg(r_push_r_reg_0),
        .rd_a_full(rd_a_full),
        .rd_en__1(rd_en__1),
        .si_rs_rready(si_rs_rready),
        .si_rs_rvalid(si_rs_rvalid),
        .wr_en0(wr_en0));
endmodule
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
