NicholasTran/G8_SwishSwooshSwordSimulator/src/mid_demo/mid_demo.ip_user_files/bd/mid_project/ip/mid_project_auto_pc_0/mid_project_auto_pc_0_sim_netlist.vhdl

-- Copyright 1986-2018 Xilinx, Inc. All Rights Reserved.
-- --------------------------------------------------------------------------------
-- Tool Version: Vivado v.2018.3 (win64) Build 2405991 Thu Dec  6 23:38:27 MST 2018
-- Date        : Sun Mar 12 06:34:21 2023
-- Host        : TheDesktop running 64-bit major release  (build 9200)
-- Command     : write_vhdl -force -mode funcsim -rename_top mid_project_auto_pc_0 -prefix
--               mid_project_auto_pc_0_ mid_project_auto_pc_0_sim_netlist.vhdl
-- Design      : mid_project_auto_pc_0
-- Purpose     : This VHDL netlist is a functional simulation representation of the design and should not be modified or
--               synthesized. This netlist cannot be used for SDF annotated simulation.
-- Device      : xc7a100tcsg324-1
-- --------------------------------------------------------------------------------
library IEEE;
use IEEE.STD_LOGIC_1164.ALL;
library UNISIM;
use UNISIM.VCOMPONENTS.ALL;
entity mid_project_auto_pc_0_axi_protocol_converter_v2_1_18_b2s_incr_cmd is
  port (
    incr_next_pending : out STD_LOGIC;
    sel_first_reg_0 : out STD_LOGIC;
    \axaddr_incr_reg[11]_0\ : out STD_LOGIC_VECTOR ( 0 to 0 );
    m_axi_awaddr : out STD_LOGIC_VECTOR ( 10 downto 0 );
    sel_first_reg_1 : out STD_LOGIC;
    S : out STD_LOGIC_VECTOR ( 3 downto 0 );
    aclk : in STD_LOGIC;
    sel_first_reg_2 : in STD_LOGIC;
    next_pending_r_reg_0 : in STD_LOGIC;
    E : in STD_LOGIC_VECTOR ( 0 to 0 );
    \next\ : in STD_LOGIC;
    \axlen_cnt_reg[0]_0\ : in STD_LOGIC_VECTOR ( 1 downto 0 );
    si_rs_awvalid : in STD_LOGIC;
    \axlen_cnt_reg[7]_0\ : in STD_LOGIC_VECTOR ( 21 downto 0 );
    \axlen_cnt_reg[3]_0\ : in STD_LOGIC;
    axaddr_incr : in STD_LOGIC_VECTOR ( 11 downto 0 );
    Q : in STD_LOGIC_VECTOR ( 10 downto 0 );
    m_axi_awaddr_0_sp_1 : in STD_LOGIC;
    \m_axi_awaddr[0]_0\ : in STD_LOGIC;
    sel_first : in STD_LOGIC;
    \axlen_cnt_reg[0]_1\ : in STD_LOGIC_VECTOR ( 0 to 0 )
  );
end mid_project_auto_pc_0_axi_protocol_converter_v2_1_18_b2s_incr_cmd;

architecture STRUCTURE of mid_project_auto_pc_0_axi_protocol_converter_v2_1_18_b2s_incr_cmd is
  signal \axaddr_incr[11]_i_1_n_0\ : STD_LOGIC;
  signal \axaddr_incr[3]_i_12_n_0\ : STD_LOGIC;
  signal \axaddr_incr[3]_i_13_n_0\ : STD_LOGIC;
  signal \axaddr_incr[3]_i_14_n_0\ : STD_LOGIC;
  signal \axaddr_incr[3]_i_15_n_0\ : STD_LOGIC;
  signal \^axaddr_incr_reg[11]_0\ : STD_LOGIC_VECTOR ( 0 to 0 );
  signal \axaddr_incr_reg[11]_i_4_n_1\ : STD_LOGIC;
  signal \axaddr_incr_reg[11]_i_4_n_2\ : STD_LOGIC;
  signal \axaddr_incr_reg[11]_i_4_n_3\ : STD_LOGIC;
  signal \axaddr_incr_reg[11]_i_4_n_4\ : STD_LOGIC;
  signal \axaddr_incr_reg[11]_i_4_n_5\ : STD_LOGIC;
  signal \axaddr_incr_reg[11]_i_4_n_6\ : STD_LOGIC;
  signal \axaddr_incr_reg[11]_i_4_n_7\ : STD_LOGIC;
  signal \axaddr_incr_reg[3]_i_3_n_0\ : STD_LOGIC;
  signal \axaddr_incr_reg[3]_i_3_n_1\ : STD_LOGIC;
  signal \axaddr_incr_reg[3]_i_3_n_2\ : STD_LOGIC;
  signal \axaddr_incr_reg[3]_i_3_n_3\ : STD_LOGIC;
  signal \axaddr_incr_reg[3]_i_3_n_4\ : STD_LOGIC;
  signal \axaddr_incr_reg[3]_i_3_n_5\ : STD_LOGIC;
  signal \axaddr_incr_reg[3]_i_3_n_6\ : STD_LOGIC;
  signal \axaddr_incr_reg[3]_i_3_n_7\ : STD_LOGIC;
  signal \axaddr_incr_reg[7]_i_3_n_0\ : STD_LOGIC;
  signal \axaddr_incr_reg[7]_i_3_n_1\ : STD_LOGIC;
  signal \axaddr_incr_reg[7]_i_3_n_2\ : STD_LOGIC;
  signal \axaddr_incr_reg[7]_i_3_n_3\ : STD_LOGIC;
  signal \axaddr_incr_reg[7]_i_3_n_4\ : STD_LOGIC;
  signal \axaddr_incr_reg[7]_i_3_n_5\ : STD_LOGIC;
  signal \axaddr_incr_reg[7]_i_3_n_6\ : STD_LOGIC;
  signal \axaddr_incr_reg[7]_i_3_n_7\ : STD_LOGIC;
  signal \axaddr_incr_reg_n_0_[0]\ : STD_LOGIC;
  signal \axaddr_incr_reg_n_0_[10]\ : STD_LOGIC;
  signal \axaddr_incr_reg_n_0_[1]\ : STD_LOGIC;
  signal \axaddr_incr_reg_n_0_[2]\ : STD_LOGIC;
  signal \axaddr_incr_reg_n_0_[3]\ : STD_LOGIC;
  signal \axaddr_incr_reg_n_0_[4]\ : STD_LOGIC;
  signal \axaddr_incr_reg_n_0_[5]\ : STD_LOGIC;
  signal \axaddr_incr_reg_n_0_[6]\ : STD_LOGIC;
  signal \axaddr_incr_reg_n_0_[7]\ : STD_LOGIC;
  signal \axaddr_incr_reg_n_0_[8]\ : STD_LOGIC;
  signal \axaddr_incr_reg_n_0_[9]\ : STD_LOGIC;
  signal axlen_cnt : STD_LOGIC_VECTOR ( 8 downto 0 );
  signal \axlen_cnt[0]_i_1__0_n_0\ : STD_LOGIC;
  signal \axlen_cnt[1]_i_1__0_n_0\ : STD_LOGIC;
  signal \axlen_cnt[2]_i_1__0_n_0\ : STD_LOGIC;
  signal \axlen_cnt[3]_i_1__0_n_0\ : STD_LOGIC;
  signal \axlen_cnt[4]_i_1__0_n_0\ : STD_LOGIC;
  signal \axlen_cnt[4]_i_2_n_0\ : STD_LOGIC;
  signal \axlen_cnt[5]_i_1_n_0\ : STD_LOGIC;
  signal \axlen_cnt[5]_i_2_n_0\ : STD_LOGIC;
  signal \axlen_cnt[6]_i_1_n_0\ : STD_LOGIC;
  signal \axlen_cnt[7]_i_1_n_0\ : STD_LOGIC;
  signal \axlen_cnt[8]_i_2_n_0\ : STD_LOGIC;
  signal \axlen_cnt[8]_i_3_n_0\ : STD_LOGIC;
  signal \^incr_next_pending\ : STD_LOGIC;
  signal m_axi_awaddr_0_sn_1 : STD_LOGIC;
  signal next_pending_r_i_3_n_0 : STD_LOGIC;
  signal next_pending_r_i_5_n_0 : STD_LOGIC;
  signal next_pending_r_i_7_n_0 : STD_LOGIC;
  signal next_pending_r_i_8_n_0 : STD_LOGIC;
  signal next_pending_r_i_9_n_0 : STD_LOGIC;
  signal next_pending_r_reg_n_0 : STD_LOGIC;
  signal p_1_in : STD_LOGIC_VECTOR ( 11 downto 0 );
  signal \^sel_first_reg_0\ : STD_LOGIC;
  signal \^sel_first_reg_1\ : STD_LOGIC;
  signal \NLW_axaddr_incr_reg[11]_i_4_CO_UNCONNECTED\ : STD_LOGIC_VECTOR ( 3 to 3 );
  attribute SOFT_HLUTNM : string;
  attribute SOFT_HLUTNM of \axaddr_incr[0]_i_1\ : label is "soft_lutpair98";
  attribute SOFT_HLUTNM of \axaddr_incr[10]_i_1\ : label is "soft_lutpair99";
  attribute SOFT_HLUTNM of \axaddr_incr[11]_i_2\ : label is "soft_lutpair98";
  attribute SOFT_HLUTNM of \axaddr_incr[1]_i_1\ : label is "soft_lutpair99";
  attribute SOFT_HLUTNM of \axaddr_incr[2]_i_1\ : label is "soft_lutpair100";
  attribute SOFT_HLUTNM of \axaddr_incr[3]_i_1\ : label is "soft_lutpair101";
  attribute SOFT_HLUTNM of \axaddr_incr[4]_i_1\ : label is "soft_lutpair102";
  attribute SOFT_HLUTNM of \axaddr_incr[5]_i_1\ : label is "soft_lutpair101";
  attribute SOFT_HLUTNM of \axaddr_incr[6]_i_1\ : label is "soft_lutpair97";
  attribute SOFT_HLUTNM of \axaddr_incr[7]_i_1\ : label is "soft_lutpair102";
  attribute SOFT_HLUTNM of \axaddr_incr[8]_i_1\ : label is "soft_lutpair100";
  attribute SOFT_HLUTNM of \axaddr_incr[9]_i_1\ : label is "soft_lutpair97";
  attribute SOFT_HLUTNM of \axlen_cnt[1]_i_1__0\ : label is "soft_lutpair96";
  attribute SOFT_HLUTNM of next_pending_r_i_8 : label is "soft_lutpair96";
begin
  \axaddr_incr_reg[11]_0\(0) <= \^axaddr_incr_reg[11]_0\(0);
  incr_next_pending <= \^incr_next_pending\;
  m_axi_awaddr_0_sn_1 <= m_axi_awaddr_0_sp_1;
  sel_first_reg_0 <= \^sel_first_reg_0\;
  sel_first_reg_1 <= \^sel_first_reg_1\;
\axaddr_incr[0]_i_1\: unisim.vcomponents.LUT3
    generic map(
      INIT => X"B8"
    )
        port map (
      I0 => axaddr_incr(0),
      I1 => \^sel_first_reg_0\,
      I2 => \axaddr_incr_reg[3]_i_3_n_7\,
      O => p_1_in(0)
    );
\axaddr_incr[10]_i_1\: unisim.vcomponents.LUT3
    generic map(
      INIT => X"B8"
    )
        port map (
      I0 => axaddr_incr(10),
      I1 => \^sel_first_reg_0\,
      I2 => \axaddr_incr_reg[11]_i_4_n_5\,
      O => p_1_in(10)
    );
\axaddr_incr[11]_i_1\: unisim.vcomponents.LUT2
    generic map(
      INIT => X"E"
    )
        port map (
      I0 => \^sel_first_reg_0\,
      I1 => \next\,
      O => \axaddr_incr[11]_i_1_n_0\
    );
\axaddr_incr[11]_i_2\: unisim.vcomponents.LUT3
    generic map(
      INIT => X"B8"
    )
        port map (
      I0 => axaddr_incr(11),
      I1 => \^sel_first_reg_0\,
      I2 => \axaddr_incr_reg[11]_i_4_n_4\,
      O => p_1_in(11)
    );
\axaddr_incr[1]_i_1\: unisim.vcomponents.LUT3
    generic map(
      INIT => X"B8"
    )
        port map (
      I0 => axaddr_incr(1),
      I1 => \^sel_first_reg_0\,
      I2 => \axaddr_incr_reg[3]_i_3_n_6\,
      O => p_1_in(1)
    );
\axaddr_incr[2]_i_1\: unisim.vcomponents.LUT3
    generic map(
      INIT => X"B8"
    )
        port map (
      I0 => axaddr_incr(2),
      I1 => \^sel_first_reg_0\,
      I2 => \axaddr_incr_reg[3]_i_3_n_5\,
      O => p_1_in(2)
    );
\axaddr_incr[3]_i_1\: unisim.vcomponents.LUT3
    generic map(
      INIT => X"B8"
    )
        port map (
      I0 => axaddr_incr(3),
      I1 => \^sel_first_reg_0\,
      I2 => \axaddr_incr_reg[3]_i_3_n_4\,
      O => p_1_in(3)
    );
\axaddr_incr[3]_i_10\: unisim.vcomponents.LUT4
    generic map(
      INIT => X"060A"
    )
        port map (
      I0 => \axlen_cnt_reg[7]_0\(1),
      I1 => \axlen_cnt_reg[7]_0\(11),
      I2 => \axlen_cnt_reg[7]_0\(12),
      I3 => \next\,
      O => S(1)
    );
\axaddr_incr[3]_i_11\: unisim.vcomponents.LUT4
    generic map(
      INIT => X"0102"
    )
        port map (
      I0 => \axlen_cnt_reg[7]_0\(0),
      I1 => \axlen_cnt_reg[7]_0\(11),
      I2 => \axlen_cnt_reg[7]_0\(12),
      I3 => \next\,
      O => S(0)
    );
\axaddr_incr[3]_i_12\: unisim.vcomponents.LUT3
    generic map(
      INIT => X"6A"
    )
        port map (
      I0 => \axaddr_incr_reg_n_0_[3]\,
      I1 => \axlen_cnt_reg[7]_0\(12),
      I2 => \axlen_cnt_reg[7]_0\(11),
      O => \axaddr_incr[3]_i_12_n_0\
    );
\axaddr_incr[3]_i_13\: unisim.vcomponents.LUT3
    generic map(
      INIT => X"9A"
    )
        port map (
      I0 => \axaddr_incr_reg_n_0_[2]\,
      I1 => \axlen_cnt_reg[7]_0\(11),
      I2 => \axlen_cnt_reg[7]_0\(12),
      O => \axaddr_incr[3]_i_13_n_0\
    );
\axaddr_incr[3]_i_14\: unisim.vcomponents.LUT3
    generic map(
      INIT => X"9A"
    )
        port map (
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
      O => m_axi_awaddr(7)
    );
\m_axi_awaddr[8]_INST_0\: unisim.vcomponents.LUT6
    generic map(
      INIT => X"FFFFF888F888F888"
    )
        port map (
      I0 => Q(8),
      I1 => m_axi_awaddr_0_sn_1,
      I2 => \m_axi_awaddr[0]_0\,
      I3 => \axaddr_incr_reg_n_0_[8]\,
      I4 => \axlen_cnt_reg[7]_0\(8),
      I5 => \^sel_first_reg_1\,
      O => m_axi_awaddr(8)
    );
\m_axi_awaddr[9]_INST_0\: unisim.vcomponents.LUT6
    generic map(
      INIT => X"FFFFF888F888F888"
    )
        port map (
      I0 => Q(9),
      I1 => m_axi_awaddr_0_sn_1,
      I2 => \m_axi_awaddr[0]_0\,
      I3 => \axaddr_incr_reg_n_0_[9]\,
      I4 => \axlen_cnt_reg[7]_0\(9),
      I5 => \^sel_first_reg_1\,
      O => m_axi_awaddr(9)
    );
\next_pending_r_i_1__0\: unisim.vcomponents.LUT6
    generic map(
      INIT => X"FF88B8B88888B8B8"
    )
        port map (
      I0 => next_pending_r_reg_0,
      I1 => E(0),
      I2 => next_pending_r_reg_n_0,
      I3 => next_pending_r_i_3_n_0,
      I4 => \next\,
      I5 => next_pending_r_i_5_n_0,
      O => \^incr_next_pending\
    );
next_pending_r_i_3: unisim.vcomponents.LUT6
    generic map(
      INIT => X"FFFFFFFFFFFFFEEF"
    )
        port map (
      I0 => next_pending_r_i_7_n_0,
      I1 => axlen_cnt(7),
      I2 => \axlen_cnt[8]_i_3_n_0\,
      I3 => axlen_cnt(6),
      I4 => axlen_cnt(8),
      I5 => next_pending_r_i_8_n_0,
      O => next_pending_r_i_3_n_0
    );
next_pending_r_i_5: unisim.vcomponents.LUT6
    generic map(
      INIT => X"00000000FFFFFFFE"
    )
        port map (
      I0 => next_pending_r_i_9_n_0,
      I1 => axlen_cnt(2),
      I2 => axlen_cnt(1),
      I3 => axlen_cnt(4),
      I4 => axlen_cnt(3),
      I5 => E(0),
      O => next_pending_r_i_5_n_0
    );
next_pending_r_i_7: unisim.vcomponents.LUT6
    generic map(
      INIT => X"FFFFFFFFFFFFEEEB"
    )
        port map (
      I0 => axlen_cnt(4),
      I1 => axlen_cnt(2),
      I2 => axlen_cnt(0),
      I3 => axlen_cnt(1),
      I4 => axlen_cnt(3),
      I5 => axlen_cnt(5),
      O => next_pending_r_i_7_n_0
    );
next_pending_r_i_8: unisim.vcomponents.LUT2
    generic map(
      INIT => X"B"
    )
        port map (
      I0 => axlen_cnt(1),
      I1 => axlen_cnt(0),
      O => next_pending_r_i_8_n_0
    );
next_pending_r_i_9: unisim.vcomponents.LUT4
    generic map(
      INIT => X"FFFE"
    )
        port map (
      I0 => axlen_cnt(6),
      I1 => axlen_cnt(5),
      I2 => axlen_cnt(8),
      I3 => axlen_cnt(7),
      O => next_pending_r_i_9_n_0
    );
next_pending_r_reg: unisim.vcomponents.FDRE
     port map (
      C => aclk,
      CE => '1',
      D => \^incr_next_pending\,
      Q => next_pending_r_reg_n_0,
      R => '0'
    );
sel_first_reg: unisim.vcomponents.FDRE
     port map (
      C => aclk,
      CE => '1',
      D => sel_first_reg_2,
      Q => \^sel_first_reg_0\,
      R => '0'
    );
end STRUCTURE;
library IEEE;
use IEEE.STD_LOGIC_1164.ALL;
library UNISIM;
use UNISIM.VCOMPONENTS.ALL;
entity mid_project_auto_pc_0_axi_protocol_converter_v2_1_18_b2s_incr_cmd_2 is
  port (
    incr_next_pending : out STD_LOGIC;
    sel_first_reg_0 : out STD_LOGIC;
    \axaddr_incr_reg[11]_0\ : out STD_LOGIC_VECTOR ( 0 to 0 );
    \m_payload_i_reg[39]\ : out STD_LOGIC;
    m_axi_araddr : out STD_LOGIC_VECTOR ( 10 downto 0 );
    sel_first_reg_1 : out STD_LOGIC;
    S : out STD_LOGIC_VECTOR ( 3 downto 0 );
    aclk : in STD_LOGIC;
    sel_first_reg_2 : in STD_LOGIC;
    sel_first_i : in STD_LOGIC;
    Q : in STD_LOGIC_VECTOR ( 21 downto 0 );
    wrap_next_pending : in STD_LOGIC;
    next_pending_r_reg_0 : in STD_LOGIC;
    E : in STD_LOGIC_VECTOR ( 0 to 0 );
    r_push : in STD_LOGIC;
    \axlen_cnt_reg[3]_0\ : in STD_LOGIC;
    \axaddr_incr_reg[11]_1\ : in STD_LOGIC_VECTOR ( 3 downto 0 );
    \axaddr_incr_reg[7]_0\ : in STD_LOGIC_VECTOR ( 3 downto 0 );
    \axaddr_incr_reg[3]_0\ : in STD_LOGIC_VECTOR ( 3 downto 0 );
    \m_axi_araddr[10]\ : in STD_LOGIC_VECTOR ( 10 downto 0 );
    m_axi_araddr_0_sp_1 : in STD_LOGIC;
    \m_axi_araddr[0]_0\ : in STD_LOGIC;
    \m_axi_araddr[0]_1\ : in STD_LOGIC;
    \axlen_cnt_reg[5]_0\ : in STD_LOGIC_VECTOR ( 1 downto 0 );
    si_rs_arvalid : in STD_LOGIC;
    \axlen_cnt_reg[0]_0\ : in STD_LOGIC_VECTOR ( 0 to 0 );
    \axaddr_incr_reg[0]_0\ : in STD_LOGIC_VECTOR ( 0 to 0 );
    m_axi_arready : in STD_LOGIC
  );
  attribute ORIG_REF_NAME : string;
  attribute ORIG_REF_NAME of mid_project_auto_pc_0_axi_protocol_converter_v2_1_18_b2s_incr_cmd_2 : entity is "axi_protocol_converter_v2_1_18_b2s_incr_cmd";
end mid_project_auto_pc_0_axi_protocol_converter_v2_1_18_b2s_incr_cmd_2;

architecture STRUCTURE of mid_project_auto_pc_0_axi_protocol_converter_v2_1_18_b2s_incr_cmd_2 is
  signal \axaddr_incr[0]_i_1__0_n_0\ : STD_LOGIC;
  signal \axaddr_incr[10]_i_1__0_n_0\ : STD_LOGIC;
  signal \axaddr_incr[11]_i_2__0_n_0\ : STD_LOGIC;
  signal \axaddr_incr[1]_i_1__0_n_0\ : STD_LOGIC;
  signal \axaddr_incr[2]_i_1__0_n_0\ : STD_LOGIC;
  signal \axaddr_incr[3]_i_12_n_0\ : STD_LOGIC;
  signal \axaddr_incr[3]_i_13_n_0\ : STD_LOGIC;
  signal \axaddr_incr[3]_i_14_n_0\ : STD_LOGIC;
  signal \axaddr_incr[3]_i_15_n_0\ : STD_LOGIC;
  signal \axaddr_incr[3]_i_1__0_n_0\ : STD_LOGIC;
  signal \axaddr_incr[4]_i_1__0_n_0\ : STD_LOGIC;
  signal \axaddr_incr[5]_i_1__0_n_0\ : STD_LOGIC;
  signal \axaddr_incr[6]_i_1__0_n_0\ : STD_LOGIC;
  signal \axaddr_incr[7]_i_1__0_n_0\ : STD_LOGIC;
  signal \axaddr_incr[8]_i_1__0_n_0\ : STD_LOGIC;
  signal \axaddr_incr[9]_i_1__0_n_0\ : STD_LOGIC;
  signal \^axaddr_incr_reg[11]_0\ : STD_LOGIC_VECTOR ( 0 to 0 );
  signal \axaddr_incr_reg[11]_i_4__0_n_1\ : STD_LOGIC;
  signal \axaddr_incr_reg[11]_i_4__0_n_2\ : STD_LOGIC;
  signal \axaddr_incr_reg[11]_i_4__0_n_3\ : STD_LOGIC;
  signal \axaddr_incr_reg[11]_i_4__0_n_4\ : STD_LOGIC;
  signal \axaddr_incr_reg[11]_i_4__0_n_5\ : STD_LOGIC;
  signal \axaddr_incr_reg[11]_i_4__0_n_6\ : STD_LOGIC;
  signal \axaddr_incr_reg[11]_i_4__0_n_7\ : STD_LOGIC;
  signal \axaddr_incr_reg[3]_i_3__0_n_0\ : STD_LOGIC;
  signal \axaddr_incr_reg[3]_i_3__0_n_1\ : STD_LOGIC;
  signal \axaddr_incr_reg[3]_i_3__0_n_2\ : STD_LOGIC;
  signal \axaddr_incr_reg[3]_i_3__0_n_3\ : STD_LOGIC;
  signal \axaddr_incr_reg[3]_i_3__0_n_4\ : STD_LOGIC;
  signal \axaddr_incr_reg[3]_i_3__0_n_5\ : STD_LOGIC;
  signal \axaddr_incr_reg[3]_i_3__0_n_6\ : STD_LOGIC;
  signal \axaddr_incr_reg[3]_i_3__0_n_7\ : STD_LOGIC;
  signal \axaddr_incr_reg[7]_i_3__0_n_0\ : STD_LOGIC;
  signal \axaddr_incr_reg[7]_i_3__0_n_1\ : STD_LOGIC;
  signal \axaddr_incr_reg[7]_i_3__0_n_2\ : STD_LOGIC;
  signal \axaddr_incr_reg[7]_i_3__0_n_3\ : STD_LOGIC;
  signal \axaddr_incr_reg[7]_i_3__0_n_4\ : STD_LOGIC;
  signal \axaddr_incr_reg[7]_i_3__0_n_5\ : STD_LOGIC;
  signal \axaddr_incr_reg[7]_i_3__0_n_6\ : STD_LOGIC;
  signal \axaddr_incr_reg[7]_i_3__0_n_7\ : STD_LOGIC;
  signal \axaddr_incr_reg_n_0_[0]\ : STD_LOGIC;
  signal \axaddr_incr_reg_n_0_[10]\ : STD_LOGIC;
  signal \axaddr_incr_reg_n_0_[1]\ : STD_LOGIC;
  signal \axaddr_incr_reg_n_0_[2]\ : STD_LOGIC;
  signal \axaddr_incr_reg_n_0_[3]\ : STD_LOGIC;
  signal \axaddr_incr_reg_n_0_[4]\ : STD_LOGIC;
  signal \axaddr_incr_reg_n_0_[5]\ : STD_LOGIC;
  signal \axaddr_incr_reg_n_0_[6]\ : STD_LOGIC;
  signal \axaddr_incr_reg_n_0_[7]\ : STD_LOGIC;
  signal \axaddr_incr_reg_n_0_[8]\ : STD_LOGIC;
  signal \axaddr_incr_reg_n_0_[9]\ : STD_LOGIC;
  signal \axlen_cnt[0]_i_1__1_n_0\ : STD_LOGIC;
  signal \axlen_cnt[1]_i_1__2_n_0\ : STD_LOGIC;
  signal \axlen_cnt[2]_i_1__2_n_0\ : STD_LOGIC;
  signal \axlen_cnt[3]_i_1__1_n_0\ : STD_LOGIC;
  signal \axlen_cnt[4]_i_1__2_n_0\ : STD_LOGIC;
  signal \axlen_cnt[4]_i_2__0_n_0\ : STD_LOGIC;
  signal \axlen_cnt[5]_i_1__0_n_0\ : STD_LOGIC;
  signal \axlen_cnt[5]_i_2__0_n_0\ : STD_LOGIC;
  signal \axlen_cnt[6]_i_1__0_n_0\ : STD_LOGIC;
  signal \axlen_cnt[7]_i_1__0_n_0\ : STD_LOGIC;
  signal \axlen_cnt[8]_i_2__0_n_0\ : STD_LOGIC;
  signal \axlen_cnt[8]_i_3__0_n_0\ : STD_LOGIC;
  signal \axlen_cnt_reg_n_0_[0]\ : STD_LOGIC;
  signal \axlen_cnt_reg_n_0_[1]\ : STD_LOGIC;
  signal \axlen_cnt_reg_n_0_[2]\ : STD_LOGIC;
  signal \axlen_cnt_reg_n_0_[3]\ : STD_LOGIC;
  signal \axlen_cnt_reg_n_0_[4]\ : STD_LOGIC;
  signal \axlen_cnt_reg_n_0_[5]\ : STD_LOGIC;
  signal \axlen_cnt_reg_n_0_[6]\ : STD_LOGIC;
  signal \axlen_cnt_reg_n_0_[7]\ : STD_LOGIC;
  signal \axlen_cnt_reg_n_0_[8]\ : STD_LOGIC;
  signal \^incr_next_pending\ : STD_LOGIC;
  signal m_axi_araddr_0_sn_1 : STD_LOGIC;
  signal \next_pending_r_i_3__1_n_0\ : STD_LOGIC;
  signal next_pending_r_i_4_n_0 : STD_LOGIC;
  signal \next_pending_r_i_6__0_n_0\ : STD_LOGIC;
  signal \next_pending_r_i_7__0_n_0\ : STD_LOGIC;
  signal \next_pending_r_i_8__0_n_0\ : STD_LOGIC;
  signal next_pending_r_reg_n_0 : STD_LOGIC;
  signal \^sel_first_reg_0\ : STD_LOGIC;
  signal \^sel_first_reg_1\ : STD_LOGIC;
  signal \NLW_axaddr_incr_reg[11]_i_4__0_CO_UNCONNECTED\ : STD_LOGIC_VECTOR ( 3 to 3 );
  attribute SOFT_HLUTNM : string;
  attribute SOFT_HLUTNM of \axaddr_incr[0]_i_1__0\ : label is "soft_lutpair6";
  attribute SOFT_HLUTNM of \axaddr_incr[10]_i_1__0\ : label is "soft_lutpair8";
  attribute SOFT_HLUTNM of \axaddr_incr[11]_i_2__0\ : label is "soft_lutpair7";
  attribute SOFT_HLUTNM of \axaddr_incr[1]_i_1__0\ : label is "soft_lutpair7";
  attribute SOFT_HLUTNM of \axaddr_incr[2]_i_1__0\ : label is "soft_lutpair11";
  attribute SOFT_HLUTNM of \axaddr_incr[3]_i_1__0\ : label is "soft_lutpair9";
  attribute SOFT_HLUTNM of \axaddr_incr[4]_i_1__0\ : label is "soft_lutpair8";
  attribute SOFT_HLUTNM of \axaddr_incr[5]_i_1__0\ : label is "soft_lutpair10";
  attribute SOFT_HLUTNM of \axaddr_incr[6]_i_1__0\ : label is "soft_lutpair10";
  attribute SOFT_HLUTNM of \axaddr_incr[7]_i_1__0\ : label is "soft_lutpair11";
  attribute SOFT_HLUTNM of \axaddr_incr[8]_i_1__0\ : label is "soft_lutpair9";
  attribute SOFT_HLUTNM of \axaddr_incr[9]_i_1__0\ : label is "soft_lutpair6";
  attribute SOFT_HLUTNM of \axlen_cnt[1]_i_1__2\ : label is "soft_lutpair5";
  attribute SOFT_HLUTNM of \next_pending_r_i_7__0\ : label is "soft_lutpair5";
begin
  \axaddr_incr_reg[11]_0\(0) <= \^axaddr_incr_reg[11]_0\(0);
  incr_next_pending <= \^incr_next_pending\;
  m_axi_araddr_0_sn_1 <= m_axi_araddr_0_sp_1;
  sel_first_reg_0 <= \^sel_first_reg_0\;
  sel_first_reg_1 <= \^sel_first_reg_1\;
\axaddr_incr[0]_i_1__0\: unisim.vcomponents.LUT3
    generic map(
      INIT => X"B8"
    )
        port map (
      I0 => \axaddr_incr_reg[3]_0\(0),
      I1 => \^sel_first_reg_0\,
      I2 => \axaddr_incr_reg[3]_i_3__0_n_7\,
      O => \axaddr_incr[0]_i_1__0_n_0\
    );
\axaddr_incr[10]_i_1__0\: unisim.vcomponents.LUT3
    generic map(
      INIT => X"B8"
    )
        port map (
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
    );
\axaddr_incr[7]_i_1__0\: unisim.vcomponents.LUT3
    generic map(
      INIT => X"B8"
    )
        port map (
      I0 => \axaddr_incr_reg[7]_0\(3),
      I1 => \^sel_first_reg_0\,
      I2 => \axaddr_incr_reg[7]_i_3__0_n_4\,
      O => \axaddr_incr[7]_i_1__0_n_0\
    );
\axaddr_incr[8]_i_1__0\: unisim.vcomponents.LUT3
    generic map(
      INIT => X"B8"
    )
        port map (
      I0 => \axaddr_incr_reg[11]_1\(0),
      I1 => \^sel_first_reg_0\,
      I2 => \axaddr_incr_reg[11]_i_4__0_n_7\,
      O => \axaddr_incr[8]_i_1__0_n_0\
    );
\axaddr_incr[9]_i_1__0\: unisim.vcomponents.LUT3
    generic map(
      INIT => X"B8"
    )
        port map (
      I0 => \axaddr_incr_reg[11]_1\(1),
      I1 => \^sel_first_reg_0\,
      I2 => \axaddr_incr_reg[11]_i_4__0_n_6\,
      O => \axaddr_incr[9]_i_1__0_n_0\
    );
\axaddr_incr_reg[0]\: unisim.vcomponents.FDRE
     port map (
      C => aclk,
      CE => \axaddr_incr_reg[0]_0\(0),
      D => \axaddr_incr[0]_i_1__0_n_0\,
      Q => \axaddr_incr_reg_n_0_[0]\,
      R => '0'
    );
\axaddr_incr_reg[10]\: unisim.vcomponents.FDRE
     port map (
      C => aclk,
      CE => \axaddr_incr_reg[0]_0\(0),
      D => \axaddr_incr[10]_i_1__0_n_0\,
      Q => \axaddr_incr_reg_n_0_[10]\,
      R => '0'
    );
\axaddr_incr_reg[11]\: unisim.vcomponents.FDRE
     port map (
      C => aclk,
      CE => \axaddr_incr_reg[0]_0\(0),
      D => \axaddr_incr[11]_i_2__0_n_0\,
      Q => \^axaddr_incr_reg[11]_0\(0),
      R => '0'
    );
\axaddr_incr_reg[11]_i_4__0\: unisim.vcomponents.CARRY4
     port map (
      CI => \axaddr_incr_reg[7]_i_3__0_n_0\,
      CO(3) => \NLW_axaddr_incr_reg[11]_i_4__0_CO_UNCONNECTED\(3),
      CO(2) => \axaddr_incr_reg[11]_i_4__0_n_1\,
      CO(1) => \axaddr_incr_reg[11]_i_4__0_n_2\,
      CO(0) => \axaddr_incr_reg[11]_i_4__0_n_3\,
      CYINIT => '0',
      DI(3 downto 0) => B"0000",
      O(3) => \axaddr_incr_reg[11]_i_4__0_n_4\,
      O(2) => \axaddr_incr_reg[11]_i_4__0_n_5\,
      O(1) => \axaddr_incr_reg[11]_i_4__0_n_6\,
      O(0) => \axaddr_incr_reg[11]_i_4__0_n_7\,
      S(3) => \^axaddr_incr_reg[11]_0\(0),
      S(2) => \axaddr_incr_reg_n_0_[10]\,
      S(1) => \axaddr_incr_reg_n_0_[9]\,
      S(0) => \axaddr_incr_reg_n_0_[8]\
    );
\axaddr_incr_reg[1]\: unisim.vcomponents.FDRE
     port map (
      C => aclk,
      CE => \axaddr_incr_reg[0]_0\(0),
      D => \axaddr_incr[1]_i_1__0_n_0\,
      Q => \axaddr_incr_reg_n_0_[1]\,
      R => '0'
    );
\axaddr_incr_reg[2]\: unisim.vcomponents.FDRE
     port map (
      C => aclk,
      CE => \axaddr_incr_reg[0]_0\(0),
      D => \axaddr_incr[2]_i_1__0_n_0\,
      Q => \axaddr_incr_reg_n_0_[2]\,
      R => '0'
    );
\axaddr_incr_reg[3]\: unisim.vcomponents.FDRE
     port map (
      C => aclk,
      CE => \axaddr_incr_reg[0]_0\(0),
      D => \axaddr_incr[3]_i_1__0_n_0\,
      Q => \axaddr_incr_reg_n_0_[3]\,
      R => '0'
    );
\axaddr_incr_reg[3]_i_3__0\: unisim.vcomponents.CARRY4
     port map (
      CI => '0',
      CO(3) => \axaddr_incr_reg[3]_i_3__0_n_0\,
      CO(2) => \axaddr_incr_reg[3]_i_3__0_n_1\,
      CO(1) => \axaddr_incr_reg[3]_i_3__0_n_2\,
      CO(0) => \axaddr_incr_reg[3]_i_3__0_n_3\,
      CYINIT => '0',
      DI(3) => \axaddr_incr_reg_n_0_[3]\,
      DI(2) => \axaddr_incr_reg_n_0_[2]\,
      DI(1) => \axaddr_incr_reg_n_0_[1]\,
      DI(0) => \axaddr_incr_reg_n_0_[0]\,
      O(3) => \axaddr_incr_reg[3]_i_3__0_n_4\,
      O(2) => \axaddr_incr_reg[3]_i_3__0_n_5\,
      O(1) => \axaddr_incr_reg[3]_i_3__0_n_6\,
      O(0) => \axaddr_incr_reg[3]_i_3__0_n_7\,
      S(3) => \axaddr_incr[3]_i_12_n_0\,
      S(2) => \axaddr_incr[3]_i_13_n_0\,
      S(1) => \axaddr_incr[3]_i_14_n_0\,
      S(0) => \axaddr_incr[3]_i_15_n_0\
    );
\axaddr_incr_reg[4]\: unisim.vcomponents.FDRE
     port map (
      C => aclk,
      CE => \axaddr_incr_reg[0]_0\(0),
      D => \axaddr_incr[4]_i_1__0_n_0\,
      Q => \axaddr_incr_reg_n_0_[4]\,
      R => '0'
    );
\axaddr_incr_reg[5]\: unisim.vcomponents.FDRE
     port map (
      C => aclk,
      CE => \axaddr_incr_reg[0]_0\(0),
      D => \axaddr_incr[5]_i_1__0_n_0\,
      Q => \axaddr_incr_reg_n_0_[5]\,
      R => '0'
    );
\axaddr_incr_reg[6]\: unisim.vcomponents.FDRE
     port map (
      C => aclk,
      CE => \axaddr_incr_reg[0]_0\(0),
      D => \axaddr_incr[6]_i_1__0_n_0\,
      Q => \axaddr_incr_reg_n_0_[6]\,
      R => '0'
    );
\axaddr_incr_reg[7]\: unisim.vcomponents.FDRE
     port map (
      C => aclk,
      CE => \axaddr_incr_reg[0]_0\(0),
      D => \axaddr_incr[7]_i_1__0_n_0\,
      Q => \axaddr_incr_reg_n_0_[7]\,
      R => '0'
    );
\axaddr_incr_reg[7]_i_3__0\: unisim.vcomponents.CARRY4
     port map (
      CI => \axaddr_incr_reg[3]_i_3__0_n_0\,
      CO(3) => \axaddr_incr_reg[7]_i_3__0_n_0\,
      CO(2) => \axaddr_incr_reg[7]_i_3__0_n_1\,
      CO(1) => \axaddr_incr_reg[7]_i_3__0_n_2\,
      CO(0) => \axaddr_incr_reg[7]_i_3__0_n_3\,
      CYINIT => '0',
      DI(3 downto 0) => B"0000",
      O(3) => \axaddr_incr_reg[7]_i_3__0_n_4\,
      O(2) => \axaddr_incr_reg[7]_i_3__0_n_5\,
      O(1) => \axaddr_incr_reg[7]_i_3__0_n_6\,
      O(0) => \axaddr_incr_reg[7]_i_3__0_n_7\,
      S(3) => \axaddr_incr_reg_n_0_[7]\,
      S(2) => \axaddr_incr_reg_n_0_[6]\,
      S(1) => \axaddr_incr_reg_n_0_[5]\,
      S(0) => \axaddr_incr_reg_n_0_[4]\
    );
\axaddr_incr_reg[8]\: unisim.vcomponents.FDRE
     port map (
      C => aclk,
      CE => \axaddr_incr_reg[0]_0\(0),
      D => \axaddr_incr[8]_i_1__0_n_0\,
      Q => \axaddr_incr_reg_n_0_[8]\,
      R => '0'
    );
\axaddr_incr_reg[9]\: unisim.vcomponents.FDRE
     port map (
      C => aclk,
      CE => \axaddr_incr_reg[0]_0\(0),
      D => \axaddr_incr[9]_i_1__0_n_0\,
      Q => \axaddr_incr_reg_n_0_[9]\,
      R => '0'
    );
\axlen_cnt[0]_i_1__1\: unisim.vcomponents.LUT5
    generic map(
      INIT => X"4F444444"
    )
        port map (
      I0 => \axlen_cnt_reg_n_0_[0]\,
      I1 => next_pending_r_i_4_n_0,
      I2 => \axlen_cnt_reg[5]_0\(1),
      I3 => si_rs_arvalid,
      I4 => Q(15),
      O => \axlen_cnt[0]_i_1__1_n_0\
    );
\axlen_cnt[1]_i_1__2\: unisim.vcomponents.LUT5
    generic map(
      INIT => X"FF909090"
    )
        port map (
      I0 => \axlen_cnt_reg_n_0_[0]\,
      I1 => \axlen_cnt_reg_n_0_[1]\,
      I2 => next_pending_r_i_4_n_0,
      I3 => E(0),
      I4 => Q(16),
      O => \axlen_cnt[1]_i_1__2_n_0\
    );
\axlen_cnt[2]_i_1__2\: unisim.vcomponents.LUT6
    generic map(
      INIT => X"FFFFE100E100E100"
    )
        port map (
      I0 => \axlen_cnt_reg_n_0_[1]\,
      I1 => \axlen_cnt_reg_n_0_[0]\,
      I2 => \axlen_cnt_reg_n_0_[2]\,
      I3 => next_pending_r_i_4_n_0,
      I4 => E(0),
      I5 => Q(17),
      O => \axlen_cnt[2]_i_1__2_n_0\
    );
\axlen_cnt[3]_i_1__1\: unisim.vcomponents.LUT6
    generic map(
      INIT => X"FFFFFFFFFE010000"
    )
        port map (
      I0 => \axlen_cnt_reg_n_0_[2]\,
      I1 => \axlen_cnt_reg_n_0_[0]\,
      I2 => \axlen_cnt_reg_n_0_[1]\,
      I3 => \axlen_cnt_reg_n_0_[3]\,
      I4 => next_pending_r_i_4_n_0,
      I5 => \axlen_cnt_reg[3]_0\,
      O => \axlen_cnt[3]_i_1__1_n_0\
    );
\axlen_cnt[4]_i_1__2\: unisim.vcomponents.LUT5
    generic map(
      INIT => X"8F888888"
    )
        port map (
      I0 => \axlen_cnt[4]_i_2__0_n_0\,
      I1 => next_pending_r_i_4_n_0,
      I2 => \axlen_cnt_reg[5]_0\(1),
      I3 => si_rs_arvalid,
      I4 => Q(18),
      O => \axlen_cnt[4]_i_1__2_n_0\
    );
\axlen_cnt[4]_i_2__0\: unisim.vcomponents.LUT5
    generic map(
      INIT => X"FFFE0001"
    )
        port map (
      I0 => \axlen_cnt_reg_n_0_[3]\,
      I1 => \axlen_cnt_reg_n_0_[1]\,
      I2 => \axlen_cnt_reg_n_0_[0]\,
      I3 => \axlen_cnt_reg_n_0_[2]\,
      I4 => \axlen_cnt_reg_n_0_[4]\,
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
    )
        port map (
      I0 => \m_axi_araddr[10]\(7),
      I1 => m_axi_araddr_0_sn_1,
      I2 => \m_axi_araddr[0]_0\,
      I3 => \axaddr_incr_reg_n_0_[7]\,
      I4 => Q(7),
      I5 => \^sel_first_reg_1\,
      O => m_axi_araddr(7)
    );
\m_axi_araddr[8]_INST_0\: unisim.vcomponents.LUT6
    generic map(
      INIT => X"FFFFF888F888F888"
    )
        port map (
      I0 => \m_axi_araddr[10]\(8),
      I1 => m_axi_araddr_0_sn_1,
      I2 => \m_axi_araddr[0]_0\,
      I3 => \axaddr_incr_reg_n_0_[8]\,
      I4 => Q(8),
      I5 => \^sel_first_reg_1\,
      O => m_axi_araddr(8)
    );
\m_axi_araddr[9]_INST_0\: unisim.vcomponents.LUT6
    generic map(
      INIT => X"FFFFF888F888F888"
    )
        port map (
      I0 => \m_axi_araddr[10]\(9),
      I1 => m_axi_araddr_0_sn_1,
      I2 => \m_axi_araddr[0]_0\,
      I3 => \axaddr_incr_reg_n_0_[9]\,
      I4 => Q(9),
      I5 => \^sel_first_reg_1\,
      O => m_axi_araddr(9)
    );
\next_pending_r_i_1__2\: unisim.vcomponents.LUT6
    generic map(
      INIT => X"FF888888B8B8B8B8"
    )
        port map (
      I0 => next_pending_r_reg_0,
      I1 => E(0),
      I2 => next_pending_r_reg_n_0,
      I3 => \next_pending_r_i_3__1_n_0\,
      I4 => next_pending_r_i_4_n_0,
      I5 => r_push,
      O => \^incr_next_pending\
    );
\next_pending_r_i_3__1\: unisim.vcomponents.LUT6
    generic map(
      INIT => X"FFFFFFFFFFFFFEEF"
    )
        port map (
      I0 => \next_pending_r_i_6__0_n_0\,
      I1 => \axlen_cnt_reg_n_0_[7]\,
      I2 => \axlen_cnt[8]_i_3__0_n_0\,
      I3 => \axlen_cnt_reg_n_0_[6]\,
      I4 => \axlen_cnt_reg_n_0_[8]\,
      I5 => \next_pending_r_i_7__0_n_0\,
      O => \next_pending_r_i_3__1_n_0\
    );
next_pending_r_i_4: unisim.vcomponents.LUT6
    generic map(
      INIT => X"00000000FFFFFFFE"
    )
        port map (
      I0 => \next_pending_r_i_8__0_n_0\,
      I1 => \axlen_cnt_reg_n_0_[2]\,
      I2 => \axlen_cnt_reg_n_0_[1]\,
      I3 => \axlen_cnt_reg_n_0_[4]\,
      I4 => \axlen_cnt_reg_n_0_[3]\,
      I5 => E(0),
      O => next_pending_r_i_4_n_0
    );
\next_pending_r_i_6__0\: unisim.vcomponents.LUT6
    generic map(
      INIT => X"FFFFFFFFFFFFEEEB"
    )
        port map (
      I0 => \axlen_cnt_reg_n_0_[4]\,
      I1 => \axlen_cnt_reg_n_0_[2]\,
      I2 => \axlen_cnt_reg_n_0_[0]\,
      I3 => \axlen_cnt_reg_n_0_[1]\,
      I4 => \axlen_cnt_reg_n_0_[3]\,
      I5 => \axlen_cnt_reg_n_0_[5]\,
      O => \next_pending_r_i_6__0_n_0\
    );
\next_pending_r_i_7__0\: unisim.vcomponents.LUT2
    generic map(
      INIT => X"B"
    )
        port map (
      I0 => \axlen_cnt_reg_n_0_[1]\,
      I1 => \axlen_cnt_reg_n_0_[0]\,
      O => \next_pending_r_i_7__0_n_0\
    );
\next_pending_r_i_8__0\: unisim.vcomponents.LUT4
    generic map(
      INIT => X"FFFE"
    )
        port map (
      I0 => \axlen_cnt_reg_n_0_[6]\,
      I1 => \axlen_cnt_reg_n_0_[5]\,
      I2 => \axlen_cnt_reg_n_0_[8]\,
      I3 => \axlen_cnt_reg_n_0_[7]\,
      O => \next_pending_r_i_8__0_n_0\
    );
next_pending_r_reg: unisim.vcomponents.FDRE
     port map (
      C => aclk,
      CE => '1',
      D => \^incr_next_pending\,
      Q => next_pending_r_reg_n_0,
      R => '0'
    );
\s_axburst_eq0_i_1__0\: unisim.vcomponents.LUT4
    generic map(
      INIT => X"BA8A"
    )
        port map (
      I0 => \^incr_next_pending\,
      I1 => sel_first_i,
      I2 => Q(14),
      I3 => wrap_next_pending,
      O => \m_payload_i_reg[39]\
    );
sel_first_reg: unisim.vcomponents.FDRE
     port map (
      C => aclk,
      CE => '1',
      D => sel_first_reg_2,
      Q => \^sel_first_reg_0\,
      R => '0'
    );
end STRUCTURE;
library IEEE;
use IEEE.STD_LOGIC_1164.ALL;
library UNISIM;
use UNISIM.VCOMPONENTS.ALL;
entity mid_project_auto_pc_0_axi_protocol_converter_v2_1_18_b2s_rd_cmd_fsm is
  port (
    s_ready_i0 : out STD_LOGIC;
    Q : out STD_LOGIC_VECTOR ( 1 downto 0 );
    m_valid_i0 : out STD_LOGIC;
    E : out STD_LOGIC_VECTOR ( 0 to 0 );
    m_axi_arready_0 : out STD_LOGIC;
    m_axi_arready_1 : out STD_LOGIC;
    sel_first_i : out STD_LOGIC;
    \FSM_sequential_state_reg[1]_0\ : out STD_LOGIC_VECTOR ( 0 to 0 );
    sel_first_reg : out STD_LOGIC_VECTOR ( 0 to 0 );
    D : out STD_LOGIC_VECTOR ( 11 downto 0 );
    m_axi_arready_2 : out STD_LOGIC;
    m_axi_arvalid : out STD_LOGIC;
    \FSM_sequential_state_reg[1]_1\ : out STD_LOGIC_VECTOR ( 0 to 0 );
    si_rs_arvalid : in STD_LOGIC;
    s_axi_arvalid : in STD_LOGIC;
    s_ready_i_reg : in STD_LOGIC;
    m_axi_arready : in STD_LOGIC;
    sel_first_reg_0 : in STD_LOGIC;
    areset_d1 : in STD_LOGIC;
    \axaddr_incr_reg[0]\ : in STD_LOGIC;
    sel_first_reg_1 : in STD_LOGIC;
    O : in STD_LOGIC_VECTOR ( 3 downto 0 );
    \axaddr_wrap_reg[11]\ : in STD_LOGIC_VECTOR ( 11 downto 0 );
    \axaddr_wrap_reg[11]_0\ : in STD_LOGIC_VECTOR ( 11 downto 0 );
    \axaddr_wrap_reg[7]\ : in STD_LOGIC_VECTOR ( 3 downto 0 );
    \axaddr_wrap_reg[11]_1\ : in STD_LOGIC_VECTOR ( 3 downto 0 );
    \axaddr_wrap_reg[11]_2\ : in STD_LOGIC;
    next_pending : in STD_LOGIC;
    r_full : in STD_LOGIC;
    aclk : in STD_LOGIC
  );
end mid_project_auto_pc_0_axi_protocol_converter_v2_1_18_b2s_rd_cmd_fsm;

architecture STRUCTURE of mid_project_auto_pc_0_axi_protocol_converter_v2_1_18_b2s_rd_cmd_fsm is
  signal \^q\ : STD_LOGIC_VECTOR ( 1 downto 0 );
  signal \axaddr_wrap[11]_i_2_n_0\ : STD_LOGIC;
  signal \axaddr_wrap[11]_i_4_n_0\ : STD_LOGIC;
  signal \^m_axi_arready_2\ : STD_LOGIC;
  signal \next_state__0\ : STD_LOGIC_VECTOR ( 1 downto 0 );
  attribute SOFT_HLUTNM : string;
  attribute SOFT_HLUTNM of \FSM_sequential_state[0]_i_1\ : label is "soft_lutpair1";
  attribute FSM_ENCODED_STATES : string;
  attribute FSM_ENCODED_STATES of \FSM_sequential_state_reg[0]\ : label is "SM_IDLE:01,SM_DONE:00,SM_CMD_ACCEPTED:10,SM_CMD_EN:11";
  attribute FSM_ENCODED_STATES of \FSM_sequential_state_reg[1]\ : label is "SM_IDLE:01,SM_DONE:00,SM_CMD_ACCEPTED:10,SM_CMD_EN:11";
  attribute SOFT_HLUTNM of \axaddr_incr[11]_i_1__0\ : label is "soft_lutpair3";
  attribute SOFT_HLUTNM of \axaddr_wrap[11]_i_2\ : label is "soft_lutpair4";
  attribute SOFT_HLUTNM of \axaddr_wrap[11]_i_4\ : label is "soft_lutpair3";
  attribute SOFT_HLUTNM of \axlen_cnt[8]_i_1__0\ : label is "soft_lutpair2";
  attribute SOFT_HLUTNM of \m_payload_i[31]_i_1__1\ : label is "soft_lutpair4";
  attribute SOFT_HLUTNM of \m_valid_i_i_1__2\ : label is "soft_lutpair0";
  attribute SOFT_HLUTNM of r_push_r_i_1 : label is "soft_lutpair1";
  attribute SOFT_HLUTNM of \s_ready_i_i_1__2\ : label is "soft_lutpair0";
  attribute SOFT_HLUTNM of \wrap_boundary_axaddr_r[11]_i_1__0\ : label is "soft_lutpair2";
begin
  Q(1 downto 0) <= \^q\(1 downto 0);
  m_axi_arready_2 <= \^m_axi_arready_2\;
\FSM_sequential_state[0]_i_1\: unisim.vcomponents.LUT5
    generic map(
      INIT => X"77F755FF"
    )
        port map (
      I0 => \^q\(1),
      I1 => m_axi_arready,
      I2 => next_pending,
      I3 => r_full,
      I4 => \^q\(0),
      O => \next_state__0\(0)
    );
\FSM_sequential_state[1]_i_1\: unisim.vcomponents.LUT6
    generic map(
      INIT => X"DDFFDDFF0F000000"
    )
        port map (
      I0 => m_axi_arready,
      I1 => next_pending,
      I2 => r_full,
      I3 => \^q\(0),
      I4 => si_rs_arvalid,
      I5 => \^q\(1),
      O => \next_state__0\(1)
    );
\FSM_sequential_state_reg[0]\: unisim.vcomponents.FDSE
    generic map(
      INIT => '1'
    )
        port map (
      C => aclk,
      CE => '1',
      D => \next_state__0\(0),
      Q => \^q\(0),
      S => areset_d1
    );
\FSM_sequential_state_reg[1]\: unisim.vcomponents.FDRE
    generic map(
      INIT => '0'
    )
        port map (
      C => aclk,
      CE => '1',
      D => \next_state__0\(1),
      Q => \^q\(1),
      R => areset_d1
    );
\axaddr_incr[11]_i_1__0\: unisim.vcomponents.LUT4
    generic map(
      INIT => X"EAAA"
    )
        port map (
      I0 => \axaddr_incr_reg[0]\,
      I1 => \^q\(0),
      I2 => \^q\(1),
      I3 => m_axi_arready,
      O => sel_first_reg(0)
    );
\axaddr_wrap[0]_i_1\: unisim.vcomponents.LUT6
    generic map(
      INIT => X"FFFF88F888F888F8"
    )
        port map (
      I0 => \axaddr_wrap[11]_i_2_n_0\,
      I1 => O(0),
      I2 => \axaddr_wrap_reg[11]\(0),
      I3 => \^m_axi_arready_2\,
      I4 => \axaddr_wrap_reg[11]_0\(0),
      I5 => \axaddr_wrap[11]_i_4_n_0\,
      O => D(0)
    );
\axaddr_wrap[10]_i_1\: unisim.vcomponents.LUT6
    generic map(
      INIT => X"FFFF88F888F888F8"
    )
        port map (
      I0 => \axaddr_wrap[11]_i_2_n_0\,
      I1 => \axaddr_wrap_reg[11]_1\(2),
      I2 => \axaddr_wrap_reg[11]\(10),
      I3 => \^m_axi_arready_2\,
      I4 => \axaddr_wrap_reg[11]_0\(10),
      I5 => \axaddr_wrap[11]_i_4_n_0\,
      O => D(10)
    );
\axaddr_wrap[11]_i_1\: unisim.vcomponents.LUT6
    generic map(
      INIT => X"FFFF88F888F888F8"
    )
        port map (
      I0 => \axaddr_wrap[11]_i_2_n_0\,
      I1 => \axaddr_wrap_reg[11]_1\(3),
      I2 => \axaddr_wrap_reg[11]\(11),
      I3 => \^m_axi_arready_2\,
      I4 => \axaddr_wrap_reg[11]_0\(11),
      I5 => \axaddr_wrap[11]_i_4_n_0\,
      O => D(11)
    );
\axaddr_wrap[11]_i_2\: unisim.vcomponents.LUT4
    generic map(
      INIT => X"0080"
    )
        port map (
      I0 => \^q\(0),
      I1 => \^q\(1),
      I2 => m_axi_arready,
      I3 => \axaddr_wrap_reg[11]_2\,
      O => \axaddr_wrap[11]_i_2_n_0\
    );
\axaddr_wrap[11]_i_4\: unisim.vcomponents.LUT4
    generic map(
      INIT => X"8000"
    )
        port map (
      I0 => \axaddr_wrap_reg[11]_2\,
      I1 => \^q\(0),
      I2 => \^q\(1),
      I3 => m_axi_arready,
      O => \axaddr_wrap[11]_i_4_n_0\
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
r_push_r_i_1: unisim.vcomponents.LUT3
    generic map(
      INIT => X"80"
    )
        port map (
      I0 => m_axi_arready,
      I1 => \^q\(1),
      I2 => \^q\(0),
      O => \^m_axi_arready_2\
    );
\s_ready_i_i_1__2\: unisim.vcomponents.LUT5
    generic map(
      INIT => X"1FFF1F1F"
    )
        port map (
      I0 => \^q\(1),
      I1 => \^q\(0),
      I2 => si_rs_arvalid,
      I3 => s_axi_arvalid,
      I4 => s_ready_i_reg,
      O => s_ready_i0
    );
\sel_first_i_1__2\: unisim.vcomponents.LUT6
    generic map(
      INIT => X"FFFFFFFF4FCC4CCC"
    )
        port map (
      I0 => m_axi_arready,
      I1 => sel_first_reg_0,
      I2 => \^q\(1),
      I3 => \^q\(0),
      I4 => si_rs_arvalid,
      I5 => areset_d1,
      O => m_axi_arready_0
    );
\sel_first_i_1__3\: unisim.vcomponents.LUT6
    generic map(
      INIT => X"FFFFFFFF4FCC4CCC"
    )
        port map (
      I0 => m_axi_arready,
      I1 => \axaddr_incr_reg[0]\,
      I2 => \^q\(1),
      I3 => \^q\(0),
      I4 => si_rs_arvalid,
      I5 => areset_d1,
      O => m_axi_arready_1
    );
\sel_first_i_1__4\: unisim.vcomponents.LUT6
    generic map(
      INIT => X"FFFFFFFF4FCC4CCC"
    )
        port map (
      I0 => m_axi_arready,
      I1 => sel_first_reg_1,
      I2 => \^q\(1),
      I3 => \^q\(0),
      I4 => si_rs_arvalid,
      I5 => areset_d1,
      O => sel_first_i
    );
\wrap_boundary_axaddr_r[11]_i_1__0\: unisim.vcomponents.LUT3
    generic map(
      INIT => X"40"
    )
        port map (
      I0 => \^q\(1),
      I1 => \^q\(0),
      I2 => si_rs_arvalid,
      O => \FSM_sequential_state_reg[1]_0\(0)
    );
end STRUCTURE;
library IEEE;
use IEEE.STD_LOGIC_1164.ALL;
library UNISIM;
use UNISIM.VCOMPONENTS.ALL;
entity mid_project_auto_pc_0_axi_protocol_converter_v2_1_18_b2s_simple_fifo is
  port (
    b_full : out STD_LOGIC;
    addr : out STD_LOGIC_VECTOR ( 1 downto 0 );
    SR : out STD_LOGIC_VECTOR ( 0 to 0 );
    bresp_push : out STD_LOGIC;
    shandshake_r_reg : out STD_LOGIC;
    \out\ : out STD_LOGIC_VECTOR ( 0 to 0 );
    areset_d1 : in STD_LOGIC;
    mhandshake_r : in STD_LOGIC;
    Q : in STD_LOGIC_VECTOR ( 7 downto 0 );
    shandshake_r : in STD_LOGIC;
    bresp_empty : in STD_LOGIC;
    si_rs_bvalid : in STD_LOGIC;
    si_rs_bready : in STD_LOGIC;
    b_push : in STD_LOGIC;
    \in\ : in STD_LOGIC_VECTOR ( 8 downto 0 );
    aclk : in STD_LOGIC
  );
end mid_project_auto_pc_0_axi_protocol_converter_v2_1_18_b2s_simple_fifo;

architecture STRUCTURE of mid_project_auto_pc_0_axi_protocol_converter_v2_1_18_b2s_simple_fifo is
  signal \^addr\ : STD_LOGIC_VECTOR ( 1 downto 0 );
  signal \bresp_cnt[7]_i_3_n_0\ : STD_LOGIC;
  signal \bresp_cnt[7]_i_4_n_0\ : STD_LOGIC;
  signal \bresp_cnt[7]_i_6_n_0\ : STD_LOGIC;
  signal bvalid_i21_in : STD_LOGIC;
  signal \cnt_read[0]_i_1_n_0\ : STD_LOGIC;
  signal \cnt_read[1]_i_1_n_0\ : STD_LOGIC;
  signal \memory_reg[3][0]_srl4_i_2__0_n_0\ : STD_LOGIC;
  signal \memory_reg[3][0]_srl4_i_3__0_n_0\ : STD_LOGIC;
  signal \memory_reg[3][0]_srl4_i_4_n_0\ : STD_LOGIC;
  signal \memory_reg[3][0]_srl4_n_0\ : STD_LOGIC;
  signal \memory_reg[3][1]_srl4_n_0\ : STD_LOGIC;
  signal \memory_reg[3][2]_srl4_n_0\ : STD_LOGIC;
  signal \memory_reg[3][3]_srl4_n_0\ : STD_LOGIC;
  signal \memory_reg[3][4]_srl4_n_0\ : STD_LOGIC;
  signal \memory_reg[3][5]_srl4_n_0\ : STD_LOGIC;
  signal \memory_reg[3][6]_srl4_n_0\ : STD_LOGIC;
  signal \memory_reg[3][7]_srl4_n_0\ : STD_LOGIC;
  attribute SOFT_HLUTNM : string;
  attribute SOFT_HLUTNM of bvalid_i_i_2 : label is "soft_lutpair105";
  attribute SOFT_HLUTNM of \cnt_read[0]_i_1\ : label is "soft_lutpair104";
  attribute SOFT_HLUTNM of \cnt_read[1]_i_1\ : label is "soft_lutpair104";
  attribute srl_bus_name : string;
  attribute srl_bus_name of \memory_reg[3][0]_srl4\ : label is "inst/\gen_axilite.gen_b2s_conv.axilite_b2s/WR.b_channel_0/bid_fifo_0/memory_reg[3] ";
  attribute srl_name : string;
  attribute srl_name of \memory_reg[3][0]_srl4\ : label is "inst/\gen_axilite.gen_b2s_conv.axilite_b2s/WR.b_channel_0/bid_fifo_0/memory_reg[3][0]_srl4 ";
  attribute SOFT_HLUTNM of \memory_reg[3][0]_srl4_i_2\ : label is "soft_lutpair105";
  attribute srl_bus_name of \memory_reg[3][1]_srl4\ : label is "inst/\gen_axilite.gen_b2s_conv.axilite_b2s/WR.b_channel_0/bid_fifo_0/memory_reg[3] ";
  attribute srl_name of \memory_reg[3][1]_srl4\ : label is "inst/\gen_axilite.gen_b2s_conv.axilite_b2s/WR.b_channel_0/bid_fifo_0/memory_reg[3][1]_srl4 ";
  attribute srl_bus_name of \memory_reg[3][2]_srl4\ : label is "inst/\gen_axilite.gen_b2s_conv.axilite_b2s/WR.b_channel_0/bid_fifo_0/memory_reg[3] ";
  attribute srl_name of \memory_reg[3][2]_srl4\ : label is "inst/\gen_axilite.gen_b2s_conv.axilite_b2s/WR.b_channel_0/bid_fifo_0/memory_reg[3][2]_srl4 ";
  attribute srl_bus_name of \memory_reg[3][3]_srl4\ : label is "inst/\gen_axilite.gen_b2s_conv.axilite_b2s/WR.b_channel_0/bid_fifo_0/memory_reg[3] ";
  attribute srl_name of \memory_reg[3][3]_srl4\ : label is "inst/\gen_axilite.gen_b2s_conv.axilite_b2s/WR.b_channel_0/bid_fifo_0/memory_reg[3][3]_srl4 ";
  attribute srl_bus_name of \memory_reg[3][4]_srl4\ : label is "inst/\gen_axilite.gen_b2s_conv.axilite_b2s/WR.b_channel_0/bid_fifo_0/memory_reg[3] ";
  attribute srl_name of \memory_reg[3][4]_srl4\ : label is "inst/\gen_axilite.gen_b2s_conv.axilite_b2s/WR.b_channel_0/bid_fifo_0/memory_reg[3][4]_srl4 ";
  attribute srl_bus_name of \memory_reg[3][5]_srl4\ : label is "inst/\gen_axilite.gen_b2s_conv.axilite_b2s/WR.b_channel_0/bid_fifo_0/memory_reg[3] ";
  attribute srl_name of \memory_reg[3][5]_srl4\ : label is "inst/\gen_axilite.gen_b2s_conv.axilite_b2s/WR.b_channel_0/bid_fifo_0/memory_reg[3][5]_srl4 ";
  attribute srl_bus_name of \memory_reg[3][6]_srl4\ : label is "inst/\gen_axilite.gen_b2s_conv.axilite_b2s/WR.b_channel_0/bid_fifo_0/memory_reg[3] ";
  attribute srl_name of \memory_reg[3][6]_srl4\ : label is "inst/\gen_axilite.gen_b2s_conv.axilite_b2s/WR.b_channel_0/bid_fifo_0/memory_reg[3][6]_srl4 ";
  attribute srl_bus_name of \memory_reg[3][7]_srl4\ : label is "inst/\gen_axilite.gen_b2s_conv.axilite_b2s/WR.b_channel_0/bid_fifo_0/memory_reg[3] ";
  attribute srl_name of \memory_reg[3][7]_srl4\ : label is "inst/\gen_axilite.gen_b2s_conv.axilite_b2s/WR.b_channel_0/bid_fifo_0/memory_reg[3][7]_srl4 ";
  attribute srl_bus_name of \memory_reg[3][8]_srl4\ : label is "inst/\gen_axilite.gen_b2s_conv.axilite_b2s/WR.b_channel_0/bid_fifo_0/memory_reg[3] ";
  attribute srl_name of \memory_reg[3][8]_srl4\ : label is "inst/\gen_axilite.gen_b2s_conv.axilite_b2s/WR.b_channel_0/bid_fifo_0/memory_reg[3][8]_srl4 ";
begin
  addr(1 downto 0) <= \^addr\(1 downto 0);
\bresp_cnt[7]_i_1\: unisim.vcomponents.LUT6
    generic map(
      INIT => X"AAAAAAAAAABABABA"
    )
        port map (
      I0 => areset_d1,
      I1 => \bresp_cnt[7]_i_3_n_0\,
      I2 => mhandshake_r,
      I3 => \^addr\(0),
      I4 => \^addr\(1),
      I5 => \bresp_cnt[7]_i_4_n_0\,
      O => SR(0)
    );
\bresp_cnt[7]_i_3\: unisim.vcomponents.LUT6
    generic map(
      INIT => X"FFFFFFFFBEFFFFBE"
    )
        port map (
      I0 => \memory_reg[3][0]_srl4_i_4_n_0\,
      I1 => Q(3),
      I2 => \memory_reg[3][3]_srl4_n_0\,
      I3 => Q(4),
      I4 => \memory_reg[3][4]_srl4_n_0\,
      I5 => \bresp_cnt[7]_i_6_n_0\,
      O => \bresp_cnt[7]_i_3_n_0\
    );
\bresp_cnt[7]_i_4\: unisim.vcomponents.LUT4
    generic map(
      INIT => X"6FF6"
    )
        port map (
      I0 => Q(6),
      I1 => \memory_reg[3][6]_srl4_n_0\,
      I2 => Q(7),
      I3 => \memory_reg[3][7]_srl4_n_0\,
      O => \bresp_cnt[7]_i_4_n_0\
    );
\bresp_cnt[7]_i_6\: unisim.vcomponents.LUT4
    generic map(
      INIT => X"6FF6"
    )
        port map (
      I0 => Q(2),
      I1 => \memory_reg[3][2]_srl4_n_0\,
      I2 => Q(5),
      I3 => \memory_reg[3][5]_srl4_n_0\,
      O => \bresp_cnt[7]_i_6_n_0\
    );
bvalid_i_i_1: unisim.vcomponents.LUT6
    generic map(
      INIT => X"0000000400FF0004"
    )
        port map (
      I0 => shandshake_r,
      I1 => bvalid_i21_in,
      I2 => bresp_empty,
      I3 => areset_d1,
      I4 => si_rs_bvalid,
      I5 => si_rs_bready,
      O => shandshake_r_reg
    );
bvalid_i_i_2: unisim.vcomponents.LUT2
    generic map(
      INIT => X"7"
    )
        port map (
      I0 => \^addr\(0),
      I1 => \^addr\(1),
      O => bvalid_i21_in
    );
\cnt_read[0]_i_1\: unisim.vcomponents.LUT3
    generic map(
      INIT => X"96"
    )
        port map (
      I0 => shandshake_r,
      I1 => b_push,
      I2 => \^addr\(0),
      O => \cnt_read[0]_i_1_n_0\
    );
\cnt_read[1]_i_1\: unisim.vcomponents.LUT4
    generic map(
      INIT => X"E718"
    )
        port map (
      I0 => \^addr\(0),
      I1 => b_push,
      I2 => shandshake_r,
      I3 => \^addr\(1),
      O => \cnt_read[1]_i_1_n_0\
    );
\cnt_read_reg[0]\: unisim.vcomponents.FDSE
    generic map(
      INIT => '1'
    )
        port map (
      C => aclk,
      CE => '1',
      D => \cnt_read[0]_i_1_n_0\,
      Q => \^addr\(0),
      S => areset_d1
    );
\cnt_read_reg[1]\: unisim.vcomponents.FDSE
    generic map(
      INIT => '1'
    )
        port map (
      C => aclk,
      CE => '1',
      D => \cnt_read[1]_i_1_n_0\,
      Q => \^addr\(1),
      S => areset_d1
    );
\memory_reg[3][0]_srl4\: unisim.vcomponents.SRL16E
    generic map(
      INIT => X"0000"
    )
        port map (
      A0 => \^addr\(0),
      A1 => \^addr\(1),
      A2 => '0',
      A3 => '0',
      CE => b_push,
      CLK => aclk,
      D => \in\(0),
      Q => \memory_reg[3][0]_srl4_n_0\
    );
\memory_reg[3][0]_srl4_i_1\: unisim.vcomponents.LUT6
    generic map(
      INIT => X"0000000082000082"
    )
        port map (
      I0 => \memory_reg[3][0]_srl4_i_2__0_n_0\,
      I1 => Q(2),
      I2 => \memory_reg[3][2]_srl4_n_0\,
      I3 => Q(5),
      I4 => \memory_reg[3][5]_srl4_n_0\,
      I5 => \memory_reg[3][0]_srl4_i_3__0_n_0\,
      O => bresp_push
    );
\memory_reg[3][0]_srl4_i_2\: unisim.vcomponents.LUT2
    generic map(
      INIT => X"2"
    )
        port map (
      I0 => \^addr\(1),
      I1 => \^addr\(0),
      O => b_full
    );
\memory_reg[3][0]_srl4_i_2__0\: unisim.vcomponents.LUT6
    generic map(
      INIT => X"8008000000008008"
    )
        port map (
      I0 => mhandshake_r,
      I1 => bvalid_i21_in,
      I2 => \memory_reg[3][7]_srl4_n_0\,
      I3 => Q(7),
      I4 => \memory_reg[3][6]_srl4_n_0\,
      I5 => Q(6),
      O => \memory_reg[3][0]_srl4_i_2__0_n_0\
    );
\memory_reg[3][0]_srl4_i_3__0\: unisim.vcomponents.LUT5
    generic map(
      INIT => X"FFFF6FF6"
    )
        port map (
      I0 => \memory_reg[3][4]_srl4_n_0\,
      I1 => Q(4),
      I2 => \memory_reg[3][3]_srl4_n_0\,
      I3 => Q(3),
      I4 => \memory_reg[3][0]_srl4_i_4_n_0\,
      O => \memory_reg[3][0]_srl4_i_3__0_n_0\
    );
\memory_reg[3][0]_srl4_i_4\: unisim.vcomponents.LUT4
    generic map(
      INIT => X"6FF6"
    )
        port map (
      I0 => Q(0),
      I1 => \memory_reg[3][0]_srl4_n_0\,
      I2 => Q(1),
      I3 => \memory_reg[3][1]_srl4_n_0\,
      O => \memory_reg[3][0]_srl4_i_4_n_0\
    );
\memory_reg[3][1]_srl4\: unisim.vcomponents.SRL16E
    generic map(
      INIT => X"0000"
    )
        port map (
      A0 => \^addr\(0),
      A1 => \^addr\(1),
      A2 => '0',
      A3 => '0',
      CE => b_push,
      CLK => aclk,
      D => \in\(1),
      Q => \memory_reg[3][1]_srl4_n_0\
    );
\memory_reg[3][2]_srl4\: unisim.vcomponents.SRL16E
    generic map(
      INIT => X"0000"
    )
        port map (
      A0 => \^addr\(0),
      A1 => \^addr\(1),
      A2 => '0',
      A3 => '0',
      CE => b_push,
      CLK => aclk,
      D => \in\(2),
      Q => \memory_reg[3][2]_srl4_n_0\
    );
\memory_reg[3][3]_srl4\: unisim.vcomponents.SRL16E
    generic map(
      INIT => X"0000"
    )
        port map (
      A0 => \^addr\(0),
      A1 => \^addr\(1),
      A2 => '0',
      A3 => '0',
      CE => b_push,
      CLK => aclk,
      D => \in\(3),
      Q => \memory_reg[3][3]_srl4_n_0\
    );
\memory_reg[3][4]_srl4\: unisim.vcomponents.SRL16E
    generic map(
      INIT => X"0000"
    )
        port map (
      A0 => \^addr\(0),
      A1 => \^addr\(1),
      A2 => '0',
      A3 => '0',
      CE => b_push,
      CLK => aclk,
      D => \in\(4),
      Q => \memory_reg[3][4]_srl4_n_0\
    );
\memory_reg[3][5]_srl4\: unisim.vcomponents.SRL16E
    generic map(
      INIT => X"0000"
    )
        port map (
      A0 => \^addr\(0),
      A1 => \^addr\(1),
      A2 => '0',
      A3 => '0',
      CE => b_push,
      CLK => aclk,
      D => \in\(5),
      Q => \memory_reg[3][5]_srl4_n_0\
    );
\memory_reg[3][6]_srl4\: unisim.vcomponents.SRL16E
    generic map(
      INIT => X"0000"
    )
        port map (
      A0 => \^addr\(0),
      A1 => \^addr\(1),
      A2 => '0',
      A3 => '0',
      CE => b_push,
      CLK => aclk,
      D => \in\(6),
      Q => \memory_reg[3][6]_srl4_n_0\
    );
\memory_reg[3][7]_srl4\: unisim.vcomponents.SRL16E
    generic map(
      INIT => X"0000"
    )
        port map (
      A0 => \^addr\(0),
      A1 => \^addr\(1),
      A2 => '0',
      A3 => '0',
      CE => b_push,
      CLK => aclk,
      D => \in\(7),
      Q => \memory_reg[3][7]_srl4_n_0\
    );
\memory_reg[3][8]_srl4\: unisim.vcomponents.SRL16E
    generic map(
      INIT => X"0000"
    )
        port map (
      A0 => \^addr\(0),
      A1 => \^addr\(1),
      A2 => '0',
      A3 => '0',
      CE => b_push,
      CLK => aclk,
      D => \in\(8),
      Q => \out\(0)
    );
end STRUCTURE;
library IEEE;
use IEEE.STD_LOGIC_1164.ALL;
library UNISIM;
use UNISIM.VCOMPONENTS.ALL;
entity \mid_project_auto_pc_0_axi_protocol_converter_v2_1_18_b2s_simple_fifo__parameterized0\ is
  port (
    m_axi_bready : out STD_LOGIC;
    mhandshake : out STD_LOGIC;
    bresp_empty : out STD_LOGIC;
    \s_bresp_acc_reg[1]\ : out STD_LOGIC_VECTOR ( 1 downto 0 );
    mhandshake_r : in STD_LOGIC;
    m_axi_bvalid : in STD_LOGIC;
    bresp_push : in STD_LOGIC;
    \in\ : in STD_LOGIC_VECTOR ( 1 downto 0 );
    aclk : in STD_LOGIC;
    shandshake_r : in STD_LOGIC;
    areset_d1 : in STD_LOGIC
  );
  attribute ORIG_REF_NAME : string;
  attribute ORIG_REF_NAME of \mid_project_auto_pc_0_axi_protocol_converter_v2_1_18_b2s_simple_fifo__parameterized0\ : entity is "axi_protocol_converter_v2_1_18_b2s_simple_fifo";
end \mid_project_auto_pc_0_axi_protocol_converter_v2_1_18_b2s_simple_fifo__parameterized0\;

architecture STRUCTURE of \mid_project_auto_pc_0_axi_protocol_converter_v2_1_18_b2s_simple_fifo__parameterized0\ is
  signal cnt_read : STD_LOGIC_VECTOR ( 1 downto 0 );
  signal \cnt_read[0]_i_1_n_0\ : STD_LOGIC;
  signal \cnt_read[1]_i_1_n_0\ : STD_LOGIC;
  attribute SOFT_HLUTNM : string;
  attribute SOFT_HLUTNM of \cnt_read[0]_i_1\ : label is "soft_lutpair106";
  attribute SOFT_HLUTNM of \cnt_read[1]_i_1\ : label is "soft_lutpair106";
  attribute SOFT_HLUTNM of m_axi_bready_INST_0 : label is "soft_lutpair107";
  attribute srl_bus_name : string;
  attribute srl_bus_name of \memory_reg[3][0]_srl4\ : label is "inst/\gen_axilite.gen_b2s_conv.axilite_b2s/WR.b_channel_0/bresp_fifo_0/memory_reg[3] ";
  attribute srl_name : string;
  attribute srl_name of \memory_reg[3][0]_srl4\ : label is "inst/\gen_axilite.gen_b2s_conv.axilite_b2s/WR.b_channel_0/bresp_fifo_0/memory_reg[3][0]_srl4 ";
  attribute srl_bus_name of \memory_reg[3][1]_srl4\ : label is "inst/\gen_axilite.gen_b2s_conv.axilite_b2s/WR.b_channel_0/bresp_fifo_0/memory_reg[3] ";
  attribute srl_name of \memory_reg[3][1]_srl4\ : label is "inst/\gen_axilite.gen_b2s_conv.axilite_b2s/WR.b_channel_0/bresp_fifo_0/memory_reg[3][1]_srl4 ";
  attribute SOFT_HLUTNM of mhandshake_r_i_1 : label is "soft_lutpair107";
begin
bvalid_i_i_3: unisim.vcomponents.LUT2
    generic map(
      INIT => X"8"
    )
        port map (
      I0 => cnt_read(0),
      I1 => cnt_read(1),
      O => bresp_empty
    );
\cnt_read[0]_i_1\: unisim.vcomponents.LUT3
    generic map(
      INIT => X"96"
    )
        port map (
      I0 => shandshake_r,
      I1 => bresp_push,
      I2 => cnt_read(0),
      O => \cnt_read[0]_i_1_n_0\
    );
\cnt_read[1]_i_1\: unisim.vcomponents.LUT4
    generic map(
      INIT => X"E718"
    )
        port map (
      I0 => cnt_read(0),
      I1 => bresp_push,
      I2 => shandshake_r,
      I3 => cnt_read(1),
      O => \cnt_read[1]_i_1_n_0\
    );
\cnt_read_reg[0]\: unisim.vcomponents.FDSE
    generic map(
      INIT => '1'
    )
        port map (
      C => aclk,
      CE => '1',
      D => \cnt_read[0]_i_1_n_0\,
      Q => cnt_read(0),
      S => areset_d1
    );
\cnt_read_reg[1]\: unisim.vcomponents.FDSE
    generic map(
      INIT => '1'
    )
        port map (
      C => aclk,
      CE => '1',
      D => \cnt_read[1]_i_1_n_0\,
      Q => cnt_read(1),
      S => areset_d1
    );
m_axi_bready_INST_0: unisim.vcomponents.LUT3
    generic map(
      INIT => X"08"
    )
        port map (
      I0 => cnt_read(1),
      I1 => cnt_read(0),
      I2 => mhandshake_r,
      O => m_axi_bready
    );
\memory_reg[3][0]_srl4\: unisim.vcomponents.SRL16E
    generic map(
      INIT => X"0000"
    )
        port map (
      A0 => cnt_read(0),
      A1 => cnt_read(1),
      A2 => '0',
      A3 => '0',
      CE => bresp_push,
      CLK => aclk,
      D => \in\(0),
      Q => \s_bresp_acc_reg[1]\(0)
    );
\memory_reg[3][1]_srl4\: unisim.vcomponents.SRL16E
    generic map(
      INIT => X"0000"
    )
        port map (
      A0 => cnt_read(0),
      A1 => cnt_read(1),
      A2 => '0',
      A3 => '0',
      CE => bresp_push,
      CLK => aclk,
      D => \in\(1),
      Q => \s_bresp_acc_reg[1]\(1)
    );
mhandshake_r_i_1: unisim.vcomponents.LUT4
    generic map(
      INIT => X"4000"
    )
        port map (
      I0 => mhandshake_r,
      I1 => m_axi_bvalid,
      I2 => cnt_read(1),
      I3 => cnt_read(0),
      O => mhandshake
    );
end STRUCTURE;
library IEEE;
use IEEE.STD_LOGIC_1164.ALL;
library UNISIM;
use UNISIM.VCOMPONENTS.ALL;
entity \mid_project_auto_pc_0_axi_protocol_converter_v2_1_18_b2s_simple_fifo__parameterized1\ is
  port (
    m_axi_rready : out STD_LOGIC;
    wr_en0 : out STD_LOGIC;
    rd_a_full : out STD_LOGIC;
    a_full0 : out STD_LOGIC;
    \out\ : out STD_LOGIC_VECTOR ( 33 downto 0 );
    \rd_en__1\ : in STD_LOGIC;
    m_axi_rvalid : in STD_LOGIC;
    \in\ : in STD_LOGIC_VECTOR ( 33 downto 0 );
    aclk : in STD_LOGIC;
    areset_d1 : in STD_LOGIC;
    E : in STD_LOGIC_VECTOR ( 0 to 0 )
  );
  attribute ORIG_REF_NAME : string;
  attribute ORIG_REF_NAME of \mid_project_auto_pc_0_axi_protocol_converter_v2_1_18_b2s_simple_fifo__parameterized1\ : entity is "axi_protocol_converter_v2_1_18_b2s_simple_fifo";
end \mid_project_auto_pc_0_axi_protocol_converter_v2_1_18_b2s_simple_fifo__parameterized1\;
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
