NicholasTran/G8_SwishSwooshSwordSimulator/src/mid_demo/mid_demo.ip_user_files/bd/mid_project/ip/mid_project_auto_pc_8/mid_project_auto_pc_8_sim_netlist.vhdl

-- Copyright 1986-2018 Xilinx, Inc. All Rights Reserved.
-- --------------------------------------------------------------------------------
-- Tool Version: Vivado v.2018.3 (win64) Build 2405991 Thu Dec  6 23:38:27 MST 2018
-- Date        : Sun Mar 12 06:34:16 2023
-- Host        : TheDesktop running 64-bit major release  (build 9200)
-- Command     : write_vhdl -force -mode funcsim -rename_top mid_project_auto_pc_8 -prefix
--               mid_project_auto_pc_8_ mid_project_auto_pc_8_sim_netlist.vhdl
-- Design      : mid_project_auto_pc_8
-- Purpose     : This VHDL netlist is a functional simulation representation of the design and should not be modified or
--               synthesized. This netlist cannot be used for SDF annotated simulation.
-- Device      : xc7a100tcsg324-1
-- --------------------------------------------------------------------------------
library IEEE;
use IEEE.STD_LOGIC_1164.ALL;
library UNISIM;
use UNISIM.VCOMPONENTS.ALL;
entity mid_project_auto_pc_8_axi_protocol_converter_v2_1_18_axi_protocol_converter is
  port (
    aclk : in STD_LOGIC;
    aresetn : in STD_LOGIC;
    s_axi_awid : in STD_LOGIC_VECTOR ( 0 to 0 );
    s_axi_awaddr : in STD_LOGIC_VECTOR ( 31 downto 0 );
    s_axi_awlen : in STD_LOGIC_VECTOR ( 7 downto 0 );
    s_axi_awsize : in STD_LOGIC_VECTOR ( 2 downto 0 );
    s_axi_awburst : in STD_LOGIC_VECTOR ( 1 downto 0 );
    s_axi_awlock : in STD_LOGIC_VECTOR ( 0 to 0 );
    s_axi_awcache : in STD_LOGIC_VECTOR ( 3 downto 0 );
    s_axi_awprot : in STD_LOGIC_VECTOR ( 2 downto 0 );
    s_axi_awregion : in STD_LOGIC_VECTOR ( 3 downto 0 );
    s_axi_awqos : in STD_LOGIC_VECTOR ( 3 downto 0 );
    s_axi_awuser : in STD_LOGIC_VECTOR ( 0 to 0 );
    s_axi_awvalid : in STD_LOGIC;
    s_axi_awready : out STD_LOGIC;
    s_axi_wid : in STD_LOGIC_VECTOR ( 0 to 0 );
    s_axi_wdata : in STD_LOGIC_VECTOR ( 31 downto 0 );
    s_axi_wstrb : in STD_LOGIC_VECTOR ( 3 downto 0 );
    s_axi_wlast : in STD_LOGIC;
    s_axi_wuser : in STD_LOGIC_VECTOR ( 0 to 0 );
    s_axi_wvalid : in STD_LOGIC;
    s_axi_wready : out STD_LOGIC;
    s_axi_bid : out STD_LOGIC_VECTOR ( 0 to 0 );
    s_axi_bresp : out STD_LOGIC_VECTOR ( 1 downto 0 );
    s_axi_buser : out STD_LOGIC_VECTOR ( 0 to 0 );
    s_axi_bvalid : out STD_LOGIC;
    s_axi_bready : in STD_LOGIC;
    s_axi_arid : in STD_LOGIC_VECTOR ( 0 to 0 );
    s_axi_araddr : in STD_LOGIC_VECTOR ( 31 downto 0 );
    s_axi_arlen : in STD_LOGIC_VECTOR ( 7 downto 0 );
    s_axi_arsize : in STD_LOGIC_VECTOR ( 2 downto 0 );
    s_axi_arburst : in STD_LOGIC_VECTOR ( 1 downto 0 );
    s_axi_arlock : in STD_LOGIC_VECTOR ( 0 to 0 );
    s_axi_arcache : in STD_LOGIC_VECTOR ( 3 downto 0 );
    s_axi_arprot : in STD_LOGIC_VECTOR ( 2 downto 0 );
    s_axi_arregion : in STD_LOGIC_VECTOR ( 3 downto 0 );
    s_axi_arqos : in STD_LOGIC_VECTOR ( 3 downto 0 );
    s_axi_aruser : in STD_LOGIC_VECTOR ( 0 to 0 );
    s_axi_arvalid : in STD_LOGIC;
    s_axi_arready : out STD_LOGIC;
    s_axi_rid : out STD_LOGIC_VECTOR ( 0 to 0 );
    s_axi_rdata : out STD_LOGIC_VECTOR ( 31 downto 0 );
    s_axi_rresp : out STD_LOGIC_VECTOR ( 1 downto 0 );
    s_axi_rlast : out STD_LOGIC;
    s_axi_ruser : out STD_LOGIC_VECTOR ( 0 to 0 );
    s_axi_rvalid : out STD_LOGIC;
    s_axi_rready : in STD_LOGIC;
    m_axi_awid : out STD_LOGIC_VECTOR ( 0 to 0 );
    m_axi_awaddr : out STD_LOGIC_VECTOR ( 31 downto 0 );
    m_axi_awlen : out STD_LOGIC_VECTOR ( 7 downto 0 );
    m_axi_awsize : out STD_LOGIC_VECTOR ( 2 downto 0 );
    m_axi_awburst : out STD_LOGIC_VECTOR ( 1 downto 0 );
    m_axi_awlock : out STD_LOGIC_VECTOR ( 0 to 0 );
    m_axi_awcache : out STD_LOGIC_VECTOR ( 3 downto 0 );
    m_axi_awprot : out STD_LOGIC_VECTOR ( 2 downto 0 );
    m_axi_awregion : out STD_LOGIC_VECTOR ( 3 downto 0 );
    m_axi_awqos : out STD_LOGIC_VECTOR ( 3 downto 0 );
    m_axi_awuser : out STD_LOGIC_VECTOR ( 0 to 0 );
    m_axi_awvalid : out STD_LOGIC;
    m_axi_awready : in STD_LOGIC;
    m_axi_wid : out STD_LOGIC_VECTOR ( 0 to 0 );
    m_axi_wdata : out STD_LOGIC_VECTOR ( 31 downto 0 );
    m_axi_wstrb : out STD_LOGIC_VECTOR ( 3 downto 0 );
    m_axi_wlast : out STD_LOGIC;
    m_axi_wuser : out STD_LOGIC_VECTOR ( 0 to 0 );
    m_axi_wvalid : out STD_LOGIC;
    m_axi_wready : in STD_LOGIC;
    m_axi_bid : in STD_LOGIC_VECTOR ( 0 to 0 );
    m_axi_bresp : in STD_LOGIC_VECTOR ( 1 downto 0 );
    m_axi_buser : in STD_LOGIC_VECTOR ( 0 to 0 );
    m_axi_bvalid : in STD_LOGIC;
    m_axi_bready : out STD_LOGIC;
    m_axi_arid : out STD_LOGIC_VECTOR ( 0 to 0 );
    m_axi_araddr : out STD_LOGIC_VECTOR ( 31 downto 0 );
    m_axi_arlen : out STD_LOGIC_VECTOR ( 7 downto 0 );
    m_axi_arsize : out STD_LOGIC_VECTOR ( 2 downto 0 );
    m_axi_arburst : out STD_LOGIC_VECTOR ( 1 downto 0 );
    m_axi_arlock : out STD_LOGIC_VECTOR ( 0 to 0 );
    m_axi_arcache : out STD_LOGIC_VECTOR ( 3 downto 0 );
    m_axi_arprot : out STD_LOGIC_VECTOR ( 2 downto 0 );
    m_axi_arregion : out STD_LOGIC_VECTOR ( 3 downto 0 );
    m_axi_arqos : out STD_LOGIC_VECTOR ( 3 downto 0 );
    m_axi_aruser : out STD_LOGIC_VECTOR ( 0 to 0 );
    m_axi_arvalid : out STD_LOGIC;
    m_axi_arready : in STD_LOGIC;
    m_axi_rid : in STD_LOGIC_VECTOR ( 0 to 0 );
    m_axi_rdata : in STD_LOGIC_VECTOR ( 31 downto 0 );
    m_axi_rresp : in STD_LOGIC_VECTOR ( 1 downto 0 );
    m_axi_rlast : in STD_LOGIC;
    m_axi_ruser : in STD_LOGIC_VECTOR ( 0 to 0 );
    m_axi_rvalid : in STD_LOGIC;
    m_axi_rready : out STD_LOGIC
  );
  attribute C_AXI_ADDR_WIDTH : integer;
  attribute C_AXI_ADDR_WIDTH of mid_project_auto_pc_8_axi_protocol_converter_v2_1_18_axi_protocol_converter : entity is 32;
  attribute C_AXI_ARUSER_WIDTH : integer;
  attribute C_AXI_ARUSER_WIDTH of mid_project_auto_pc_8_axi_protocol_converter_v2_1_18_axi_protocol_converter : entity is 1;
  attribute C_AXI_AWUSER_WIDTH : integer;
  attribute C_AXI_AWUSER_WIDTH of mid_project_auto_pc_8_axi_protocol_converter_v2_1_18_axi_protocol_converter : entity is 1;
  attribute C_AXI_BUSER_WIDTH : integer;
  attribute C_AXI_BUSER_WIDTH of mid_project_auto_pc_8_axi_protocol_converter_v2_1_18_axi_protocol_converter : entity is 1;
  attribute C_AXI_DATA_WIDTH : integer;
  attribute C_AXI_DATA_WIDTH of mid_project_auto_pc_8_axi_protocol_converter_v2_1_18_axi_protocol_converter : entity is 32;
  attribute C_AXI_ID_WIDTH : integer;
  attribute C_AXI_ID_WIDTH of mid_project_auto_pc_8_axi_protocol_converter_v2_1_18_axi_protocol_converter : entity is 1;
  attribute C_AXI_RUSER_WIDTH : integer;
  attribute C_AXI_RUSER_WIDTH of mid_project_auto_pc_8_axi_protocol_converter_v2_1_18_axi_protocol_converter : entity is 1;
  attribute C_AXI_SUPPORTS_READ : integer;
  attribute C_AXI_SUPPORTS_READ of mid_project_auto_pc_8_axi_protocol_converter_v2_1_18_axi_protocol_converter : entity is 1;
  attribute C_AXI_SUPPORTS_USER_SIGNALS : integer;
  attribute C_AXI_SUPPORTS_USER_SIGNALS of mid_project_auto_pc_8_axi_protocol_converter_v2_1_18_axi_protocol_converter : entity is 0;
  attribute C_AXI_SUPPORTS_WRITE : integer;
  attribute C_AXI_SUPPORTS_WRITE of mid_project_auto_pc_8_axi_protocol_converter_v2_1_18_axi_protocol_converter : entity is 1;
  attribute C_AXI_WUSER_WIDTH : integer;
  attribute C_AXI_WUSER_WIDTH of mid_project_auto_pc_8_axi_protocol_converter_v2_1_18_axi_protocol_converter : entity is 1;
  attribute C_FAMILY : string;
  attribute C_FAMILY of mid_project_auto_pc_8_axi_protocol_converter_v2_1_18_axi_protocol_converter : entity is "artix7";
  attribute C_IGNORE_ID : integer;
  attribute C_IGNORE_ID of mid_project_auto_pc_8_axi_protocol_converter_v2_1_18_axi_protocol_converter : entity is 1;
  attribute C_M_AXI_PROTOCOL : integer;
  attribute C_M_AXI_PROTOCOL of mid_project_auto_pc_8_axi_protocol_converter_v2_1_18_axi_protocol_converter : entity is 0;
  attribute C_S_AXI_PROTOCOL : integer;
  attribute C_S_AXI_PROTOCOL of mid_project_auto_pc_8_axi_protocol_converter_v2_1_18_axi_protocol_converter : entity is 2;
  attribute C_TRANSLATION_MODE : integer;
  attribute C_TRANSLATION_MODE of mid_project_auto_pc_8_axi_protocol_converter_v2_1_18_axi_protocol_converter : entity is 2;
  attribute DowngradeIPIdentifiedWarnings : string;
  attribute DowngradeIPIdentifiedWarnings of mid_project_auto_pc_8_axi_protocol_converter_v2_1_18_axi_protocol_converter : entity is "yes";
  attribute P_AXI3 : integer;
  attribute P_AXI3 of mid_project_auto_pc_8_axi_protocol_converter_v2_1_18_axi_protocol_converter : entity is 1;
  attribute P_AXI4 : integer;
  attribute P_AXI4 of mid_project_auto_pc_8_axi_protocol_converter_v2_1_18_axi_protocol_converter : entity is 0;
  attribute P_AXILITE : integer;
  attribute P_AXILITE of mid_project_auto_pc_8_axi_protocol_converter_v2_1_18_axi_protocol_converter : entity is 2;
  attribute P_AXILITE_SIZE : string;
  attribute P_AXILITE_SIZE of mid_project_auto_pc_8_axi_protocol_converter_v2_1_18_axi_protocol_converter : entity is "3'b010";
  attribute P_CONVERSION : integer;
  attribute P_CONVERSION of mid_project_auto_pc_8_axi_protocol_converter_v2_1_18_axi_protocol_converter : entity is 2;
  attribute P_DECERR : string;
  attribute P_DECERR of mid_project_auto_pc_8_axi_protocol_converter_v2_1_18_axi_protocol_converter : entity is "2'b11";
  attribute P_INCR : string;
  attribute P_INCR of mid_project_auto_pc_8_axi_protocol_converter_v2_1_18_axi_protocol_converter : entity is "2'b01";
  attribute P_PROTECTION : integer;
  attribute P_PROTECTION of mid_project_auto_pc_8_axi_protocol_converter_v2_1_18_axi_protocol_converter : entity is 1;
  attribute P_SLVERR : string;
  attribute P_SLVERR of mid_project_auto_pc_8_axi_protocol_converter_v2_1_18_axi_protocol_converter : entity is "2'b10";
end mid_project_auto_pc_8_axi_protocol_converter_v2_1_18_axi_protocol_converter;

architecture STRUCTURE of mid_project_auto_pc_8_axi_protocol_converter_v2_1_18_axi_protocol_converter is
  signal \<const0>\ : STD_LOGIC;
  signal \<const1>\ : STD_LOGIC;
  signal \^m_axi_arready\ : STD_LOGIC;
  signal \^m_axi_awready\ : STD_LOGIC;
  signal \^m_axi_bresp\ : STD_LOGIC_VECTOR ( 1 downto 0 );
  signal \^m_axi_bvalid\ : STD_LOGIC;
  signal \^m_axi_rdata\ : STD_LOGIC_VECTOR ( 31 downto 0 );
  signal \^m_axi_rresp\ : STD_LOGIC_VECTOR ( 1 downto 0 );
  signal \^m_axi_rvalid\ : STD_LOGIC;
  signal \^m_axi_wready\ : STD_LOGIC;
  signal \^s_axi_araddr\ : STD_LOGIC_VECTOR ( 31 downto 0 );
  signal \^s_axi_arprot\ : STD_LOGIC_VECTOR ( 2 downto 0 );
  signal \^s_axi_arvalid\ : STD_LOGIC;
  signal \^s_axi_awaddr\ : STD_LOGIC_VECTOR ( 31 downto 0 );
  signal \^s_axi_awprot\ : STD_LOGIC_VECTOR ( 2 downto 0 );
  signal \^s_axi_awvalid\ : STD_LOGIC;
  signal \^s_axi_bready\ : STD_LOGIC;
  signal \^s_axi_rready\ : STD_LOGIC;
  signal \^s_axi_wdata\ : STD_LOGIC_VECTOR ( 31 downto 0 );
  signal \^s_axi_wstrb\ : STD_LOGIC_VECTOR ( 3 downto 0 );
  signal \^s_axi_wvalid\ : STD_LOGIC;
begin
  \^m_axi_arready\ <= m_axi_arready;
  \^m_axi_awready\ <= m_axi_awready;
  \^m_axi_bresp\(1 downto 0) <= m_axi_bresp(1 downto 0);
  \^m_axi_bvalid\ <= m_axi_bvalid;
  \^m_axi_rdata\(31 downto 0) <= m_axi_rdata(31 downto 0);
  \^m_axi_rresp\(1 downto 0) <= m_axi_rresp(1 downto 0);
  \^m_axi_rvalid\ <= m_axi_rvalid;
  \^m_axi_wready\ <= m_axi_wready;
  \^s_axi_araddr\(31 downto 0) <= s_axi_araddr(31 downto 0);
  \^s_axi_arprot\(2 downto 0) <= s_axi_arprot(2 downto 0);
  \^s_axi_arvalid\ <= s_axi_arvalid;
  \^s_axi_awaddr\(31 downto 0) <= s_axi_awaddr(31 downto 0);
  \^s_axi_awprot\(2 downto 0) <= s_axi_awprot(2 downto 0);
  \^s_axi_awvalid\ <= s_axi_awvalid;
  \^s_axi_bready\ <= s_axi_bready;
  \^s_axi_rready\ <= s_axi_rready;
  \^s_axi_wdata\(31 downto 0) <= s_axi_wdata(31 downto 0);
  \^s_axi_wstrb\(3 downto 0) <= s_axi_wstrb(3 downto 0);
  \^s_axi_wvalid\ <= s_axi_wvalid;
  m_axi_araddr(31 downto 0) <= \^s_axi_araddr\(31 downto 0);
  m_axi_arburst(1) <= \<const0>\;
  m_axi_arburst(0) <= \<const1>\;
  m_axi_arcache(3) <= \<const0>\;
  m_axi_arcache(2) <= \<const0>\;
  m_axi_arcache(1) <= \<const0>\;
  m_axi_arcache(0) <= \<const0>\;
  m_axi_arid(0) <= \<const0>\;
  m_axi_arlen(7) <= \<const0>\;
  m_axi_arlen(6) <= \<const0>\;
  m_axi_arlen(5) <= \<const0>\;
  m_axi_arlen(4) <= \<const0>\;
  m_axi_arlen(3) <= \<const0>\;
  m_axi_arlen(2) <= \<const0>\;
  m_axi_arlen(1) <= \<const0>\;
  m_axi_arlen(0) <= \<const0>\;
  m_axi_arlock(0) <= \<const0>\;
  m_axi_arprot(2 downto 0) <= \^s_axi_arprot\(2 downto 0);
  m_axi_arqos(3) <= \<const0>\;
  m_axi_arqos(2) <= \<const0>\;
  m_axi_arqos(1) <= \<const0>\;
  m_axi_arqos(0) <= \<const0>\;
  m_axi_arregion(3) <= \<const0>\;
  m_axi_arregion(2) <= \<const0>\;
  m_axi_arregion(1) <= \<const0>\;
  m_axi_arregion(0) <= \<const0>\;
  m_axi_arsize(2) <= \<const0>\;
  m_axi_arsize(1) <= \<const1>\;
  m_axi_arsize(0) <= \<const0>\;
  m_axi_aruser(0) <= \<const0>\;
  m_axi_arvalid <= \^s_axi_arvalid\;
  m_axi_awaddr(31 downto 0) <= \^s_axi_awaddr\(31 downto 0);
  m_axi_awburst(1) <= \<const0>\;
  m_axi_awburst(0) <= \<const1>\;
  m_axi_awcache(3) <= \<const0>\;
  m_axi_awcache(2) <= \<const0>\;
  m_axi_awcache(1) <= \<const0>\;
  m_axi_awcache(0) <= \<const0>\;
  m_axi_awid(0) <= \<const0>\;
  m_axi_awlen(7) <= \<const0>\;
  m_axi_awlen(6) <= \<const0>\;
  m_axi_awlen(5) <= \<const0>\;
  m_axi_awlen(4) <= \<const0>\;
  m_axi_awlen(3) <= \<const0>\;
  m_axi_awlen(2) <= \<const0>\;
  m_axi_awlen(1) <= \<const0>\;
  m_axi_awlen(0) <= \<const0>\;
  m_axi_awlock(0) <= \<const0>\;
  m_axi_awprot(2 downto 0) <= \^s_axi_awprot\(2 downto 0);
  m_axi_awqos(3) <= \<const0>\;
  m_axi_awqos(2) <= \<const0>\;
  m_axi_awqos(1) <= \<const0>\;
  m_axi_awqos(0) <= \<const0>\;
  m_axi_awregion(3) <= \<const0>\;
  m_axi_awregion(2) <= \<const0>\;
  m_axi_awregion(1) <= \<const0>\;
  m_axi_awregion(0) <= \<const0>\;
  m_axi_awsize(2) <= \<const0>\;
  m_axi_awsize(1) <= \<const1>\;
  m_axi_awsize(0) <= \<const0>\;
  m_axi_awuser(0) <= \<const0>\;
  m_axi_awvalid <= \^s_axi_awvalid\;
  m_axi_bready <= \^s_axi_bready\;
  m_axi_rready <= \^s_axi_rready\;
  m_axi_wdata(31 downto 0) <= \^s_axi_wdata\(31 downto 0);
  m_axi_wid(0) <= \<const0>\;
  m_axi_wlast <= \<const1>\;
  m_axi_wstrb(3 downto 0) <= \^s_axi_wstrb\(3 downto 0);
  m_axi_wuser(0) <= \<const0>\;
  m_axi_wvalid <= \^s_axi_wvalid\;
  s_axi_arready <= \^m_axi_arready\;
  s_axi_awready <= \^m_axi_awready\;
  s_axi_bid(0) <= \<const0>\;
  s_axi_bresp(1 downto 0) <= \^m_axi_bresp\(1 downto 0);
  s_axi_buser(0) <= \<const0>\;
  s_axi_bvalid <= \^m_axi_bvalid\;
  s_axi_rdata(31 downto 0) <= \^m_axi_rdata\(31 downto 0);
  s_axi_rid(0) <= \<const0>\;
  s_axi_rlast <= \<const1>\;
  s_axi_rresp(1 downto 0) <= \^m_axi_rresp\(1 downto 0);
  s_axi_ruser(0) <= \<const0>\;
  s_axi_rvalid <= \^m_axi_rvalid\;
  s_axi_wready <= \^m_axi_wready\;
GND: unisim.vcomponents.GND
     port map (
      G => \<const0>\
    );
VCC: unisim.vcomponents.VCC
     port map (
      P => \<const1>\
    );
end STRUCTURE;
library IEEE;
use IEEE.STD_LOGIC_1164.ALL;
library UNISIM;
use UNISIM.VCOMPONENTS.ALL;
entity mid_project_auto_pc_8 is
  port (
    aclk : in STD_LOGIC;
    aresetn : in STD_LOGIC;
    s_axi_awaddr : in STD_LOGIC_VECTOR ( 31 downto 0 );
    s_axi_awprot : in STD_LOGIC_VECTOR ( 2 downto 0 );
    s_axi_awvalid : in STD_LOGIC;
    s_axi_awready : out STD_LOGIC;
    s_axi_wdata : in STD_LOGIC_VECTOR ( 31 downto 0 );
    s_axi_wstrb : in STD_LOGIC_VECTOR ( 3 downto 0 );
    s_axi_wvalid : in STD_LOGIC;
    s_axi_wready : out STD_LOGIC;
    s_axi_bresp : out STD_LOGIC_VECTOR ( 1 downto 0 );
    s_axi_bvalid : out STD_LOGIC;
    s_axi_bready : in STD_LOGIC;
    s_axi_araddr : in STD_LOGIC_VECTOR ( 31 downto 0 );
    s_axi_arprot : in STD_LOGIC_VECTOR ( 2 downto 0 );
    s_axi_arvalid : in STD_LOGIC;
    s_axi_arready : out STD_LOGIC;
    s_axi_rdata : out STD_LOGIC_VECTOR ( 31 downto 0 );
    s_axi_rresp : out STD_LOGIC_VECTOR ( 1 downto 0 );
    s_axi_rvalid : out STD_LOGIC;
    s_axi_rready : in STD_LOGIC;
    m_axi_awaddr : out STD_LOGIC_VECTOR ( 31 downto 0 );
    m_axi_awlen : out STD_LOGIC_VECTOR ( 7 downto 0 );
    m_axi_awsize : out STD_LOGIC_VECTOR ( 2 downto 0 );
    m_axi_awburst : out STD_LOGIC_VECTOR ( 1 downto 0 );
    m_axi_awlock : out STD_LOGIC_VECTOR ( 0 to 0 );
    m_axi_awcache : out STD_LOGIC_VECTOR ( 3 downto 0 );
    m_axi_awprot : out STD_LOGIC_VECTOR ( 2 downto 0 );
    m_axi_awregion : out STD_LOGIC_VECTOR ( 3 downto 0 );
    m_axi_awqos : out STD_LOGIC_VECTOR ( 3 downto 0 );
    m_axi_awvalid : out STD_LOGIC;
    m_axi_awready : in STD_LOGIC;
    m_axi_wdata : out STD_LOGIC_VECTOR ( 31 downto 0 );
    m_axi_wstrb : out STD_LOGIC_VECTOR ( 3 downto 0 );
    m_axi_wlast : out STD_LOGIC;
    m_axi_wvalid : out STD_LOGIC;
    m_axi_wready : in STD_LOGIC;
    m_axi_bresp : in STD_LOGIC_VECTOR ( 1 downto 0 );
    m_axi_bvalid : in STD_LOGIC;
    m_axi_bready : out STD_LOGIC;
    m_axi_araddr : out STD_LOGIC_VECTOR ( 31 downto 0 );
    m_axi_arlen : out STD_LOGIC_VECTOR ( 7 downto 0 );
    m_axi_arsize : out STD_LOGIC_VECTOR ( 2 downto 0 );
    m_axi_arburst : out STD_LOGIC_VECTOR ( 1 downto 0 );
    m_axi_arlock : out STD_LOGIC_VECTOR ( 0 to 0 );
    m_axi_arcache : out STD_LOGIC_VECTOR ( 3 downto 0 );
    m_axi_arprot : out STD_LOGIC_VECTOR ( 2 downto 0 );
    m_axi_arregion : out STD_LOGIC_VECTOR ( 3 downto 0 );
    m_axi_arqos : out STD_LOGIC_VECTOR ( 3 downto 0 );
    m_axi_arvalid : out STD_LOGIC;
    m_axi_arready : in STD_LOGIC;
    m_axi_rdata : in STD_LOGIC_VECTOR ( 31 downto 0 );
    m_axi_rresp : in STD_LOGIC_VECTOR ( 1 downto 0 );
    m_axi_rlast : in STD_LOGIC;
    m_axi_rvalid : in STD_LOGIC;
    m_axi_rready : out STD_LOGIC
  );
  attribute NotValidForBitStream : boolean;
  attribute NotValidForBitStream of mid_project_auto_pc_8 : entity is true;
  attribute CHECK_LICENSE_TYPE : string;
  attribute CHECK_LICENSE_TYPE of mid_project_auto_pc_8 : entity is "mid_project_auto_pc_8,axi_protocol_converter_v2_1_18_axi_protocol_converter,{}";
  attribute DowngradeIPIdentifiedWarnings : string;
  attribute DowngradeIPIdentifiedWarnings of mid_project_auto_pc_8 : entity is "yes";
  attribute X_CORE_INFO : string;
  attribute X_CORE_INFO of mid_project_auto_pc_8 : entity is "axi_protocol_converter_v2_1_18_axi_protocol_converter,Vivado 2018.3";
end mid_project_auto_pc_8;
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
