NicholasTran/G8_SwishSwooshSwordSimulator/src/mid_demo/mid_demo.ip_user_files/bd/mid_project/ip/mid_project_auto_rs_0/mid_project_auto_rs_0_sim_netlist.vhdl

-- Copyright 1986-2018 Xilinx, Inc. All Rights Reserved.
-- --------------------------------------------------------------------------------
-- Tool Version: Vivado v.2018.3 (win64) Build 2405991 Thu Dec  6 23:38:27 MST 2018
-- Date        : Sun Mar 12 06:35:07 2023
-- Host        : TheDesktop running 64-bit major release  (build 9200)
-- Command     : write_vhdl -force -mode funcsim -rename_top mid_project_auto_rs_0 -prefix
--               mid_project_auto_rs_0_ mid_project_auto_rs_1_sim_netlist.vhdl
-- Design      : mid_project_auto_rs_1
-- Purpose     : This VHDL netlist is a functional simulation representation of the design and should not be modified or
--               synthesized. This netlist cannot be used for SDF annotated simulation.
-- Device      : xc7a100tcsg324-1
-- --------------------------------------------------------------------------------
library IEEE;
use IEEE.STD_LOGIC_1164.ALL;
library UNISIM;
use UNISIM.VCOMPONENTS.ALL;
entity mid_project_auto_rs_0_axi_register_slice_v2_1_18_axic_register_slice is
  port (
    m_axi_arvalid : out STD_LOGIC;
    s_axi_arready : out STD_LOGIC;
    Q : out STD_LOGIC_VECTOR ( 61 downto 0 );
    p_0_in : in STD_LOGIC;
    aclk : in STD_LOGIC;
    p_1_in : in STD_LOGIC;
    s_axi_arvalid : in STD_LOGIC;
    m_axi_arready : in STD_LOGIC;
    s_ready_i_reg_0 : in STD_LOGIC;
    D : in STD_LOGIC_VECTOR ( 61 downto 0 )
  );
end mid_project_auto_rs_0_axi_register_slice_v2_1_18_axic_register_slice;

architecture STRUCTURE of mid_project_auto_rs_0_axi_register_slice_v2_1_18_axic_register_slice is
  signal \^m_axi_arvalid\ : STD_LOGIC;
  signal \m_payload_i[53]_i_1__0_n_0\ : STD_LOGIC;
  signal \m_valid_i_i_1__1_n_0\ : STD_LOGIC;
  signal \^s_axi_arready\ : STD_LOGIC;
  signal \s_ready_i_i_1__1_n_0\ : STD_LOGIC;
begin
  m_axi_arvalid <= \^m_axi_arvalid\;
  s_axi_arready <= \^s_axi_arready\;
\m_payload_i[53]_i_1__0\: unisim.vcomponents.LUT1
    generic map(
      INIT => X"1"
    )
        port map (
      I0 => \^m_axi_arvalid\,
      O => \m_payload_i[53]_i_1__0_n_0\
    );
\m_payload_i_reg[0]\: unisim.vcomponents.FDRE
     port map (
      C => aclk,
      CE => \m_payload_i[53]_i_1__0_n_0\,
      D => D(0),
      Q => Q(0),
      R => '0'
    );
\m_payload_i_reg[10]\: unisim.vcomponents.FDRE
     port map (
      C => aclk,
      CE => \m_payload_i[53]_i_1__0_n_0\,
      D => D(10),
      Q => Q(10),
      R => '0'
    );
\m_payload_i_reg[11]\: unisim.vcomponents.FDRE
     port map (
      C => aclk,
      CE => \m_payload_i[53]_i_1__0_n_0\,
      D => D(11),
      Q => Q(11),
      R => '0'
    );
\m_payload_i_reg[12]\: unisim.vcomponents.FDRE
     port map (
      C => aclk,
      CE => \m_payload_i[53]_i_1__0_n_0\,
      D => D(12),
      Q => Q(12),
      R => '0'
    );
\m_payload_i_reg[13]\: unisim.vcomponents.FDRE
     port map (
      C => aclk,
      CE => \m_payload_i[53]_i_1__0_n_0\,
      D => D(13),
      Q => Q(13),
      R => '0'
    );
\m_payload_i_reg[14]\: unisim.vcomponents.FDRE
     port map (
      C => aclk,
      CE => \m_payload_i[53]_i_1__0_n_0\,
      D => D(14),
      Q => Q(14),
      R => '0'
    );
\m_payload_i_reg[15]\: unisim.vcomponents.FDRE
     port map (
      C => aclk,
      CE => \m_payload_i[53]_i_1__0_n_0\,
      D => D(15),
      Q => Q(15),
      R => '0'
    );
\m_payload_i_reg[16]\: unisim.vcomponents.FDRE
     port map (
      C => aclk,
      CE => \m_payload_i[53]_i_1__0_n_0\,
      D => D(16),
      Q => Q(16),
      R => '0'
    );
\m_payload_i_reg[17]\: unisim.vcomponents.FDRE
     port map (
      C => aclk,
      CE => \m_payload_i[53]_i_1__0_n_0\,
      D => D(17),
      Q => Q(17),
      R => '0'
    );
\m_payload_i_reg[18]\: unisim.vcomponents.FDRE
     port map (
      C => aclk,
      CE => \m_payload_i[53]_i_1__0_n_0\,
      D => D(18),
      Q => Q(18),
      R => '0'
    );
\m_payload_i_reg[19]\: unisim.vcomponents.FDRE
     port map (
      C => aclk,
      CE => \m_payload_i[53]_i_1__0_n_0\,
      D => D(19),
      Q => Q(19),
      R => '0'
    );
\m_payload_i_reg[1]\: unisim.vcomponents.FDRE
     port map (
      C => aclk,
      CE => \m_payload_i[53]_i_1__0_n_0\,
      D => D(1),
      Q => Q(1),
      R => '0'
    );
\m_payload_i_reg[20]\: unisim.vcomponents.FDRE
     port map (
      C => aclk,
      CE => \m_payload_i[53]_i_1__0_n_0\,
      D => D(20),
      Q => Q(20),
      R => '0'
    );
\m_payload_i_reg[21]\: unisim.vcomponents.FDRE
     port map (
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
      CE => \m_payload_i[53]_i_1__0_n_0\,
      D => D(53),
      Q => Q(53),
      R => '0'
    );
\m_payload_i_reg[54]\: unisim.vcomponents.FDRE
     port map (
      C => aclk,
      CE => \m_payload_i[53]_i_1__0_n_0\,
      D => D(54),
      Q => Q(54),
      R => '0'
    );
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
